Hive-RSI-Lab/ece298a-pll/blocks/pll/tb/README.md

# PLL loop verification (top level, `blocks/pll/tb`)

The proposal's verification plan (section 5) and GOALS.md test the whole loop
in three layers. All three run from one command:

    . $HIVE_BOX/cf.env            # or set CHIP_FLOW_HOME
    $CHIP_FLOW_HOME/bin/eda python blocks/pll/tb/run_layers.py   # ~2.5 min

| Layer | What runs | Script | Output |
|---|---|---|---|
| 1 linear model | open-loop H(s) from the calibrated Icp, Kvco, R1/C1/C2 | `pll_loop_model.py` | `reports/loop_model.json` |
| 2 RTL + calibrated model | released RTL in cocotb/Icarus, pump/filter/VCO as a behavioural ngspice model calibrated from the real netlist | `test_pll_cosim.py` with `PLL_COSIM_KIND=ideal` | `reports/cosim_measures_ideal.json` |
| 3 RTL + transistor cell (the msde `cosim` gate) | released RTL + `analog/netlist/pll_analog.cir` (GF180 models, `sizing.yaml`) in ngspice through cocotbext-ams | `check_cosim.py` on `cosim_bench.json` | `reports/cosim_measures.json` |

Calibration (run it again whenever the analog netlist or sizing changes):

    $CHIP_FLOW_HOME/bin/eda python blocks/pll/tb/calibrate_analog.py

This script measures the real cell at tt_27c in batch ngspice. It writes `pll_analog_cal.json` and regenerates
`pll_analog_ideal.sp` from it.

## Operating point and bounds

Nominal point from the brief: f_ref = 6.25 MHz, n_sel = 2 (P*N = 16), so
f_vco = 100 MHz. Also cp_trim = 00, obs_sel = 0, tt_27c, 3.3 V. rst_n and pll_en_in
are released at 320 ns. The run lasts 30 us. Bounds (`pll_cosim.bounds.json`)
come from the specs, never from results:

| Measure | Bound | Source |
|---|---|---|
| `lock_time_us` (pll_en rise to first lock rise) | <= 50 | digital REQ-LOOP-LOCK; analog spec "Out of scope here"; brief |
| `lock_drops_after_lock` | 0 | lock must hold once asserted (REQ-LOCK-*) |
| `fb_period_rel_err` (mean clk_fb period vs T_ref, last 10 us) | <= 1e-3 | REQ-LOOP-FREQ: divided frequency equals the reference |
| `vco_period_rel_err` (mean vco_out period vs T_ref/16) | <= 1e-3 | REQ-LOOP-FREQ |
| `vctrl_pp_last_10us_mv` (every 5 ns sample of the filter node) | <= 20 | REQ-LOOP-VCTRL |

## Results (2026-10-28)

Calibration of the real cell at tt_27c: Icp up/down = 19.01 / 18.66 uA (the same values as the analog
gate). The fitted filter is R1 = 27.0 kOhm (the brief's 22 k is an estimate; ppolyf_u
150 um x 2 um gives about 26 k), C1 = 20.0 pF and C2 = 2.14 pF (V2I gate included). The VCO reaches
100 MHz at vctrl = 1.634 V, with a local Kvco of 116 MHz/V there.

| | Layer 1 | Layer 2 (ideal) | Layer 3 (transistor) |
|---|---|---|---|
| lock time | settle 4/(zeta wn) = 2.2 us | 4.80 us | **4.48 us** |
| f_fb / f_vco | - | 6.2499 / 99.999 MHz | **6.250000 / 100.000 MHz** |
| vctrl at lock | - | 1.634 V, 18.3 mV p-p | 1.6341 V, 0.003 mV p-p |
| PM / fc (P*N=16, no pad) | 52.4 deg / 585 kHz (f_ref/10.7), zeta 0.71 | - | - |
| wall time | <1 s | ~10 s | ~95 s |

Layer 1 sweep: the phase margin is 55 / 52 / 47 / 43 / 40 deg at P*N = 8 / 16 / 24 / 32 / 40, and
35 deg at P*N = 16 with 5 pF on vctrl. These line up with the analog gate's .ac
numbers (49.5 / 55.3 / 35.9 deg; that gate uses the mean Kvco over the range rather than the
local slope).

## Bench notes

- The digital side is the released RTL. `tb/*.v` symlinks point into `../digital/rtl`,
  and Icarus compiles the SIM path, which has a zero-delay PFD reset. `pll_cosim_top.v` carries the
  crossing nets under their `interface.yaml` names, so the bridge binds them by
  name.
- `pll_analog_tr.sp` reorders the cell's pins into the bridge's order. It loads
  the cell, the PDK models and `sizing.yaml` (paths are resolved at run time). It leaves vctrl
  without a pad, which is the analog spec's nominal loop condition. It puts the **ua[1] pad
  capacitance (5 pF) on bias_ref**. Without any capacitance on bias_ref,
  the bias reference relaxes after pll_en rises (see OPEN in the integrator report).
  The decks that show this are in `log/scratch/bias/`.
- Two bench-side fixes to cocotbext-ams, both in `test_pll_cosim.py`. Neither changes what the bridge
  measures:
  1. *Sync rounding.* The stock sync callback clamps ngspice's step to
     `next_sync - t`. When `t` lands one float rounding short (about 1e-25 s), the clamp
     produces "Timestep too small" and the transient aborts. This is the open quirk in
     `docs/spikes/dcosim.md`. A remainder under 1 fs now counts as reached.
  2. *Write on change.* The stock bridge re-forces vco_out at every sync. Doing that
     at 1 ns syncs crashed vvp (SIGSEGV) after a few hundred forces. vco_out is now
     a reg that is written only when its digitized value changes.
  There is also one timing refinement: a sync is placed 2 ps after every clk rising edge, so
  a PFD edge launched by the reference reaches the pump at once rather than up
  to one sync interval (1 ns) late.
- Resolution: digital edge times sit on the bridge's sync grid (at most 1 ns). Over
  the 10 us window that limits the period measures to about 1e-4, which is ten times finer than
  their 1e-3 bound.
- With the zero-delay RTL PFD there is a dead zone. Once locked, the pump gets
  almost no charge, so vctrl sits flat. The reset-pulse width only exists in the
  gate-level netlist, which this bench does not simulate.
- Not covered yet: other (f_ref, N) points, relock after a change of N, and
  the vctrl pad cap. The bench takes them as parameters (`pll_tb_common.py`,
  `calibrate_analog.py --corner`), but only the nominal point is gated.
  The corners are run on the extracted netlist by `cosim_corners.py` (below).
- Debug knobs, which are not used by the gate: `PLL_COSIM_DURATION_NS`,
  `PLL_COSIM_ANALOG_VCD=<file>` with `PLL_COSIM_DEBUG_NODES=x1.xpll.xcell.vref,...`.

## The loop on the extracted netlist at the corners that bound its range (2026-10-30)

`cosim_corners.py` runs layer 3's bench (`test_pll_cosim.py`, same 100 MHz
point, same bounds and evidence checks as the cosim gate) with the cell
swapped for the layout's parasitic extraction
(`analog/log/pex_pvt/pll_analog.pex.ordered.spice`, extracted when missing)
and the PDK corner, temperature and supply moved to each corner. The bench
reads the move from `PLL_COSIM_SETUP` and the gate never sets it. The
corners are the ones that bound the post-layout sweep
(`analog/reports/recorded/pex_pvt.json`; `bounding_corners()`):

    $CHIP_FLOW_HOME/bin/eda python blocks/pll/tb/cosim_corners.py   # ~25-70 min, 6 corners side by side

A corner takes 25-30 minutes of wall time on a loaded machine (about 50 s
per simulated us, against 3 s for the schematic cell). The result is
recorded in `../reports/recorded/cosim_corners.json` with a hash of every
input. `tests/score.py` counts it only while those hashes hold, as it does
bench_strength's. `--from-logs` rewrites that report from the last run's
`log/cosim_corners/<corner>/result.json` without running anything.

| Corner | Why it bounds the range | Lock | Relock to 150 MHz (N 2->3) | f_vco (MHz) | vctrl mean (V) | vctrl p-p, last 10 us (mV) |
|---|---|---|---|---|---|---|
| ff_pss | lowest Icp 13.6 uA, ceiling 168.2 MHz | 7.20 us, held | 3.44 us | 100.0004 | 2.395 | **23.1** |
| ff_m40c_vm10 | highest ceiling 298.4 MHz | 4.00 us, held | 3.12 us | 100.0004 | 1.546 | 16.7 |
| ff_125c_vp10 | lowest phase margin 40.5 deg | 4.48 us, held | 3.60 us | 100.0000 | 1.864 | 18.0 |
| ss_m40c_vm10 | highest phase margin 51.5 deg | 5.12 us, held | 3.60 us | 99.9999 | 1.940 | 12.3 |
| tt_27c | nominal | 5.12 us, held | 3.60 us | 99.9999 | 1.945 | 12.2 |
| ss_125c_vm10 | lowest ceiling 183.1 MHz | 5.76 us, held | 3.76 us | 100.0000 | 1.953 | 9.7 |
| ss_125c_vp10 | lowest Kvco 53.8 MHz/V | 6.40 us, held | 4.08 us | 100.0030 | 2.412 | 16.1 |

Re-run 2026-11-04 on the V2I/clamp resize (rv2i_l 43 um, clamp 50/1 um),
which lifts the ff_pss ceiling from 125.6 to 168.2 MHz so it relocks to
150 MHz. The loop locks and holds at all seven corners (the six bounding
corners and tt_27c), relocks after the N 2->3 step within 4.1 us, and f_vco is within 1e-5 of its target (bound
1e-3). ff_pss is the one corner over REQ-LOOP-VCTRL's 20 mV p-p, which this
bench keeps as it is. That is not drift: it is isolated pump correction
kicks seen through R1. They come from the bench's zero-delay PFD (its dead
zone, see the bench notes) and from edges quantised to the sync grid. The
gate-level PFD's reset pulse removes them: the same corner reads 2.6 mV
with the gate-level digital (next section).

## With the hardened gate-level digital in the loop (issue #47, 2026-10-31)

`cosim_gl.py` is `cosim_corners.py` with one change: in place of the RTL, the
digital half is the vde harden's gate-level netlist with the PDK's cell
models and an SDF of the corner's process at the nearest characterised
temperature (`sdf_corner_for`). Same bench, operating point, bounds, extracted
analog cell, PDK corner and 0.25 ns sync. The netlist, SDC, SPEF and SDFs it
reads are committed in `gl/`; `--snapshot` refreshes them from a new harden.
`*.gen.sdf` are written by `gl/gen_sdf.tcl`, which LibreLane does not cover.

    $CHIP_FLOW_HOME/bin/eda python blocks/pll/tb/cosim_gl.py   # ~40-50 min, 6 corners side by side

Re-run 2026-11-04 on the V2I/clamp resize, SDF by process and nearest
temperature (`../reports/recorded/cosim_corners_gl.json`, 6/6 pass, all six
bounding corners):

| Corner | Lock | Relock to 150 MHz | f_vco, GL (MHz) | vctrl p-p, RTL / GL (mV) | static phase offset, GL (ns) |
|---|---|---|---|---|---|
| ff_pss | 7.20 us | 4.88 us | 99.9999 | **23.1** / 2.6 | 0.60 |
| ff_m40c_vm10 | 4.00 us | 3.12 us | 100.0021 | 16.7 / 7.2 | 0.90 |
| ff_125c_vp10 | 4.80 us | 3.60 us | 100.0006 | 18.0 / 13.4 | 1.06 |
| ss_m40c_vm10 | 5.12 us | 3.61 us | 100.0004 | 12.3 / 4.6 | 2.37 |
| ss_125c_vm10 | 5.76 us | 3.93 us | 100.0005 | 9.7 / 13.9 | 3.17 |
| ss_125c_vp10 | 6.56 us | 4.09 us | 100.0000 | 16.1 / 15.0 | 3.29 |

The earlier runs, before the resize:

Both runs below are on the TSPC /2 macro (#48) and its extraction, at 0.25 ns
sync. In each pair the RTL comes first and the gate-level run second. The
gate-level column is the first run, SDF by process only
(`../reports/recorded/cosim_corners_gl_sdf_by_process.json`); the matched-temperature
results are under "Outside review follow-ups" below:

| Corner | Lock | f_vco, GL (MHz) | vctrl p-p, RTL (5 ns / ref edges, mV) | vctrl p-p, GL (5 ns / ref edges, mV) | static phase offset (ns) |
|---|---|---|---|---|---|
| ff_pss | 6.72 / 6.72 us | 99.9998 | **27.0** / 1.88 | 2.4 / 0.35 | 0.15 / 0.87 |
| ff_m40c_vm10 | 4.00 / 4.00 us | 100.0009 | **20.3** / 8.37 | 7.2 / 0.91 | 0.10 / 0.89 |
| ff_125c_vp10 | 4.48 / 4.48 us | 100.0005 | 16.9 / 0.03 | 3.5 / 0.38 | 0.15 / 0.85 |
| ss_m40c_vm10 | 4.96 / 5.12 us | 100.0006 | 14.9 / 7.45 | 15.9 / 13.69 | 0.06 / 2.99 |

With the gate-level digital, every corner locks, holds and settles within
REQ-LOOP-VCTRL's 20 mV (`../reports/recorded/cosim_corners_gl.json`, 4/4).
The RTL run on the same cell and the same 0.25 ns grid still misses at
ff_pss and ff_m40c_vm10. So the finer grid H1 found was not enough on its own
after #48. What removes the kicks is the gate-level PFD: its reset path
has a real delay, so both pumps are on together for a short pulse every
cycle (the ~0.9 ns static phase offset is that pulse and the pump mismatch).
With the RTL's zero-delay reset there is no overlap and no reset pulse. One
pump fires alone for whatever phase error is left, rounded to the sync grid,
and that lone current through R1 is the 20-27 mV spike. Sampled at the
reference edges, the RTL's vctrl moves only 0.03-8 mV. The gate-level run is
the one that matches the chip. `tests/score.py` reads it for the "vctrl
settles" line and the RTL run for the lock line. Its freshness check covers
the same tracked inputs plus `cosim_gl.py`, and the netlist and SDF hashes
where `runs/` is present.

At ss_m40c_vm10 the gate-level run has 15.9 mV p-p, with 13.7 mV of it at
the reference edges. That is not a spike through R1. Its trace steps about
7 mV down near 21 us and back up near 24.5 us, and is flat in between: two
corrections that each move the filter capacitor. It passes the bound with
4 mV to spare. It is the corner to watch if the pump or the filter changes.

## Outside review follow-ups (2026-11-01)

From an outside review of the paper (`docs/paper/`). All on the extracted cell
with the gate-level digital. Numbers are recorded in `../reports/recorded/`.

**SDF matched on temperature** (`cosim_corners_gl.json`, 4/4 pass). ff_pss and
ff_m40c_vm10 read the same SDF as before and reproduce exactly. ff_125c_vp10
goes from 3.5 to 13.5 mV p-p and ss_m40c_vm10 from 15.9 to 9.1 mV, so the ripple
depends on the digital delays. ff_pss (27 C) still uses -40 C delays, the
nearest, and the libraries tie voltage to process.

**5 pF on vctrl** (`cosim_gl.py --vctrl-pad-pf 5`,
`cosim_corners_gl_pad5pf.json`, 5/5 pass): lock 4.16-7.52 us, ripple 0.8-4.5 mV.
Small-signal, `layout/pex_pvt.py --extracted <the pad netlist>`
(`pex_pvt_pad5pf.json`; its "fails" are that bench's no-pad 30 deg floor, which
it was not written for): minimum 23.9 deg at ff_125c_vp10, 9 of 31 under 30.

**Divider steps, before the V2I/clamp resize** (`cosim_cov.py`, bench
`cov/test_pll_cov.py`; this run's `cosim_cov.json` has since been replaced by
the final-cell run below, see git history): f_ref 5 MHz, N 1->3->2, 20 us each.
4/5 corners pass. ff_pss misses at 120 MHz,
near its 125.6 MHz ceiling: vctrl winds up to 3.5 V and LOCK pulses before it
settles. `cosim_cov_cases.py` (`cosim_cov_cases.json`) gives it longer: within
20 mV about 25 us after the step, with or without the pad, and when
acquiring 120 MHz directly. No 20 mV bound is applied to these segments, and
some would miss it (24.8 mV at tt_27c).

**Relock to 150 MHz after the V2I/clamp resize** (2026-11-04,
`cosim_cov.py --plan '{"f_ref_hz": 6.25e6, "segments": [[0, 2], [20000, 3], [40000, 2]], "duration_ns": 60000}'`,
`cosim_cov_150.json`, gate-level, 5/5 pass). The resize lifts the ff_pss
post-layout ceiling from 125.6 to 168.2 MHz, and ff_pss now acquires
100 MHz in 7.20 us, relocks to 150 MHz in 4.88 us and back to 100 MHz in
4.72 us. The other corners relock in 3.1-3.8 us. The frequency error is
under 7.4e-5 at every step. The 120 MHz miss above is from before the resize.
N=4 (160 MHz) with the pad at ff_125c_vp10 misses in 30 us and settles with time
(`cosim_cov_pn32_pad5p_long.json`, 80 us: within 20 mV by 27 us).

**Final cell at f_ref 5 MHz** (2026-11-05, analog e687a1c, gate level + SDF,
no pad, 7 corners: the six bounding ones plus tt_27c):

- N 1->3->2 (`cosim_cov.json`): 7/7 pass. Relock at 120 MHz in 4.5-6.7 us
  (ff_pss slowest), at 80 MHz within 5.1 us; ripple at 120 MHz 8.0-23.5 mV
  (not bounded by this bench).
- N=4, 160 MHz from reset (`cosim_cov_n4.json`, logs in `log/cosim_cov_n4/`):
  7/7 lock in 5.2-10.2 us (ff_pss slowest, vctrl 3.22 V), no lock falls,
  ripple 7.2-22.5 mV.
- N=5, 200 MHz from reset (`cosim_cov_n5.json`, logs in `log/cosim_cov_n5/`):
  3/7. ff_m40c_vm10 5.6 us, ff_125c_vp10 5.8 us, tt_27c 7.2 us. At
  ss_125c_vm10, ss_125c_vp10 and ff_pss vctrl ends within 25 mV of VDD and the
  VCO stops at 182.1, 183.8 and 188.9 MHz; ss_m40c_vm10 reaches 198.7 MHz,
  raises LOCK at 18.8 us and drops it. The 200 MHz lock-table points are at or above
  the VCO's range at these corners.

`cosim_cov.py` writes its per-corner logs to `log/cosim_cov/` whatever `--out`
says, so each run overwrites the last; the N=4 and N=5 logs were moved by hand.
The JSON records keep every run's full measures.

### Closed loop with a mismatched pump (`cosim_pump.py`)

The Monte Carlo (`../analog/mc/README.md`) puts UP/DN mismatch over its 10 % bound at
ff_pss and ff_m40c_vp10. Here one pump source is widened by about 3 sigma in a copy of the
extracted netlist, and the gate-level closed loop runs at 100 MHz. `dc` is the cp bench's
sweep on that copy (Monte Carlo worst: 14.55, 12.38).

| Case | dc mismatch (%) | Lock (us) | vctrl p-p, last 10 us (mV) | Static phase offset (ns) |
|---|---|---|---|---|
| ff_pss, unskewed (`cosim_corners_gl.json`) | 8.69 (schematic) | 6.72 | 2.43 | 0.87 |
| ff_pss, UP +6 % | 14.21 | 6.56 | 0.98 | 0.44 |
| ff_pss, DN +6 % | 5.59 | 6.72 | 2.54 | 0.65 |
| ff_m40c_vp10, unskewed | 7.30 | 4.16 | 5.41 | 0.85 |
| ff_m40c_vp10, UP +5 % | 12.08 | 4.00 | 3.29 | 0.60 |
| ff_m40c_vp10, DN +5 % | 5.68 | 4.16 | 6.26 | 0.98 |

All lock and hold, inside the 20 mV bound. UP-heavy skew lowers the ripple: the natural direction
at these corners reads worst on the DC sweep and does the loop no harm at this operating point. Ruling: the 10 % bound
stays as written and the pump is not resized. Not covered: a drawn sample (this is one widened device
pair), other divider settings, N steps, and the pad with skew.

The same cells through an N-step schedule: `--plan` takes a cosim_cov.py plan and runs
its bench per case, into `log/cosim_pump_plan/`:

    $CHIP_FLOW_HOME/bin/eda python blocks/pll/tb/cosim_pump.py \
        --plan '{"f_ref_hz": 6.25e6, "segments": [[0, 2], [20000, 3], [40000, 2]], "duration_ns": 60000}' \
        --out blocks/pll/reports/recorded/cosim_pump_step.json

## Prescaler margin at ss_pff (digital issue 8, 2026-10-29)

`prescaler_margin.py` is not a layer and not a gate. It asks how fast the
first /2 prescaler stage has to be at the corner where the VCO is fastest
against slow digital: ss_pff (ss transistors, fast passives, 125 C, 2.97 V).
It steps a behavioural loop built from `pll_analog_cal_ss_pff.json`, which
`calibrate_analog.py --corner ss_pff` measured on the real netlist. The
model's first stage drops a VCO edge whenever its toggle loop (t_lim) has
not finished since the last toggle. Output: `../reports/prescaler_margin.json`.

    $CHIP_FLOW_HOME/bin/eda python blocks/pll/tb/prescaler_margin.py [--t-lim-ns 3.5]   # ~40 s

Results:
- **Acquisition overshoots.** From vctrl = 0 the VCO peaks at 254 / 280 /
  243 MHz on the way to the 200 MHz points (6.25 MHz x 4, 5 MHz x 5,
  12.5 MHz x 2). The ideal model overshoots more than the transistor cell
  does at tt (145 vs 129 MHz peak for 100 MHz), so these peaks err high.
- **The old prescaler locked up.** The hardened dffrnq_4 loop handled about
  238 MHz at ss (t_lim 4.2 ns). At that speed all three 200 MHz points
  overshoot, the first stage drops edges, clk_fb looks slow, and vctrl runs
  to the rail (310 MHz) and stays there. A loop of 3.65 ns or faster locks at
  every point; at 3.68 ns the 5 MHz x 5 point (peak about 283 MHz) no
  longer does. The new hand-placed dffrnq_2 + inv_1 stage is 3.65 ns at ss
  after routing (STA, without the 0.25 ns uncertainty), so that point has no
  margin before layout. REQ-TIM-VCO holds stage 0 to 3.65 ns at ss.
- **A start at the rail never recovers by itself.** Only a stage that keeps
  up with 310 MHz (t_lim under 3.2 ns, which no library flop reaches at ss)
  would get out. Otherwise the 200 MHz points sit at 310 MHz for good, and
  nothing in the analog cell discharges vctrl when pll_en goes low. With the
  digital's recovery (REQ-RECOVER: 1024 unlocked reference cycles, then 128
  cycles of DN), 6.25 MHz x 4 and 12.5 MHz x 2 lock after one recovery (189
  and 95 us) with a 3.65 ns stage. 5 MHz x 5 overshoots past the stage again
  after the recovery and keeps cycling: it is the point with no margin.
- **False lock from the rail.** 6.25 MHz x 3 started at the rail locks at
  300 MHz, not 150. A stage that drops every other edge divides by 4, and
  that fits the loop exactly, so lock rises and recovery never fires. The
  model's stage drops edges cleanly; a real overclocked flop is messier.
  Either way the cure is a VCO that cannot outrun the stage.
- **Post-layout.** These numbers are the pre-layout netlist's. The
  post-layout corner sweep (task 261029-062920, not merged at the time of
  writing) puts the extracted VCO at ss_pff at 240 MHz with vctrl at the
  rail, and 266 MHz at its fastest corner. Both are below the stage's
  274 MHz, and if they hold, none of the cases above can happen on silicon.
  Rerun this script with a post-layout calibration once that lands.
