Hive-RSI-Lab/ece298a-pll/GOALS.md

# ece298a-pll goals

This repository is the term project of ECE 298A (Integrated Circuit Design and Tapeout) at the University of Waterloo: a charge-pump PLL for one Tiny Tapeout tile on GF180, with a divide-by-8 prescaler and a programmable feedback divider. Its analog half (the bias, the charge pump, the loop filter and the ring VCO) lives in `blocks/pll/analog`, its digital half (the phase-frequency detector, the dividers, the lock detector and the control registers) in `blocks/pll/digital`, and the two meet in `blocks/pll/interface.yaml`. `bash tests/check.sh` is the fast check every pull request has to pass. This is coursework, so runs never submit anything to a course system.

## Proposed goals

Filed by runs. Each says what done looks like as something a run can check, and keeps its status (open, done, failed, dropped) with the pull requests that moved it. At most three are open at once.

### Sign off the PLL's analog half and close what it carries into layout

- **Status:** done 2026-10-29. The owner approved H1-ada9eb, recorded in `blocks/pll/analog/log/H1-signoff.md` (4c90ceb). On 2026-10-28 every analog item closed (#6): the spec sweeps `ss_pff` and `ff_pss` (31 corners), scores `vco_fmax_ff_mhz` at every corner against 150..370 MHz, carries a written jitter estimate in place of the measure that never printed, and corrects the mislabelled 331.75 MHz. spec_lint, sim_pvt and bench_strength pass on it. The digital timing at about 2.7 ns, which this goal's done-line also asked for, is its own goal now (digital issue 8, below, since timed at the post-layout ceiling), so this one closes on its analog work.
- **What:** The analog half has passed every pre-layout check over 29 simulation corners (spec lint, netlist lint, the typical and PVT simulations, and the bench-strength check), and the owner signed it off: `approve H1-ada9eb`, recorded in `blocks/pll/analog/log/H1-signoff.md`. That froze the analog netlist, the spec it is checked against and those results as the reference layout has to match. It also accepted two changes made since the proposal: wider charge-pump current windows, and a phase-margin floor of 30 degrees scored at every corner. The [review](https://github.com/ihsan-sa/ece298a/blob/main/docs/pll-h1-review.md) sets out the results, the thin margins and the open items. A run never approves a sign-off itself. With the approval recorded, the run closed the open items: it put the two resistor-skew corners (`ss_pff`, `ff_pss`) back into the spec, scored the VCO's 333 MHz ceiling at every corner (the VCO reaches about 363 MHz at fast, cold, low supply with its control voltage at the rail), corrected the frequency that the spec's sign-off note mislabels, and reran the analog checks.
- **Done when:** the owner's answer is recorded as the analog sign-off in this repository. If they approved, the analog spec also scores both skew corners and the VCO ceiling at every corner, and the analog spec lint, PVT simulation and bench-strength checks pass on that spec.

### Close digital issue 8: the digital half meets timing with the VCO clock at the post-layout VCO ceiling plus margin

- **Status:** done 2026-10-31 (issue #48, PRs #50 and the integration PR): option (a) below. A TSPC /2 inside the analog macro (netlist block 8, layout in the ring block, DRC and LVS clean, pex_pvt 31/31) gives the digital half vco_div2 = vco/2, and the prescaler is /4 in plain RTL. vco_div2 is timed at twice each process's post-layout ceiling period (ss 7.5, tt and ff 5.4 ns) with 0.20 ns of jitter-derived setup uncertainty, and every STA corner meets setup and hold with no waiver: ss +2.34..+2.39 ns, tt +2.74..+2.77, ff +3.79..+3.80, hold >= +0.51. Earlier: ss tried by design on 2026-10-30 (task 261030-162622, #41), closed to within 0.03 ns but without margin. vco_out is timed per process at the extracted VCO's ceiling plus margin (`harden/constraints.sdc`; `analog/reports/recorded/pex_pvt.json` vco_f_vdd_mhz, vctrl at the rail): ss 3.75 ns (267 MHz) against 263.3 MHz (ss_pff, which is ss, 125 C, -10% supply, the STA corner's own), tt and ff 2.7 ns against 290.7 and 299.5 MHz. At ss the first /2 stage missed by 0.11-0.15 ns, all of it the flow's generic 0.25 ns clock uncertainty. What was tried, with numbers: (c) every library flop and inverter pair at ss in Liberty: only the reset-less dffnq_2 + inv_1 beats dffrnq_2 + inv_1, by 0.095 ns, and without a reset the gate-level sim holds the stage at X; a clock buffer before the flop gains nothing (Liberty barely moves with clock slew); the routed loop loses about 0.12 ns to wire, mostly the 16 um D-to-Q span inside the 20 um flop, and placing the three cells by hand (two layouts, each hardened) read -0.03 ns at ss max against the placer's own +0.004, so placement stays the placer's. (b) vco_out's only vco_out-to-vco_out path is that toggle loop: one clock pin, so no skew, and the ceiling already includes vctrl at the rail and the low supply, so its uncertainty is period jitter alone. The SDC sets it to 0.10 ns (setup, vco_out to vco_out only), derived next to it from the analog spec's jitter estimate (2.5 ps rms at ss, scaled x2.8 for the noise it leaves out, 7 sigma = 83 ps). Over three routed runs ss setup then reads -0.03..+0.004 ns at max_ss, -0.005..+0.022 at nom, +0.015..+0.038 at min (it was -0.11..-0.15), tt +0.79..+0.81, ff +1.57..+1.58, hold unchanged: which ss corners pass depends on how the run routes the D net. That is closure at best, not margin: the stage toggles at about 274 MHz routed, 4% above the ss ceiling, and the jitter allowance takes most of it. Real margin at ss needs (a), a TSPC /2 in the analog macro so the digital half clocks at vco/2 (analog layout, DRC, LVS and pex_pvt 31/31 re-run); no library cell gets there. A recovery forces DN after 1024 unlocked reference cycles, the backstop for a VCO above the stage.
- **What:** The first prescaler stage has to toggle at whatever the VCO reaches, or the feedback divider miscounts and the loop runs away to the rail. Time vco_out at what the extracted VCO can reach on each process, with margin, and meet it at every STA corner. This changes nothing under `blocks/pll/analog`.
- **Done when:** the digital timing gate passes with vco_out at each process's post-layout VCO ceiling plus margin (`tests/score.py` checks the SDC's periods cover the ceilings pex_pvt measures), setup and hold met at every STA corner.

### Test the whole PLL loop in co-simulation

- **Status:** done 2026-10-28. `python blocks/pll/tb/run_layers.py` runs the linear model, the RTL with a calibrated behavioural cell, and the RTL with the transistor-level analog netlist through cocotbext-ams. The last of these is the `cosim` gate, which passes: lock in 4.48 us at 6.25 MHz x 16, VCO at 100.000 MHz, with the lock detector held. `blocks/pll/tb/README.md` writes it up. Only the nominal point is gated.
- **What:** The course grades a system verification of the term project. The proposal (`blocks/pll/brief/proposal-classic-pll.md`) tests the loop as a whole in three layers: a linear model of the loop, the real digital RTL in cocotb with Python models of the pump, filter and VCO calibrated from the analog benches, and a mixed-signal co-simulation of the digital RTL with the analog netlist. Build those benches under `blocks/pll` and run them. This reads the analog half but does not change it, so it can go ahead while the sign-off above is pending.
- **Done when:** the three layers run from one command in this repository, the co-simulation shows the loop locking at the 100 MHz nominal point with the lock detector asserting, and the result is written up next to the benches.

### System verification: the loop locks on the extracted analog netlist at the corners that bound its range

- **Status:** done 2026-10-31 (issue #47). On the TSPC /2 macro's extraction (#48), with the hardened gate-level digital and its SDF in the loop (`blocks/pll/tb/cosim_gl.py`, 0.25 ns sync), the loop locks, holds and settles at all four bounding corners. Lock times are 6.72 / 4.00 / 4.48 / 5.12 us at ff_pss / ff_m40c_vm10 / ff_125c_vp10 / ss_m40c_vm10, with f_vco within 1e-5. vctrl p-p over the last 10 us is 2.4 / 7.2 / 3.5 / 15.9 mV (`blocks/pll/reports/recorded/cosim_corners_gl.json`). The RTL run on the same cell and grid also locks at all four, but has 27.0 and 20.3 mV at ff_pss and ff_m40c_vm10. Those are lone pump kicks through R1 from the RTL's zero-delay PFD reset, which has no reset pulse; the gate-level PFD removes them (`blocks/pll/tb/README.md`). `tests/score.py` reads lock from the RTL record and vctrl from the gate-level one.
- **What:** The course grades a system verification on Nov 26. The cosim gate locks the released RTL with the schematic netlist at tt_27c only. `blocks/pll/tb/cosim_corners.py` runs the same bench, at the same 100 MHz point and bounds, with the cell swapped for the layout's parasitic extraction and the PDK corner, temperature and supply moved to each corner that bounds the post-layout range. It picks those corners from the recorded post-layout sweep (`analog/reports/recorded/pex_pvt.json`): the lowest and highest VCO ceiling (ff_pss 126.4, ff_m40c_vm10 299.5 MHz), the lowest and highest phase margin (ff_125c_vp10 34.5, ss_m40c_vm10 52.9 degrees), and the lowest Kvco and pump current (ff_pss again). A corner takes about 25 minutes of wall time, more than the score's budget, so its result is recorded in `blocks/pll/reports/recorded/cosim_corners.json` with a hash of every input, and counts only while those hashes hold, as bench_strength's does.
- **Done when:** the recorded `cosim_corners.json` shows lock (lock time <= 50 us, no drop, f_fb and f_vco within 0.1 %) and the recorded `cosim_corners_gl.json` (the same bench with the gate-level digital) shows vctrl within 20 mV p-p over the last 10 us, at every corner `bounding_corners()` picks from the recorded pex_pvt, with its inputs unchanged (`tests/score.py`'s two "co-sim locks at 100 MHz on the extracted netlist" lines at 1).

### Lay out the analog half and match it after extraction

- **Status:** done 2026-10-30 (task 261030-095422, #32). DRC (0) and LVS (unique match) pass on `blocks/pll/analog/layout/gen_pll_analog.py` (with the MOS-cap loop filter, #37), and `layout/pex_pvt.py` passes all 31 corners the spec scores on the extracted netlist. The last miss, Kvco 36.1 MHz/V at `ff_pss` against 40, was decided (`analog/spec/spec.md`, revision 2026-10-30). A shorter R_V2I can't move it: at `ff_pss` the VCO's current ceiling sets the top of the range. Most of it was the bench's: it read that top 10..45 ns into its tran, with the bias still settling, 4-8% low. Read over 100..250 ns, `ff_pss` read 40.7 on the MIM-cap layout and 39.9 on the MOS-cap one. The loop's own floor, phase margin >= 30 degrees at P*N = 16 (from the extracted Icp, Kvco and filter impedance), is now a post-layout bound at every corner: 34.5 (ff_125c_vp10) to 52.9 degrees, `ff_pss` 40.3. With that bounded, the post-layout Kvco floor is 30 MHz/V (was 40), where `ff_pss` still keeps about 36 degrees. `tt_pss` converges the same way at every element order: chip-flow 08842a6 reads a recovered gmin step as converged, and 14 shuffles of the extracted netlist's element order (tt_pss, ff_pss) give identical measures. The MOS caps' charge model no longer overflows cosh in the op search (an ngspice error at ff_27c_vm10). The settled ceilings (f at vctrl = vdd) are 126.4 (ff_pss) to 299.5 MHz (ff_m40c_vm10): post-layout, ff_pss keeps lock points up to about 120 MHz, not 150. Earlier on this goal: the ring block was redrawn for less C on r1..r5 (c0301c6), MN_ST was lengthened to 4 um so the bias start-up releases at ss_m40c_vm10 (fc2b47d), and every routed internal net is labelled so magic's extraction keeps its coupling C. Started from pll_en rising with no kick (`layout_ref/pll_analog_pex_start_tb.cir`), the extracted ring runs at all 31 corners with vctrl at vdd-0.3 V, but not with vctrl at 0.3 V at ff_125c or tt_125c (all three supplies each), on the pre-MOS-cap layout. H2 is presented as challenge H2-a9fad5 and waits for the owner.
- **What:** Once the analog sign-off is recorded with the owner's approval, draw the layout of the analog half, pass DRC and LVS against the signed-off netlist, extract its parasitics, and rerun the analog benches on the extracted netlist against the spec's post-layout bounds. Matching, the charge pump's mirrors and the VCO ring's symmetry are the places where layout can eat the thin margins the review lists.
- **Done when:** DRC and LVS pass on the analog layout, and every analog bench passes its post-layout bounds on the extracted netlist at every corner the spec scores.

### Harden the tile and pass the Tiny Tapeout precheck

- **Status:** open, the last step left is on main. 2026-10-31 (H2, issue #46): re-hardened on the current SDC (91ec795 had changed `digital/harden/constraints.sdc` after the last harden, so the recorded passes were stale and gds/ was the old SDC's tile); top_harden (setup WS 2.18 ns, hold WS 0.51 ns, no violations), top_drc, top_lvs and precheck pass again and gds/ is the new GDS. `tests/check.sh` now runs `tests/check_tile.py`, which fails when anything top_harden reads has changed since its recorded pass, or when gds/ is not the GDS top_drc, top_lvs and precheck checked. Earlier (2026-10-30, task 261030-011402): The tile hardens: top_harden, top_drc (magic 0, klayout 0) and top_lvs (unique match) pass, and so does Tiny Tapeout's precheck. The precheck also passes run on the committed `gds/`, `lef/`, `src/project.v` and `info.yaml` themselves. The repository is in the analog template's shape (`blocks/pll/tt/assemble.py`: the real top and RTL in `src/`, an RTL test in `test/`, a 1x2 analog `info.yaml`, the `custom_gds` gds workflow). Getting there took an analog change and three chip-flow fixes. Precheck forbids Metal5 ("KLayout Checks: Forbidden layer Metal5 found"), and a MIM-B cap's top plate is Metal5, so C1/C2 are now MOS caps (cap_nmos_03v3_b), pending the owner's review (`docs/review/README.md`). The chip-flow fixes run from a local copy of the module and are filed as hive-chip-flow work: PR #28, brief 261030-033156 and brief 261030-043908. What's left is the gds, docs and test workflows passing on main.
- **What:** With the analog layout done, harden the digital half around the analog macro into one tile, run full-tile DRC and LVS, and pass the Tiny Tapeout precheck. Replace the template placeholder in `src/` and the template README with the real design, so the Tiny Tapeout gds, docs and test workflows build and test this design rather than the template.
- **Done when:** the tile hardens with no DRC or LVS errors, the Tiny Tapeout precheck passes, and the gds, docs and test workflows pass on main with the real design in `src/`.

### Make every stage reviewable for the Nov 5 evaluation

- **Status:** done 2026-10-30 (task 261030-095433, issue #33). `docs/review/stages.md` lists the 29 gates of the flow in order (spec and split, analog schematic, digital RTL, digital standalone hardening, the whole loop, analog layout, the full tile). Each row says what the gate shows, its last recorded result and what it found, the day it ran, and how to see it work: the file to open, the viewer command (`klayout`, `gtkwave`) and the command that re-runs the gate. It ends with the sign-offs: H1-ada9eb approved, H2-a9fad5 presented and pending. `python3 docs/review/stages.py` writes it from each workspace's `state.json` and `reports/recorded/`, with no EDA tool needed. The decisions taken without the owner, and the pictures, are on the review page task 261030-011402 is writing in `docs/review/`.
- **What:** The owner, 2026-10-29 (chat 261030-010852-f80e292aba): "make sure to make it possible for me to review to work/see it". The course's evaluation is on Nov 5. Put every stage of the flow on one page with its result and a way to see it work, written from the recorded gate reports so it can't drift from them.
- **Done when:** `docs/review/stages.md` lists every gate the flow runs with its recorded result and how to see it, and `python3 docs/review/stages.py --check` passes (the page matches the recorded reports).

## Later

Goals waiting for an open slot. When a proposed goal closes, the run that closed it moves the top one here up into Proposed goals as open.

- Nothing is waiting.

## Closed

What has landed, from the git history (a line per PR).

- #3 Set up the Hive files for pll: goals, test command, lessons; the gds viewer deploys to Pages only from main (2c1fa17).
- #6 Close the analog H1 open items: skew corners, the VCO ceiling at every corner, the jitter estimate; gates pass on 31 corners (ed2dbc0).
- #8 pll gets a score: `tests/score.sh`, the share of the goals' checkable done-lines that pass, re-run from scratch (c5c9acd).
- #14 The analog layout's post-layout benches run on the extracted netlist at all 31 corners the spec scores, with every routed internal net labelled so extraction keeps its coupling C; 29 of 31 pass (e4771cf).
- #15 Digital issue 8: a faster /2 prescaler stage, runaway recovery, the ss 2.7 ns corner waived with its numbers (f1aa1a9).
- Before this repository's pull requests, the work was committed to the `track/pll` branch. Four commits from that history carry pull-request numbers from the repository they were merged in, which are not this repository's: the check workflow (b1bf703, "#1"), the owner's analog sign-off H1-ada9eb (4c90ceb, "#6"), the Tiny Tapeout datasheet and pinout (665547c, "#10"), and iverilog through chip-flow's eda in `check.sh` (7f314a1, "#9").
