Hive-RSI-Lab/ece298a-pll/docs/paper/figs/tspc_wave.pdf

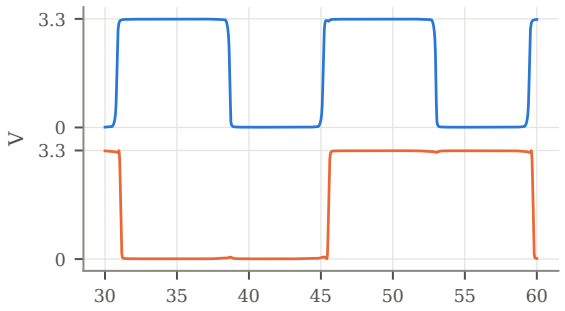
[picture p12: figure]

### time (ns)

vco_out (internal) | vco_div2 (pin), offset -4 V
