Hive-RSI-Lab/ece298a-pll/.hive/lessons.md

# Lessons

What was reverted here and why, so the next run doesn't repeat it.

- Nothing reverted yet.
