Hive-RSI-Lab/ece298a-pll/docs/paper/figs/chargepump.pdf

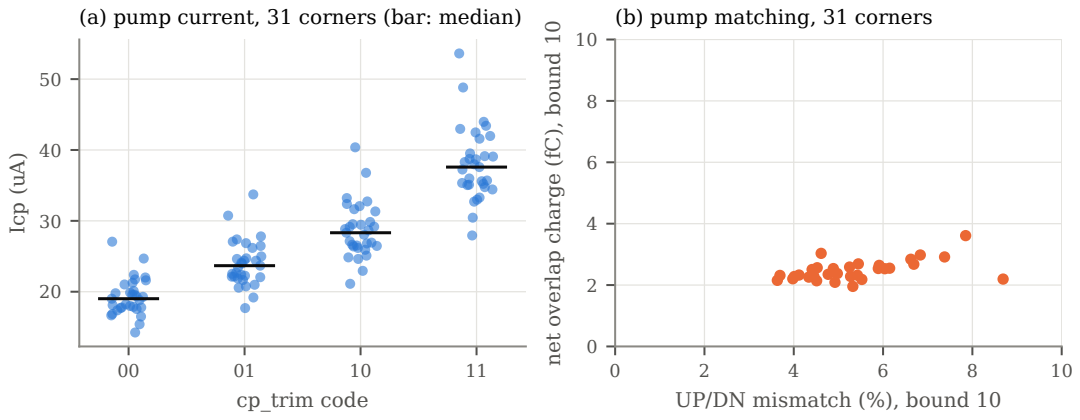
[picture p13: page 1]
cp_trim code; Icp (uA)

(a) pump current, 31 corners (bar: median)

net overlap charge (fC), bound 10

(b) pump matching, 31 corners

UP/DN mismatch (%), bound 10
