Hive-RSI-Lab/ece298a-pll/docs/paper/figs/lock.pdf

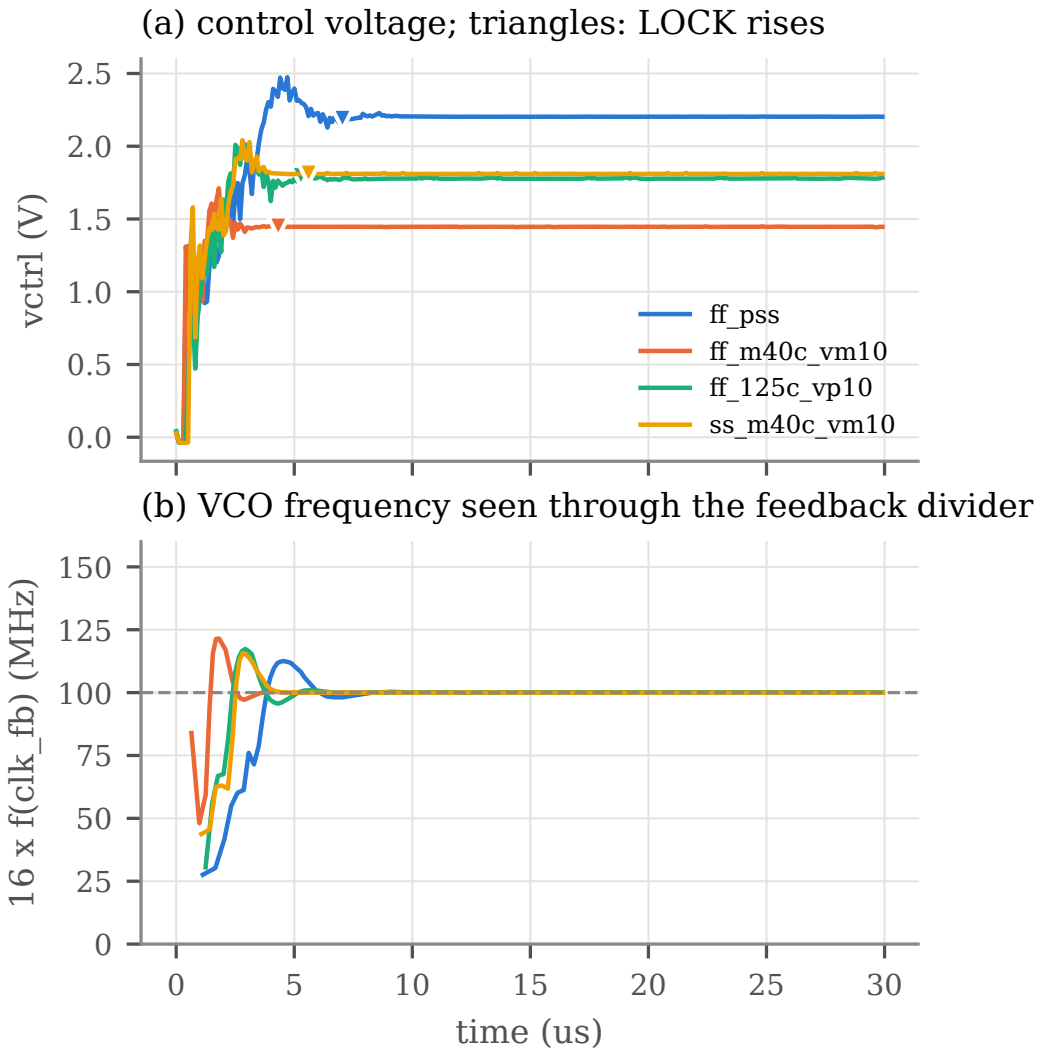
[picture p14: page 1]
vctrl (V); ff_pss ff_m40c_vm10 ff_125c_vp10 ss_m40c_vm10; time (us); 16 x f(clk_fb) (MHz)

(a) control voltage; triangles: LOCK rises

(b) VCO frequency seen through the feedback divider
