Hive-RSI-Lab/ece298a-pll/docs/paper/figs/bode.pdf

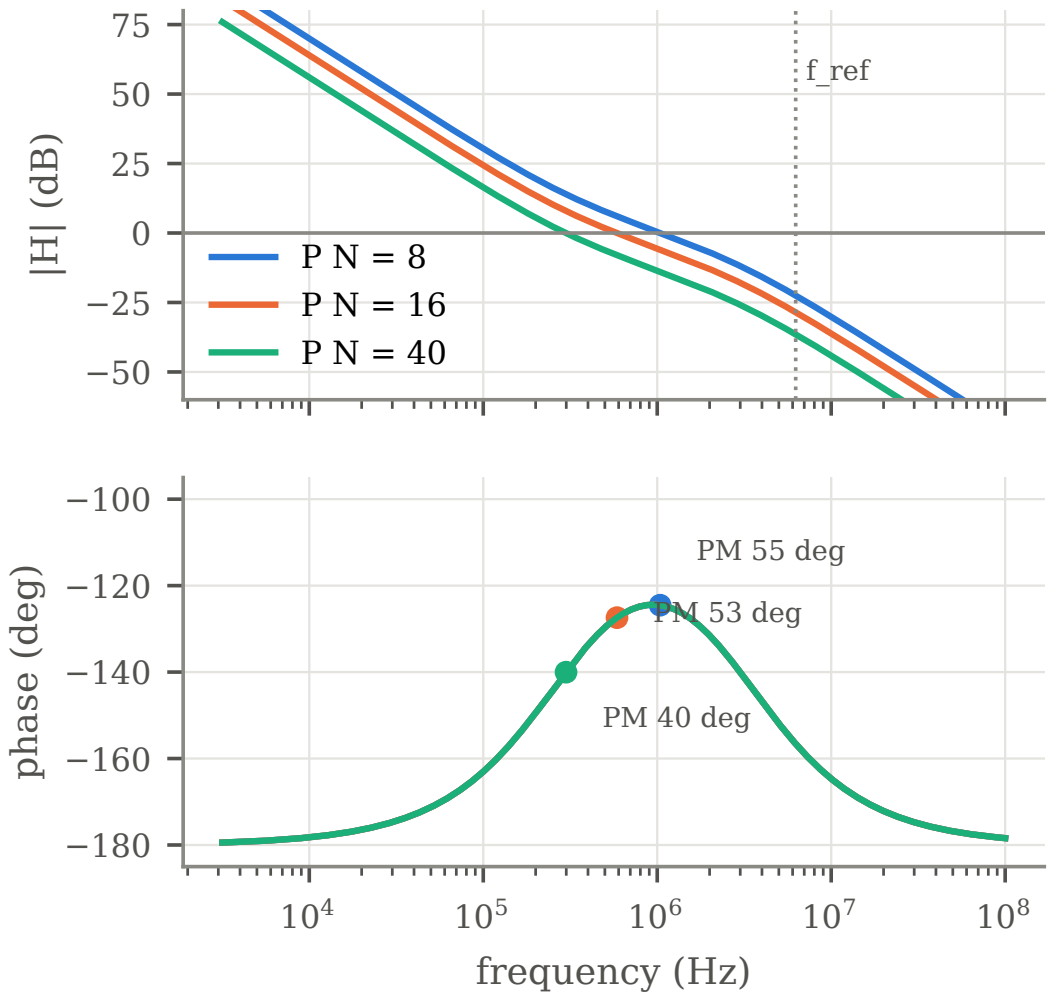
[picture p15: page 1]
f_ref; frequency (Hz); phase (deg); PM 55 deg; PM 53 deg; PM 40 deg
