Hive-RSI-Lab/ece298a-pll/docs/paper/figs/cov.pdf

3.0

3.5

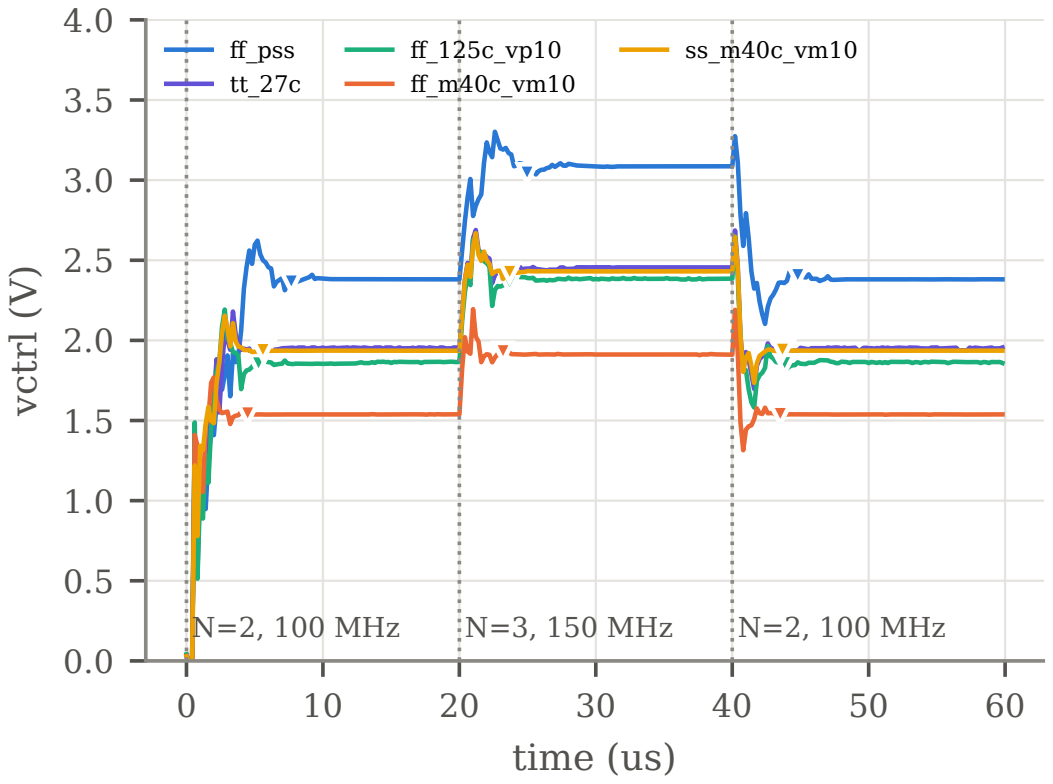
[picture p16: page 1]
time (us); vctrl (V); N=2, 100 MHz; N=3, 150 MHz; ff_pss tt_27c
