Hive-RSI-Lab/ece298a-pll/docs/paper/figs/vco_tuning.pdf

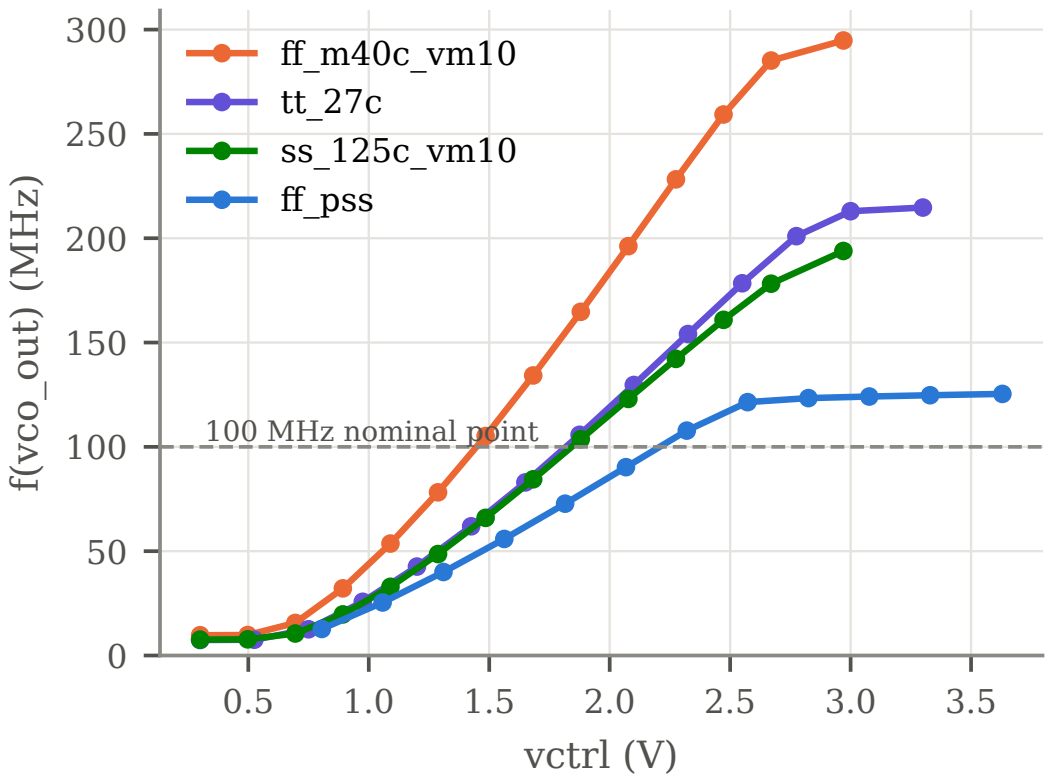
[picture p17: page 1]
vctrl (V); f(vco_out) (MHz); 100 MHz nominal point ff_m40c_vm10 tt_27c ss_125c_vm10 ff_pss
