Hive-RSI-Lab/ece298a-pll/blocks/pll/analog/log/pex_sim/pll_analog.pex.ordered.spice

* NGSPICE file created from pll_analog.ext - technology: gf180mcuD

.subckt pll_analog vco_out pfd_up pfd_dn pll_en cp_trim0 cp_trim1 vctrl bias_ref vdd vss
X0 nb.t2 r5.t9 vdd.t72 vdd.t71 pfet_03v3 ad=0.52p pd=2.52u as=1.3p ps=5.3u w=2u l=0.28u
X1 a_17258_0.t1 r3.t4 r4.t2 vss.t38 nfet_03v3 ad=0.915p pd=4.22u as=0.39p ps=2.02u w=1.5u l=0.28u
X2 a_14400_19930# a_13800_12478# vss.t41 ppolyf_u r_width=1u r_length=36.6u
X3 vdump.t7 vdump.t6 vbt.t3 vdd.t26 pfet_03v3 ad=3.25p pd=11.3u as=3.25p ps=11.3u w=5u l=1u
X4 t1a.t0 vbp.t12 vdd.t28 vdd.t27 pfet_03v3 ad=2.6p pd=9.3u as=2.6p ps=9.3u w=4u l=2u
X5 vss.t119 vbn_vco.t13 a_15650_0.t2 vss.t118 nfet_03v3 ad=1.22p pd=5.22u as=0.52p ps=2.52u w=2u l=0.5u
X6 vcp_n.t4 cp_trim1.t1 t2.t1 vss.t78 nfet_03v3 ad=1.22p pd=5.22u as=1.22p ps=5.22u w=2u l=0.28u
X7 vfilt vss.t29 cap_mim_2f0_m4m5_noshield c_width=100u c_length=100u
X8 a_18062_0.t2 vbn_vco.t8 vss.t86 vss.t85 nfet_03v3 ad=0.52p pd=2.52u as=1.22p ps=5.22u w=2u l=0.5u
X9 a_18058_1524.t3 vbp_vco.t10 vdd.t98 vdd.t97 pfet_03v3 ad=1.3p pd=5.52u as=3.25p ps=11.3u w=5u l=0.5u
X10 up_b.t0 pfd_up.t2 vss.t83 vss.t82 nfet_03v3 ad=0.61p pd=3.22u as=0.61p ps=3.22u w=1u l=0.28u
X11 a_17258_0.t0 vbn_vco.t10 vss.t25 vss.t24 nfet_03v3 ad=0.52p pd=2.52u as=1.22p ps=5.22u w=2u l=0.5u
X12 vdd.t84 pll_en.t2 nb.t4 vdd.t83 pfet_03v3 ad=1.3p pd=5.3u as=0.52p ps=2.52u w=2u l=0.28u
X13 vnt.t5 vref.t5 vss.t134 vss.t133 nfet_03v3 ad=1.22p pd=5.22u as=1.22p ps=5.22u w=2u l=2u
X14 vdump.t17 pfd_up.t0 up_s.t3 vdd.t63 pfet_03v3 ad=2.6p pd=9.3u as=2.6p ps=9.3u w=4u l=0.5u
X15 a_10800_19930# a_11400_12478# vss.t105 ppolyf_u r_width=1u r_length=36.6u
X16 vdump.t13 vbh.t6 vdd.t90 vdd.t89 pfet_03v3 ad=2.6p pd=9.3u as=2.6p ps=9.3u w=4u l=2u
X17 vnt.t4 vref.t9 vss.t121 vss.t120 nfet_03v3 ad=1.22p pd=5.22u as=1.22p ps=5.22u w=2u l=2u
X18 vcp_n.t7 en_b.t7 vss.t5 vss.t4 nfet_03v3 ad=0.61p pd=3.22u as=0.61p ps=3.22u w=1u l=0.28u
X19 a_18866_0.t3 vbn_vco.t6 vss.t142 vss.t141 nfet_03v3 ad=0.52p pd=2.52u as=1.22p ps=5.22u w=2u l=0.5u
X20 vi.t2 vref.t10 vss.t125 vss.t124 nfet_03v3 ad=1.22p pd=5.22u as=1.22p ps=5.22u w=2u l=2u
X21 vbh.t1 vbh.t0 vdd.t10 vdd.t9 pfet_03v3 ad=2.6p pd=9.3u as=2.6p ps=9.3u w=4u l=2u
X22 vi.t3 vctrl.t5 vs.t1 vss.t137 nfet_03v3 ad=3.05p pd=11.22u as=3.05p ps=11.22u w=5u l=1u
X23 up_s.t1 vcp_p.t8 vdd.t23 vdd.t22 pfet_03v3 ad=16.25p pd=51.3u as=16.25p ps=51.3u w=25u l=2u
X24 r3.t1 r2.t5 a_15650_0.t1 vss.t37 nfet_03v3 ad=0.39p pd=2.02u as=0.915p ps=4.22u w=1.5u l=0.28u
X25 vcp_p.t2 vcp_p.t1 vdd.t88 vdd.t87 pfet_03v3 ad=16.25p pd=51.3u as=16.25p ps=51.3u w=25u l=2u
X26 vbt.t7 vbp.t15 vdd.t59 vdd.t58 pfet_03v3 ad=2.6p pd=9.3u as=2.6p ps=9.3u w=4u l=2u
X27 a_6600_18610# a_7200_12478# vss.t9 ppolyf_u r_width=1u r_length=30u
X28 a_18062_0.t0 r5.t6 r1.t1 vss.t63 nfet_03v3 ad=0.915p pd=4.22u as=0.39p ps=2.02u w=1.5u l=0.28u
X29 vdd.t14 vbp_vco.t11 a_17254_1524.t0 vdd.t13 pfet_03v3 ad=3.25p pd=11.3u as=1.3p ps=5.52u w=5u l=0.5u
X30 vdd.t119 vbp_vco.t7 a_18862_1524.t2 vdd.t118 pfet_03v3 ad=3.25p pd=11.3u as=1.3p ps=5.52u w=5u l=0.5u
X31 vbt.t4 vbp.t7 vdd.t12 vdd.t11 pfet_03v3 ad=2.6p pd=9.3u as=2.6p ps=9.3u w=4u l=2u
X32 r2.t0 r1.t7 a_16450_1524.t0 vdd.t42 pfet_03v3 ad=0.78p pd=3.52u as=1.95p ps=7.3u w=3u l=0.28u
X33 vst.t2 vref.t4 vss.t81 vss.t80 nfet_03v3 ad=3.05p pd=11.22u as=3.05p ps=11.22u w=5u l=1u
X34 va.t0 vref.t7 vss.t52 vss.t51 nfet_03v3 ad=1.22p pd=5.22u as=1.22p ps=5.22u w=2u l=2u
X35 up_s.t0 vcp_p.t7 vdd.t19 vdd.t18 pfet_03v3 ad=16.25p pd=51.3u as=16.25p ps=51.3u w=25u l=2u
X36 vctrl.t2 a_400_12478# vss.t126 ppolyf_u r_width=2u r_length=37.5u
X37 a_13200_19930# a_12600_12478# vss.t54 ppolyf_u r_width=1u r_length=36.6u
X38 vbh.t3 vbh.t2 vdd.t65 vdd.t64 pfet_03v3 ad=2.6p pd=9.3u as=2.6p ps=9.3u w=4u l=2u
X39 vcp_n.t2 vbp.t14 vdd.t49 vdd.t48 pfet_03v3 ad=2.6p pd=9.3u as=2.6p ps=9.3u w=4u l=2u
X40 vs.t0 a_4200_12478# vss.t84 ppolyf_u r_width=1u r_length=17.5u
X41 r5.t1 r4.t7 a_18862_1524.t0 vdd.t110 pfet_03v3 ad=0.78p pd=3.52u as=1.95p ps=7.3u w=3u l=0.28u
X42 vcp_n.t1 vbp.t6 vdd.t36 vdd.t35 pfet_03v3 ad=2.6p pd=9.3u as=2.6p ps=9.3u w=4u l=2u
X43 a_17254_1524.t3 r3.t6 r4.t0 vdd.t0 pfet_03v3 ad=1.95p pd=7.3u as=0.78p ps=3.52u w=3u l=0.28u
X44 a_15646_1524.t1 r2.t6 r3.t2 vdd.t68 pfet_03v3 ad=1.95p pd=7.3u as=0.78p ps=3.52u w=3u l=0.28u
X45 a_18862_1524.t1 r4.t6 r5.t0 vdd.t101 pfet_03v3 ad=1.95p pd=7.3u as=0.78p ps=3.52u w=3u l=0.28u
X46 vcp_p.t4 vcp_p.t3 vdd.t34 vdd.t33 pfet_03v3 ad=16.25p pd=51.3u as=16.25p ps=51.3u w=25u l=2u
X47 vbp.t3 vbp.t2 vdd.t112 vdd.t111 pfet_03v3 ad=2.6p pd=9.3u as=2.6p ps=9.3u w=4u l=2u
X48 bias_ref.t1 a_10200_12478# vss.t43 ppolyf_u r_width=1u r_length=36.6u
X49 vdd.t53 nb.t10 vco_out.t4 vdd.t52 pfet_03v3 ad=1.95p pd=7.3u as=0.78p ps=3.52u w=3u l=0.28u
X50 vbn_vco.t1 vbn_vco.t0 vss.t7 vss.t6 nfet_03v3 ad=2.44p pd=9.22u as=2.44p ps=9.22u w=4u l=0.5u
X51 t2.t2 vbp.t13 vdd.t94 vdd.t93 pfet_03v3 ad=2.6p pd=9.3u as=2.6p ps=9.3u w=4u l=2u
X52 a_1200_20110# a_400_12478# vss.t73 ppolyf_u r_width=2u r_length=37.5u
X53 bias_ref.t0 a_8400_12478# vss.t42 ppolyf_u r_width=1u r_length=30u
X54 r2.t2 r1.t5 a_16454_0.t2 vss.t68 nfet_03v3 ad=0.39p pd=2.02u as=0.915p ps=4.22u w=1.5u l=0.28u
X55 vbl.t6 vctrl.t11 vbt.t8 vdd.t113 pfet_03v3 ad=3.25p pd=11.3u as=3.25p ps=11.3u w=5u l=1u
X56 vbl.t5 vctrl.t8 vbt.t11 vdd.t116 pfet_03v3 ad=3.25p pd=11.3u as=3.25p ps=11.3u w=5u l=1u
X57 a_18866_0.t1 r4.t4 r5.t3 vss.t103 nfet_03v3 ad=0.915p pd=4.22u as=0.39p ps=2.02u w=1.5u l=0.28u
X58 a_16450_1524.t3 vbp_vco.t14 vdd.t109 vdd.t108 pfet_03v3 ad=1.3p pd=5.52u as=3.25p ps=11.3u w=5u l=0.5u
X59 t1b.t0 vbp.t10 vdd.t55 vdd.t54 pfet_03v3 ad=2.6p pd=9.3u as=2.6p ps=9.3u w=4u l=2u
X60 vcp_p.t6 vcp_n.t12 vss.t77 vss.t76 nfet_03v3 ad=6.1p pd=21.22u as=6.1p ps=21.22u w=10u l=2u
X61 vbt.t5 vbp.t5 vdd.t47 vdd.t46 pfet_03v3 ad=2.6p pd=9.3u as=2.6p ps=9.3u w=4u l=2u
X62 vbn_vco.t4 en_b.t2 vss.t113 vss.t112 nfet_03v3 ad=0.61p pd=3.22u as=0.61p ps=3.22u w=1u l=0.28u
X63 vbt.t6 vbp.t17 vdd.t57 vdd.t56 pfet_03v3 ad=2.6p pd=9.3u as=2.6p ps=9.3u w=4u l=2u
X64 a_18862_1524.t3 vbp_vco.t8 vdd.t121 vdd.t120 pfet_03v3 ad=1.3p pd=5.52u as=3.25p ps=11.3u w=5u l=0.5u
X65 va.t1 vbp.t11 vdd.t92 vdd.t91 pfet_03v3 ad=2.6p pd=9.3u as=2.6p ps=9.3u w=4u l=2u
X66 a_14400_19930# a_15000_12478# vss.t23 ppolyf_u r_width=1u r_length=36.6u
X67 a_16454_0.t3 vbn_vco.t12 vss.t117 vss.t116 nfet_03v3 ad=0.52p pd=2.52u as=1.22p ps=5.22u w=2u l=0.5u
X68 vss.t62 nb.t6 vco_out.t1 vss.t61 nfet_03v3 ad=1.83p pd=7.22u as=0.78p ps=3.52u w=3u l=0.28u
X69 vref.t0 a_6000_12478# vss.t28 ppolyf_u r_width=1u r_length=30u
X70 vss.t102 vbn_vco.t5 a_18866_0.t0 vss.t101 nfet_03v3 ad=1.22p pd=5.22u as=0.52p ps=2.52u w=2u l=0.5u
X71 vdump.t1 vdump.t0 vbt.t2 vdd.t17 pfet_03v3 ad=3.25p pd=11.3u as=3.25p ps=11.3u w=5u l=1u
X72 up_b.t1 pfd_up.t1 vdd.t62 vdd.t61 pfet_03v3 ad=1.3p pd=5.3u as=1.3p ps=5.3u w=2u l=0.28u
X73 t2.t0 vbp.t9 vdd.t38 vdd.t37 pfet_03v3 ad=2.6p pd=9.3u as=2.6p ps=9.3u w=4u l=2u
X74 nb.t1 r5.t5 a_19968_0.t1 vss.t11 nfet_03v3 ad=0.52p pd=2.52u as=1.22p ps=5.22u w=2u l=0.28u
X75 vbn_vco.t2 vbp_vco.t17 vdd.t30 vdd.t29 pfet_03v3 ad=3.25p pd=11.3u as=3.25p ps=11.3u w=5u l=0.5u
X76 vbl.t3 vbl.t2 vss.t49 vss.t48 nfet_03v3 ad=1.22p pd=5.22u as=1.22p ps=5.22u w=2u l=2u
X77 a_15650_0.t3 vbn_vco.t14 vss.t144 vss.t143 nfet_03v3 ad=0.52p pd=2.52u as=1.22p ps=5.22u w=2u l=0.5u
X78 vcp_n.t3 cp_trim1.t0 t1c.t0 vss.t79 nfet_03v3 ad=1.22p pd=5.22u as=1.22p ps=5.22u w=2u l=0.28u
X79 vst.t3 vref.t3 vss.t108 vss.t107 nfet_03v3 ad=3.05p pd=11.22u as=3.05p ps=11.22u w=5u l=1u
X80 vbp_vco.t6 pll_en.t4 vi.t1 vss.t94 nfet_03v3 ad=3.05p pd=11.22u as=3.05p ps=11.22u w=5u l=0.28u
X81 vcp_n.t0 vbp.t16 vdd.t25 vdd.t24 pfet_03v3 ad=2.6p pd=9.3u as=2.6p ps=9.3u w=4u l=2u
X82 vcp_n.t11 vcp_n.t10 vss.t90 vss.t89 nfet_03v3 ad=6.1p pd=21.22u as=6.1p ps=21.22u w=10u l=2u
X83 a_12000_19930# a_11400_12478# vss.t104 ppolyf_u r_width=1u r_length=36.6u
X84 vdd.t103 vbp_vco.t15 a_15646_1524.t2 vdd.t102 pfet_03v3 ad=3.25p pd=11.3u as=1.3p ps=5.52u w=5u l=0.5u
X85 vst.t0 en_b.t5 vss.t19 vss.t18 nfet_03v3 ad=0.61p pd=3.22u as=0.61p ps=3.22u w=1u l=0.28u
X86 vnt.t3 vref.t6 vss.t115 vss.t114 nfet_03v3 ad=1.22p pd=5.22u as=1.22p ps=5.22u w=2u l=2u
X87 a_1200_20110# a_2000_12478# vss.t99 ppolyf_u r_width=2u r_length=37.5u
X88 vcl.t4 vref.t14 vss.t123 vss.t122 nfet_03v3 ad=6.1p pd=21.22u as=6.1p ps=21.22u w=10u l=2u
X89 vdump.t9 vdump.t8 vnt.t2 vss.t106 nfet_03v3 ad=3.05p pd=11.22u as=3.05p ps=11.22u w=5u l=1u
X90 vbp_vco.t5 pll_en.t5 vi.t0 vss.t93 nfet_03v3 ad=3.05p pd=11.22u as=3.05p ps=11.22u w=5u l=0.28u
X91 vcl.t2 vref.t13 vss.t60 vss.t59 nfet_03v3 ad=6.1p pd=21.22u as=6.1p ps=21.22u w=10u l=2u
X92 r4.t3 r3.t5 a_17258_0.t2 vss.t39 nfet_03v3 ad=0.39p pd=2.02u as=0.915p ps=4.22u w=1.5u l=0.28u
X93 vdd.t40 nb.t8 vco_out.t2 vdd.t39 pfet_03v3 ad=1.95p pd=7.3u as=0.78p ps=3.52u w=3u l=0.28u
X94 dn_b.t0 pfd_dn.t1 vss.t33 vss.t32 nfet_03v3 ad=0.61p pd=3.22u as=0.61p ps=3.22u w=1u l=0.28u
X95 vbl.t7 vctrl.t10 vbt.t9 vdd.t114 pfet_03v3 ad=3.25p pd=11.3u as=3.25p ps=11.3u w=5u l=1u
X96 vctrl.t1 up_b.t2 up_s.t2 vdd.t60 pfet_03v3 ad=2.6p pd=9.3u as=2.6p ps=9.3u w=4u l=0.5u
X97 vco_out.t0 nb.t9 vdd.t8 vdd.t7 pfet_03v3 ad=0.78p pd=3.52u as=1.95p ps=7.3u w=3u l=0.28u
X98 vcp_n.t9 vcp_n.t8 vss.t13 vss.t12 nfet_03v3 ad=6.1p pd=21.22u as=6.1p ps=21.22u w=10u l=2u
X99 r4.t1 r3.t7 a_17254_1524.t2 vdd.t1 pfet_03v3 ad=0.78p pd=3.52u as=1.95p ps=7.3u w=3u l=0.28u
X100 r3.t3 r2.t7 a_15646_1524.t0 vdd.t69 pfet_03v3 ad=0.78p pd=3.52u as=1.95p ps=7.3u w=3u l=0.28u
X101 vcp_n.t5 vbp.t8 vdd.t67 vdd.t66 pfet_03v3 ad=2.6p pd=9.3u as=2.6p ps=9.3u w=4u l=2u
X102 vcp_n.t6 cp_trim0.t1 t1a.t1 vss.t109 nfet_03v3 ad=1.22p pd=5.22u as=1.22p ps=5.22u w=2u l=0.28u
X103 vdump.t16 vbl.t8 vss.t35 vss.t34 nfet_03v3 ad=1.22p pd=5.22u as=1.22p ps=5.22u w=2u l=2u
X104 vco_out.t3 nb.t11 vdd.t45 vdd.t44 pfet_03v3 ad=0.78p pd=3.52u as=1.95p ps=7.3u w=3u l=0.28u
X105 vdump.t5 vdump.t4 vbt.t0 vdd.t117 pfet_03v3 ad=3.25p pd=11.3u as=3.25p ps=11.3u w=5u l=1u
X106 vcl.t1 vref.t12 vss.t58 vss.t57 nfet_03v3 ad=6.1p pd=21.22u as=6.1p ps=21.22u w=10u l=2u
X107 vdump.t11 vdump.t10 vnt.t1 vss.t100 nfet_03v3 ad=3.05p pd=11.22u as=3.05p ps=11.22u w=5u l=1u
X108 t1c.t1 cp_trim0.t0 t1b.t1 vss.t110 nfet_03v3 ad=1.22p pd=5.22u as=1.22p ps=5.22u w=2u l=0.28u
X109 vi.t4 vctrl.t4 vs.t2 vss.t138 nfet_03v3 ad=3.05p pd=11.22u as=3.05p ps=11.22u w=5u l=1u
X110 a_7800_18610# a_7200_12478# vss.t145 ppolyf_u r_width=1u r_length=30u
X111 vbh.t4 vctrl.t7 vnt.t6 vss.t135 nfet_03v3 ad=3.05p pd=11.22u as=3.05p ps=11.22u w=5u l=1u
X112 a_15650_0.t0 r2.t4 r3.t0 vss.t36 nfet_03v3 ad=0.915p pd=4.22u as=0.39p ps=2.02u w=1.5u l=0.28u
X113 a_18058_1524.t1 r5.t10 r1.t2 vdd.t70 pfet_03v3 ad=1.95p pd=7.3u as=0.78p ps=3.52u w=3u l=0.28u
X114 vss.t128 vbn_vco.t7 a_18062_0.t3 vss.t127 nfet_03v3 ad=1.22p pd=5.22u as=0.52p ps=2.52u w=2u l=0.5u
X115 r1.t0 r5.t7 a_18062_0.t1 vss.t64 nfet_03v3 ad=0.39p pd=2.02u as=0.915p ps=4.22u w=1.5u l=0.28u
X116 vnt.t0 vref.t8 vss.t1 vss.t0 nfet_03v3 ad=1.22p pd=5.22u as=1.22p ps=5.22u w=2u l=2u
X117 en_b.t1 pll_en.t7 vdd.t78 vdd.t77 pfet_03v3 ad=1.3p pd=5.3u as=1.3p ps=5.3u w=2u l=0.28u
X118 a_13200_19930# a_13800_12478# vss.t45 ppolyf_u r_width=1u r_length=36.6u
X119 vcl.t0 a_4200_12478# vss.t40 ppolyf_u r_width=1u r_length=17.5u
X120 a_15646_1524.t3 vbp_vco.t16 vdd.t105 vdd.t104 pfet_03v3 ad=1.3p pd=5.52u as=3.25p ps=11.3u w=5u l=0.5u
X121 a_17254_1524.t1 vbp_vco.t12 vdd.t16 vdd.t15 pfet_03v3 ad=1.3p pd=5.52u as=3.25p ps=11.3u w=5u l=0.5u
X122 vctrl.t3 vss.t139 cap_mim_2f0_m4m5_noshield c_width=32u c_length=32u
X123 vss.t88 vbn_vco.t9 a_17258_0.t3 vss.t87 nfet_03v3 ad=1.22p pd=5.22u as=0.52p ps=2.52u w=2u l=0.5u
X124 a_19968_0.t2 pll_en.t1 vss.t98 vss.t97 nfet_03v3 ad=0.52p pd=2.52u as=1.22p ps=5.22u w=2u l=0.28u
X125 vref.t1 en_b.t3 vss.t3 vss.t2 nfet_03v3 ad=0.61p pd=3.22u as=0.61p ps=3.22u w=1u l=0.28u
X126 vdd.t86 r5.t8 nb.t5 vdd.t85 pfet_03v3 ad=1.3p pd=5.3u as=0.52p ps=2.52u w=2u l=0.28u
X127 vbp.t0 vst.t4 vss.t75 vss.t74 nfet_03v3 ad=0.305p pd=2.22u as=0.305p ps=2.22u w=0.5u l=2u
X128 vbp.t4 va.t3 vref.t2 vss.t130 nfet_03v3 ad=2.44p pd=9.22u as=2.44p ps=9.22u w=4u l=1u
X129 vfilt a_2000_12478# vss.t22 ppolyf_u r_width=2u r_length=37.5u
X130 vss.t27 vbn_vco.t11 a_16454_0.t0 vss.t26 nfet_03v3 ad=1.22p pd=5.22u as=0.52p ps=2.52u w=2u l=0.5u
X131 vbp.t1 pll_en.t8 vdd.t76 vdd.t75 pfet_03v3 ad=0.65p pd=3.3u as=0.65p ps=3.3u w=1u l=0.28u
X132 a_10800_19930# a_10200_12478# vss.t44 ppolyf_u r_width=1u r_length=36.6u
X133 vbl.t4 vctrl.t9 vbt.t10 vdd.t115 pfet_03v3 ad=3.25p pd=11.3u as=3.25p ps=11.3u w=5u l=1u
X134 vst.t1 en_b.t6 vdd.t51 vdd.t50 pfet_03v3 ad=0.325p pd=2.3u as=0.325p ps=2.3u w=0.5u l=10u
X135 va.t2 en_b.t4 vss.t47 vss.t46 nfet_03v3 ad=0.61p pd=3.22u as=0.61p ps=3.22u w=1u l=0.28u
X136 vctrl.t0 pfd_dn.t2 dn_s.t1 vss.t31 nfet_03v3 ad=1.22p pd=5.22u as=1.22p ps=5.22u w=2u l=0.5u
X137 a_16454_0.t1 r1.t4 r2.t3 vss.t67 nfet_03v3 ad=0.915p pd=4.22u as=0.39p ps=2.02u w=1.5u l=0.28u
X138 vdd.t96 vbp_vco.t9 a_18058_1524.t2 vdd.t95 pfet_03v3 ad=3.25p pd=11.3u as=1.3p ps=5.52u w=5u l=0.5u
X139 vdd.t107 vbp_vco.t13 a_16450_1524.t2 vdd.t106 pfet_03v3 ad=3.25p pd=11.3u as=1.3p ps=5.52u w=5u l=0.5u
X140 vss.t21 a_15000_12478# vss.t20 ppolyf_u r_width=1u r_length=36.6u
X141 vbh.t5 vctrl.t6 vnt.t7 vss.t136 nfet_03v3 ad=3.05p pd=11.22u as=3.05p ps=11.22u w=5u l=1u
X142 a_6600_18610# a_6000_12478# vss.t53 ppolyf_u r_width=1u r_length=30u
X143 vdump.t14 dn_b.t2 dn_s.t3 vss.t50 nfet_03v3 ad=1.22p pd=5.22u as=1.22p ps=5.22u w=2u l=0.5u
X144 vcp_p.t5 vcp_n.t15 vss.t72 vss.t71 nfet_03v3 ad=6.1p pd=21.22u as=6.1p ps=21.22u w=10u l=2u
X145 vdump.t15 vbl.t9 vss.t66 vss.t65 nfet_03v3 ad=1.22p pd=5.22u as=1.22p ps=5.22u w=2u l=2u
X146 vbn_vco.t3 vbp_vco.t18 vdd.t32 vdd.t31 pfet_03v3 ad=3.25p pd=11.3u as=3.25p ps=11.3u w=5u l=0.5u
X147 r5.t2 r4.t5 a_18866_0.t2 vss.t111 nfet_03v3 ad=0.39p pd=2.02u as=0.915p ps=4.22u w=1.5u l=0.28u
X148 vbl.t1 vbl.t0 vss.t17 vss.t16 nfet_03v3 ad=1.22p pd=5.22u as=1.22p ps=5.22u w=2u l=2u
X149 vco_out.t5 nb.t7 vss.t132 vss.t131 nfet_03v3 ad=0.78p pd=3.52u as=1.83p ps=7.22u w=3u l=0.28u
X150 vbp_vco.t4 pll_en.t6 vdd.t82 vdd.t81 pfet_03v3 ad=0.65p pd=3.3u as=0.65p ps=3.3u w=1u l=0.28u
X151 dn_b.t1 pfd_dn.t0 vdd.t21 vdd.t20 pfet_03v3 ad=1.3p pd=5.3u as=1.3p ps=5.3u w=2u l=0.28u
X152 a_12000_19930# a_12600_12478# vss.t8 ppolyf_u r_width=1u r_length=36.6u
X153 vdump.t3 vdump.t2 vbt.t1 vdd.t2 pfet_03v3 ad=3.25p pd=11.3u as=3.25p ps=11.3u w=5u l=1u
X154 a_19968_0.t0 r5.t4 nb.t0 vss.t10 nfet_03v3 ad=1.22p pd=5.22u as=0.52p ps=2.52u w=2u l=0.28u
X155 vss.t96 pll_en.t0 a_19968_0.t3 vss.t95 nfet_03v3 ad=1.22p pd=5.22u as=0.52p ps=2.52u w=2u l=0.28u
X156 nb.t3 pll_en.t3 vdd.t80 vdd.t79 pfet_03v3 ad=0.52p pd=2.52u as=1.3p ps=5.3u w=2u l=0.28u
X157 en_b.t0 pll_en.t10 vss.t92 vss.t91 nfet_03v3 ad=0.61p pd=3.22u as=0.61p ps=3.22u w=1u l=0.28u
X158 a_16450_1524.t1 r1.t6 r2.t1 vdd.t41 pfet_03v3 ad=1.95p pd=7.3u as=0.78p ps=3.52u w=3u l=0.28u
X159 dn_s.t2 vcp_n.t14 vss.t56 vss.t55 nfet_03v3 ad=6.1p pd=21.22u as=6.1p ps=21.22u w=10u l=2u
X160 vdump.t12 vbh.t7 vdd.t6 vdd.t5 pfet_03v3 ad=2.6p pd=9.3u as=2.6p ps=9.3u w=4u l=2u
X161 r1.t3 r5.t11 a_18058_1524.t0 vdd.t43 pfet_03v3 ad=0.78p pd=3.52u as=1.95p ps=7.3u w=3u l=0.28u
X162 vcl.t3 vref.t11 vss.t70 vss.t69 nfet_03v3 ad=6.1p pd=21.22u as=6.1p ps=21.22u w=10u l=2u
X163 a_7800_18610# a_8400_12478# vss.t129 ppolyf_u r_width=1u r_length=30u
X164 dn_s.t0 vcp_n.t13 vss.t15 vss.t14 nfet_03v3 ad=6.1p pd=21.22u as=6.1p ps=21.22u w=10u l=2u
X165 vbp_vco.t1 vbp_vco.t0 vdd.t4 vdd.t3 pfet_03v3 ad=3.25p pd=11.3u as=3.25p ps=11.3u w=5u l=0.5u
X166 vcp_p.t0 pll_en.t9 vdd.t74 vdd.t73 pfet_03v3 ad=0.65p pd=3.3u as=0.65p ps=3.3u w=1u l=0.28u
X167 vbp_vco.t3 vbp_vco.t2 vdd.t100 vdd.t99 pfet_03v3 ad=3.25p pd=11.3u as=3.25p ps=11.3u w=5u l=0.5u
R0 vco_out vco_out.n1 8.6225
R1 vco_out.n1 vco_out.n4 5.7305
R2 vco_out.n4 vco_out.n3 6.77734
R3 vco_out.n3 vco_out.t5 0.5465
R4 vco_out.n3 vco_out.t1 0.5465
R5 vco_out.n4 vco_out.n2 6.61734
R6 vco_out.n2 vco_out.t3 0.607167
R7 vco_out.n2 vco_out.t4 0.607167
R8 vco_out.n1 vco_out.n0 11.1173
R9 vco_out.n0 vco_out.t0 0.607167
R10 vco_out.n0 vco_out.t2 0.607167
R11 bias_ref bias_ref.n0 56.2752
R12 bias_ref.n0 bias_ref.t1 21.0588
R13 bias_ref.n0 bias_ref.t0 23.8937
R14 pll_en pll_en.n0 10.1405
R15 pll_en.n0 pll_en.n9 6.1085
R16 pll_en.n9 pll_en.n8 5.37555
R17 pll_en.n8 pll_en.t0 45.5434
R18 pll_en.n8 pll_en.t1 45.7328
R19 pll_en.n9 pll_en.n7 6.03729
R20 pll_en.n7 pll_en.t2 45.5434
R21 pll_en.n7 pll_en.t3 45.7328
R22 pll_en.n4 pll_en.n3 4.5005
R23 pll_en.n0 pll_en.n6 11.8085
R24 pll_en.n6 pll_en.n4 4.1675
R25 pll_en.n6 pll_en.n5 5.1665
R26 pll_en.n5 pll_en.t4 96.3364
R27 pll_en.n5 pll_en.t5 95.7289
R28 pll_en.n2 pll_en.n1 1.121
R29 pll_en.n3 pll_en.n2 8.411
R30 pll_en.n3 pll_en.t6 44.7698
R31 pll_en.n2 pll_en.t7 57.513
R32 pll_en.n1 pll_en.t8 44.7023
R33 pll_en.n1 pll_en.t9 45.3278
R34 pll_en.n4 pll_en.t10 79.1968
R35 pfd_up.n1 pfd_up.n0 5.5535
R36 pfd_up pfd_up.n1 6.953
R37 pfd_up.n1 pfd_up.t2 87.3193
R38 pfd_up.n0 pfd_up.t0 55.1802
R39 pfd_up.n0 pfd_up.t1 64.4475
R40 vctrl vctrl.n10 18.4033
R41 vctrl.n10 vctrl.n6 3.9875
R42 vctrl.n6 vctrl.n0 11.903
R43 vctrl.n8 vctrl.n7 20.075
R44 vctrl.n9 vctrl.n8 0.77
R45 vctrl.n10 vctrl.n9 4.622
R46 vctrl.n9 vctrl.t4 40.0182
R47 vctrl.n8 vctrl.t5 40.0182
R48 vctrl.n7 vctrl.t6 40.0182
R49 vctrl.n7 vctrl.t7 42.3267
R50 vctrl.n2 vctrl.n1 1.283
R51 vctrl.n3 vctrl.n2 2.363
R52 vctrl.n5 vctrl.n3 1.4135
R53 vctrl.n4 vctrl.n5 11.0637
R54 vctrl.n6 vctrl.n4 9.27725
R55 vctrl.n5 vctrl.t3 9.23931
R56 vctrl.n4 vctrl.t1 12.186
R57 vctrl.n3 vctrl.t8 40.1274
R58 vctrl.n2 vctrl.t9 40.1274
R59 vctrl.n1 vctrl.t10 40.1274
R60 vctrl.n1 vctrl.t11 42.4899
R61 vctrl.n0 vctrl.t2 41.6334
R62 vctrl.n0 vctrl.t0 41.9313
R63 cp_trim1 cp_trim1.n0 21.9155
R64 cp_trim1.n0 cp_trim1.t0 58.7818
R65 cp_trim1.n0 cp_trim1.t1 59.9968
R66 cp_trim0 cp_trim0.n0 22.523
R67 cp_trim0.n0 cp_trim0.t0 58.4218
R68 cp_trim0.n0 cp_trim0.t1 59.6368
R69 pfd_dn pfd_dn.n0 7.133
R70 pfd_dn.n0 pfd_dn.n1 38.2212
R71 pfd_dn.n1 pfd_dn.t1 45.071
R72 pfd_dn.n1 pfd_dn.t2 47.265
R73 pfd_dn.n0 pfd_dn.t0 69.555
R74 vdd vdd.n83 21.8503
R75 vdd.n30 vdd.n29 3.6455
R76 vdd.n31 vdd.n30 0.43475
R77 vdd.n32 vdd.n31 1.013
R78 vdd.n33 vdd.n32 1.013
R79 vdd.n34 vdd.n33 1.07375
R80 vdd.n35 vdd.n34 0.43475
R81 vdd.n36 vdd.n35 1.013
R82 vdd.n37 vdd.n36 0.626
R83 vdd.n38 vdd.n37 0.626
R84 vdd.n39 vdd.n38 0.626
R85 vdd.n40 vdd.n39 0.68675
R86 vdd.n41 vdd.n40 0.43475
R87 vdd.n42 vdd.n41 0.626
R88 vdd.n57 vdd.n42 1.18625
R89 vdd.n43 vdd.n57 1.688
R90 vdd.n44 vdd.n43 1.78475
R91 vdd.n45 vdd.n44 0.6755
R92 vdd.n46 vdd.n45 0.6755
R93 vdd.n47 vdd.n46 0.73625
R94 vdd.n48 vdd.n47 0.43475
R95 vdd.n49 vdd.n48 0.6755
R96 vdd.n56 vdd.n49 0.68675
R97 vdd.n83 vdd.n56 7.7675
R98 vdd.n57 vdd.n82 24.2533
R99 vdd.n82 vdd.n65 0.3095
R100 vdd.n65 vdd.n66 0.3545
R101 vdd.n66 vdd.n67 0.2495
R102 vdd.n67 vdd.n58 0.254
R103 vdd.n58 vdd.n68 0.101
R104 vdd.n68 vdd.n69 0.2495
R105 vdd.n69 vdd.n70 0.3545
R106 vdd.n70 vdd.n71 0.2495
R107 vdd.n71 vdd.n60 0.248
R108 vdd.n60 vdd.n72 0.107
R109 vdd.n72 vdd.n73 0.2495
R110 vdd.n73 vdd.n74 0.3545
R111 vdd.n74 vdd.n75 0.3395
R112 vdd.n75 vdd.n62 0.152
R113 vdd.n62 vdd.n76 0.137
R114 vdd.n76 vdd.n77 0.3395
R115 vdd.n77 vdd.n78 0.2885
R116 vdd.n78 vdd.n79 0.3395
R117 vdd.n79 vdd.n64 0.098
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
R471 vss.t91 vss.t8 97.3883
R472 vss.t8 vss.t122 31.4977
R473 vss.t122 vss.t54 77.1142
R474 vss.t54 vss.n45 42.7208
R475 vss.n45 vss.t45 65.8911
R476 vss.t45 vss.t59 53.9439
R477 vss.t59 vss.t41 54.668
R478 vss.t41 vss.t57 105.353
R479 vss.t23 vss.t57 3.25883
R480 vss.n87 vss.t20 9.27483
R481 vss.t20 vss.t69 48.1513
R482 vss.t69 vss.n46 119.835
R483 vss.n46 vss.n89 2677.22
R484 vss.n67 vss.n68 0.947868
R485 vss.n68 vss.n69 0.947868
R486 vss.n69 vss.n70 0.947868
R487 vss.n70 vss.n71 1.53997
R488 vss.n71 vss.n72 0.711026
R489 vss.n72 vss.n73 1.42155
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
