Hive-RSI-Lab/ece298a-pll/blocks/pll/analog/layout_ref/pll_analog_pex_tb.cir

* pll_analog_pex_tb.cir - the post-layout bench for pll_analog, at the corner
* pex_sim gives it through {{corner}}, {{res_corner}}, {{mim_corner}}, {{temp_c}}
* and {{vdd}}; whatever follows the supply follows {{vdd}}. It runs on the
* magic-extracted, parasitic-annotated netlist of this run's own GDS;
* check_pex_sim.py fills in the tokens through str.format(), so any other
* curly brace in this file is doubled.
* Written from spec/ only (post_layout_bounds), before any layout exists.
*
* Measures (spec.yaml post_layout_bounds, same bounds as pre-layout):
*  - icp_up_code00_ua, icp_dn_code00_ua: the pump's UP source / DN sink
*    current, code 00, vctrl forced at vdd/2 (spec.md's definition, the
*    same operating point as tb/pll_analog_cp_tb.cir). The layout moves
*    these through wire resistance in the mirror sources, the steering
*    switches and the vdd/vss rails (degeneration, IR drop on the Vgs/R
*    bias). i(vvc) is the current the pump pushes INTO vctrl: UP = +i,
*    DN = -i.
*  - vco_kvco_mhz_per_v: the mean df/dv over the tuning range,
*    (f(vdd-0.3) - f(0.3)) / (vdd-0.6), spec.md's definition. This is the
*    measure parasitics move most: every fF of wire on the ring nodes
*    r1..r5, the NAND input and the starve rails slows the ring, mostly at
*    the fast end, so the extracted Kvco falls below the schematic's.
*
* Conditions: pll_en = 1, cp_trim = 00, bias_ref floating (internal
* default), vco_out into 15 fF, pump inputs low for the VCO runs.
*
* START-UP KICK, through a pin only: the pre-layout benches kick ring node
* r1 directly, but that is a net internal to the cell, and the extracted
* netlist keeps it only if the layout labels it - a kick into an unlabelled
* node would silently hit a dangling node and the ring could sit on its DC
* balance point. Here ikick, 200 uA for 1 ns on r1 at t = 1 ns (zero at the
* operating point, so the op and the pump currents are untouched), is a
* large-signal start. Until 2026-11-01 this was a 0.3 V pulse on vctrl, which
* left the ring on that point at ff_pss. A ring whose DC point is stable
* still decays and stalls.
*
* Both frequency runs start from the operating point at vctrl = 3.0 V,
* where the ring's small-signal gain is high and the kick grows to full
* swing within ~10 ns. At vctrl = 0.3 V it would take ~300 ns (pre-layout),
* and a large fast vctrl step instead couples through the V2I node into the
* bias (vref), which then takes ~1 us to recover and moves the period by
* up to 15 %. So the slow-end run ramps vctrl from 3.0 V to 0.3 V slowly
* (vramp, in series, 100 ns ramp from 20 ns; it is zero at the op and in
* the fast run) with the ring already running at full swing.
*
* Frequency: f = (n-1) / (t(rise n) - t(rise 1)) over the rising vdd/2
* crossings of vco_out after the settle time, n capped. Fewer than 2 rises:
* f = 0, a stalled ring, printed as a real value so Kvco fails its bound,
* never skipped.
*   fast end (vctrl = vdd-0.3 V): 20 ps max step, 250 ns, rises after 100 ns,
*     up to 30 periods, once the bias has settled (pex_pvt_tb's reasoning).
*   slow end (vctrl = 0.3 V): 250 ps max step, 1 us, rises after 200 ns,
*     up to 4 periods.
* vco_fmax_tt_mhz is f at vctrl = vdd - 0.3 V (= vco_f_hi_mhz), the
* pre-layout measure of the same name, bounded post-layout too: wire
* capacitance on the ring slows the top of the range, and the 200 MHz lock
* point lives there. vco_f_lo_mhz is printed for the layout-fixer, unbounded.
.include '{pdk}/libs.tech/ngspice/design.spice'
.lib '{pdk}/libs.tech/ngspice/sm141064.spice' {corner}
.lib '{pdk}/libs.tech/ngspice/sm141064.spice' {res_corner}
.lib '{pdk}/libs.tech/ngspice/sm141064.spice' {mim_corner}
* the loop filter's MOS caps: the PDK's cap_nmos_03v3_b (sm141064.spice, .lib
* moscap), written in charge form. The PDK's C(v) = A*(cvar1 + cvar2*tanh(cvar3*v
* + cvar4)) as a voltage-dependent C makes the transient step collapse ("timestep
* too small" on its current probe) at most corners on the extracted netlist;
* Q(v), its integral, is the same device and holds (pex tt_27c: Icp 18.52 vs
* 18.52 uA, Kvco 72.67 vs 72.66 MHz/V, fmax 203.31 vs 203.29 MHz against the
* PDK form under Gear). Its corner factor follows the MIM corner's
* (mim_corner_2p0ff: 1 / 1.1 ss / 0.9 ff, as moscap_<corner> sets it).
.param cap_nmos_03v3_b_corner=mim_corner_2p0ff
.subckt cap_nmos_03v3_b 1 2 c_length=1e-6 c_width=1e-6 dtemp=0
.param cvar1=0.002458 cvar2=0.001533 cvar3=1.515152 cvar4=0.560606
* ln(cosh(x)) written |x| + ln(1+exp(-2|x|)) - ln 2, the same function: cosh
* overflowed on a wild Newton iterate in the op search ('Error: -10030.2 out
* of range for cosh', which the engine reads as an ngspice error; ff_27c_vm10).
C1 1 2 q='cap_nmos_03v3_b_corner*c_length*c_width*(cvar1*v(1,2)+cvar2/cvar3*(abs(cvar3*v(1,2)+cvar4)+ln(1+exp(-2*abs(cvar3*v(1,2)+cvar4)))-ln(2)))'
.ends cap_nmos_03v3_b
.include '{extracted}'

.temp {temp_c}
.param vddp={vdd}
.csparam vddp={{vddp}}
.csparam vmid={{vddp/2}}
.csparam vhi={{vddp-0.3}}
.csparam vrng={{vddp-0.6}}
.csparam vdrop={{0.6-vddp}}
vdd_src  vdd      0 dc {{vddp}}
vss_src  vss      0 dc 0
ven      pll_en   0 dc {{vddp}}
vup      pfd_up   0 dc 0
vdn      pfd_dn   0 dc 0
vt0      cp_trim0 0 dc 0
vt1      cp_trim1 0 dc 0
vvc      vctrl    vk dc {{vddp/2}}
vkick    vk       vr dc 0
vramp    vr       0 dc 0 pulse(0 0 20n 100n 100n 1 1)
cload2   vco_div2 0 30f
xdut vco_div2 pfd_up pfd_dn pll_en cp_trim0 cp_trim1 vctrl bias_ref vdd vss pll_analog
* 2026-11-01: as pex_pvt_tb, the 200 uA, 1 ns kick on r1 and its settle times; at
* ff_pss the 0.3 V pin kick left the ring on its DC balance point (f = 0)
ikick    0        xdut.r1 pulse(0 200u 1n 50p 50p 1n 1)

.control
set noaskquit
* --- pump currents, code 00, vctrl = vdd/2
alter vup dc = $&vddp
op
let x = i(vvc)*1e6
set iup = "$&x"
alter vup dc = 0
alter vdn dc = $&vddp
op
let x = -i(vvc)*1e6
set idn = "$&x"
alter vdn dc = 0
* --- VCO frequency at the two ends of the tuning range
setplot new
set rp = $curplot
let fhi = 0
let flo = 0
alter vvc dc = $&vhi
foreach pt 0 1
  if $pt eq 0
    set tsx = "20p"
    set tex = "250n"
    set tdx = "100n"
    set nmx = "31"
  else
    alter @vramp[pulse] = [ 0 $&vdrop 20n 100n 100n 1 1 ]
    set tsx = "250p"
    set tex = "1000n"
    set tdx = "200n"
    set nmx = "5"
  end
  tran $tsx $tex 0 $tsx
  set tp = $curplot
  let nx = length(time)
  let nx1 = nx - 1
  let nx2 = nx - 2
  let hv = (v(xdut.vco_out) gt $&vmid)
  let late = time[0,$&nx2] gt $tdx
  let nrise = mean(((hv[1,$&nx1] - hv[0,$&nx2]) gt 0.5) and late)*length(late)
  let fk = 0
  let nmax = $nmx
  if nrise ge 2
    let nr = nrise
    if nr gt nmax
      let nr = nmax
    end
    meas tran tra when v(xdut.vco_out)=$&vmid rise=1 td=$tdx
    meas tran trb when v(xdut.vco_out)=$&vmid rise=$&nr td=$tdx
    let fk = (nr - 1)/(trb - tra)
  end
  set fks = "$&fk"
  setplot $rp
  if $pt eq 0
    let fhi = $fks
  else
    let flo = $fks
  end
  destroy $tp
end
let kv = (fhi - flo)/$&vrng/1e6
* a stalled end is not a Kvco: print 0, which fails the bound
if (fhi eq 0) or (flo eq 0)
  let kv = 0
end
let fhm = fhi/1e6
let flm = flo/1e6
set kvs = "$&kv"
set fhs = "$&fhm"
set fls = "$&flm"
echo
echo "  Measurements (pll_analog_pex_tb, computed in .control)"
echo "icp_up_code00_ua = $iup"
echo "icp_dn_code00_ua = $idn"
echo "vco_kvco_mhz_per_v = $kvs"
echo "vco_f_hi_mhz = $fhs"
echo "vco_fmax_tt_mhz = $fhs"
echo "vco_f_lo_mhz = $fls"
echo
.endc
.end
