Hive-RSI-Lab/ece298a-pll/blocks/pll/log/top_lvs/tt_um_ihsan_sa_pll.extracted.spice

* NGSPICE file created from tt_um_ihsan_sa_pll.ext - technology: gf180mcuD

.subckt gf180mcu_fd_sc_mcu7t5v0__fillcap_32 VDD VNW VPW VSS
X0 VDD a_572_375# a_484_472# VNW pfet_05v0 ad=0.5368p pd=3.32u as=0.5368p ps=3.32u w=1.22u l=1u
X1 VDD a_2364_375# a_2276_472# VNW pfet_05v0 ad=0.5368p pd=3.32u as=0.5368p ps=3.32u w=1.22u l=1u
X2 a_572_375# a_484_472# VSS VPW nfet_05v0 ad=0.3608p pd=2.52u as=0.3608p ps=2.52u w=0.82u l=1u
X3 VDD a_1916_375# a_1828_472# VNW pfet_05v0 ad=0.5368p pd=3.32u as=0.5368p ps=3.32u w=1.22u l=1u
X4 a_124_375# a_36_472# VSS VPW nfet_05v0 ad=0.3608p pd=2.52u as=0.3608p ps=2.52u w=0.82u l=1u
X5 a_1916_375# a_1828_472# VSS VPW nfet_05v0 ad=0.3608p pd=2.52u as=0.3608p ps=2.52u w=0.82u l=1u
X6 a_1468_375# a_1380_472# VSS VPW nfet_05v0 ad=0.3608p pd=2.52u as=0.3608p ps=2.52u w=0.82u l=1u
X7 a_2812_375# a_2724_472# VSS VPW nfet_05v0 ad=0.3608p pd=2.52u as=0.3608p ps=2.52u w=0.82u l=1u
X8 VDD a_3260_375# a_3172_472# VNW pfet_05v0 ad=0.5368p pd=3.32u as=0.5368p ps=3.32u w=1.22u l=1u
X9 a_2364_375# a_2276_472# VSS VPW nfet_05v0 ad=0.3608p pd=2.52u as=0.3608p ps=2.52u w=0.82u l=1u
X10 VDD a_2812_375# a_2724_472# VNW pfet_05v0 ad=0.5368p pd=3.32u as=0.5368p ps=3.32u w=1.22u l=1u
X11 a_3260_375# a_3172_472# VSS VPW nfet_05v0 ad=0.3608p pd=2.52u as=0.3608p ps=2.52u w=0.82u l=1u
X12 VDD a_1020_375# a_932_472# VNW pfet_05v0 ad=0.5368p pd=3.32u as=0.5368p ps=3.32u w=1.22u l=1u
X13 VDD a_1468_375# a_1380_472# VNW pfet_05v0 ad=0.5368p pd=3.32u as=0.5368p ps=3.32u w=1.22u l=1u
X14 VDD a_124_375# a_36_472# VNW pfet_05v0 ad=0.5368p pd=3.32u as=0.5368p ps=3.32u w=1.22u l=1u
X15 a_1020_375# a_932_472# VSS VPW nfet_05v0 ad=0.3608p pd=2.52u as=0.3608p ps=2.52u w=0.82u l=1u
.ends

.subckt gf180mcu_fd_sc_mcu7t5v0__fillcap_64 VDD VNW VPW VSS
X0 a_4604_375# a_4516_472# VSS VPW nfet_05v0 ad=0.3608p pd=2.52u as=0.3608p ps=2.52u w=0.82u l=1u
X1 VDD a_572_375# a_484_472# VNW pfet_05v0 ad=0.5368p pd=3.32u as=0.5368p ps=3.32u w=1.22u l=1u
X2 VDD a_2364_375# a_2276_472# VNW pfet_05v0 ad=0.5368p pd=3.32u as=0.5368p ps=3.32u w=1.22u l=1u
X3 a_4156_375# a_4068_472# VSS VPW nfet_05v0 ad=0.3608p pd=2.52u as=0.3608p ps=2.52u w=0.82u l=1u
X4 a_5500_375# a_5412_472# VSS VPW nfet_05v0 ad=0.3608p pd=2.52u as=0.3608p ps=2.52u w=0.82u l=1u
X5 a_572_375# a_484_472# VSS VPW nfet_05v0 ad=0.3608p pd=2.52u as=0.3608p ps=2.52u w=0.82u l=1u
X6 VDD a_5052_375# a_4964_472# VNW pfet_05v0 ad=0.5368p pd=3.32u as=0.5368p ps=3.32u w=1.22u l=1u
X7 VDD a_6844_375# a_6756_472# VNW pfet_05v0 ad=0.5368p pd=3.32u as=0.5368p ps=3.32u w=1.22u l=1u
X8 VDD a_1916_375# a_1828_472# VNW pfet_05v0 ad=0.5368p pd=3.32u as=0.5368p ps=3.32u w=1.22u l=1u
X9 a_124_375# a_36_472# VSS VPW nfet_05v0 ad=0.3608p pd=2.52u as=0.3608p ps=2.52u w=0.82u l=1u
X10 a_5052_375# a_4964_472# VSS VPW nfet_05v0 ad=0.3608p pd=2.52u as=0.3608p ps=2.52u w=0.82u l=1u
X11 a_1916_375# a_1828_472# VSS VPW nfet_05v0 ad=0.3608p pd=2.52u as=0.3608p ps=2.52u w=0.82u l=1u
X12 VDD a_4604_375# a_4516_472# VNW pfet_05v0 ad=0.5368p pd=3.32u as=0.5368p ps=3.32u w=1.22u l=1u
X13 a_1468_375# a_1380_472# VSS VPW nfet_05v0 ad=0.3608p pd=2.52u as=0.3608p ps=2.52u w=0.82u l=1u
X14 a_2812_375# a_2724_472# VSS VPW nfet_05v0 ad=0.3608p pd=2.52u as=0.3608p ps=2.52u w=0.82u l=1u
X15 VDD a_3260_375# a_3172_472# VNW pfet_05v0 ad=0.5368p pd=3.32u as=0.5368p ps=3.32u w=1.22u l=1u
X16 a_2364_375# a_2276_472# VSS VPW nfet_05v0 ad=0.3608p pd=2.52u as=0.3608p ps=2.52u w=0.82u l=1u
X17 a_5948_375# a_5860_472# VSS VPW nfet_05v0 ad=0.3608p pd=2.52u as=0.3608p ps=2.52u w=0.82u l=1u
X18 VDD a_2812_375# a_2724_472# VNW pfet_05v0 ad=0.5368p pd=3.32u as=0.5368p ps=3.32u w=1.22u l=1u
X19 a_3260_375# a_3172_472# VSS VPW nfet_05v0 ad=0.3608p pd=2.52u as=0.3608p ps=2.52u w=0.82u l=1u
X20 VDD a_1020_375# a_932_472# VNW pfet_05v0 ad=0.5368p pd=3.32u as=0.5368p ps=3.32u w=1.22u l=1u
X21 VDD a_5500_375# a_5412_472# VNW pfet_05v0 ad=0.5368p pd=3.32u as=0.5368p ps=3.32u w=1.22u l=1u
X22 a_6844_375# a_6756_472# VSS VPW nfet_05v0 ad=0.3608p pd=2.52u as=0.3608p ps=2.52u w=0.82u l=1u
X23 a_6396_375# a_6308_472# VSS VPW nfet_05v0 ad=0.3608p pd=2.52u as=0.3608p ps=2.52u w=0.82u l=1u
X24 VDD a_6396_375# a_6308_472# VNW pfet_05v0 ad=0.5368p pd=3.32u as=0.5368p ps=3.32u w=1.22u l=1u
X25 VDD a_1468_375# a_1380_472# VNW pfet_05v0 ad=0.5368p pd=3.32u as=0.5368p ps=3.32u w=1.22u l=1u
X26 VDD a_4156_375# a_4068_472# VNW pfet_05v0 ad=0.5368p pd=3.32u as=0.5368p ps=3.32u w=1.22u l=1u
X27 VDD a_5948_375# a_5860_472# VNW pfet_05v0 ad=0.5368p pd=3.32u as=0.5368p ps=3.32u w=1.22u l=1u
X28 VDD a_124_375# a_36_472# VNW pfet_05v0 ad=0.5368p pd=3.32u as=0.5368p ps=3.32u w=1.22u l=1u
X29 a_3708_375# a_3620_472# VSS VPW nfet_05v0 ad=0.3608p pd=2.52u as=0.3608p ps=2.52u w=0.82u l=1u
X30 VDD a_3708_375# a_3620_472# VNW pfet_05v0 ad=0.5368p pd=3.32u as=0.5368p ps=3.32u w=1.22u l=1u
X31 a_1020_375# a_932_472# VSS VPW nfet_05v0 ad=0.3608p pd=2.52u as=0.3608p ps=2.52u w=0.82u l=1u
.ends

.subckt gf180mcu_fd_sc_mcu7t5v0__fillcap_4 VDD VNW VPW VSS
X0 a_124_375# a_36_472# VSS VPW nfet_05v0 ad=0.3608p pd=2.52u as=0.3608p ps=2.52u w=0.82u l=1u
X1 VDD a_124_375# a_36_472# VNW pfet_05v0 ad=0.5368p pd=3.32u as=0.5368p ps=3.32u w=1.22u l=1u
.ends

.subckt gf180mcu_fd_sc_mcu7t5v0__fillcap_8 VDD VNW VPW VSS
X0 VDD a_572_375# a_484_472# VNW pfet_05v0 ad=0.5368p pd=3.32u as=0.5368p ps=3.32u w=1.22u l=1u
X1 a_572_375# a_484_472# VSS VPW nfet_05v0 ad=0.3608p pd=2.52u as=0.3608p ps=2.52u w=0.82u l=1u
X2 a_124_375# a_36_472# VSS VPW nfet_05v0 ad=0.3608p pd=2.52u as=0.3608p ps=2.52u w=0.82u l=1u
X3 VDD a_124_375# a_36_472# VNW pfet_05v0 ad=0.5368p pd=3.32u as=0.5368p ps=3.32u w=1.22u l=1u
.ends

.subckt gf180mcu_fd_sc_mcu7t5v0__clkbuf_8 I Z VDD VNW VPW VSS
X0 Z a_224_552# VSS VPW nfet_05v0 ad=0.1118p pd=0.95u as=0.1892p ps=1.74u w=0.43u l=0.6u
X1 VSS a_224_552# Z VPW nfet_05v0 ad=0.1118p pd=0.95u as=0.1118p ps=0.95u w=0.43u l=0.6u
X2 VDD a_224_552# Z VNW pfet_05v0 ad=0.3172p pd=1.74u as=0.4392p ps=1.94u w=1.22u l=0.5u
X3 a_224_552# I VDD VNW pfet_05v0 ad=0.2952p pd=1.54u as=0.3608p ps=2.52u w=0.82u l=0.5u
X4 VDD I a_224_552# VNW pfet_05v0 ad=0.2132p pd=1.34u as=0.2952p ps=1.54u w=0.82u l=0.5u
X5 Z a_224_552# VDD VNW pfet_05v0 ad=0.4392p pd=1.94u as=0.3172p ps=1.74u w=1.22u l=0.5u
X6 VDD a_224_552# Z VNW pfet_05v0 ad=0.3172p pd=1.74u as=0.4392p ps=1.94u w=1.22u l=0.5u
X7 VSS I a_224_552# VPW nfet_05v0 ad=0.1053p pd=0.925u as=0.1053p ps=0.925u w=0.405u l=0.6u
X8 a_224_552# I VDD VNW pfet_05v0 ad=0.2952p pd=1.54u as=0.2132p ps=1.34u w=0.82u l=0.5u
X9 VDD a_224_552# Z VNW pfet_05v0 ad=0.3172p pd=1.74u as=0.4392p ps=1.94u w=1.22u l=0.5u
X10 VSS a_224_552# Z VPW nfet_05v0 ad=0.1892p pd=1.74u as=0.1118p ps=0.95u w=0.43u l=0.6u
X11 Z a_224_552# VDD VNW pfet_05v0 ad=0.4392p pd=1.94u as=0.3172p ps=1.74u w=1.22u l=0.5u
X12 Z a_224_552# VSS VPW nfet_05v0 ad=0.1118p pd=0.95u as=0.1118p ps=0.95u w=0.43u l=0.6u
X13 VSS a_224_552# Z VPW nfet_05v0 ad=0.1118p pd=0.95u as=0.1118p ps=0.95u w=0.43u l=0.6u
X14 Z a_224_552# VSS VPW nfet_05v0 ad=0.1118p pd=0.95u as=0.1118p ps=0.95u w=0.43u l=0.6u
X15 Z a_224_552# VDD VNW pfet_05v0 ad=0.4392p pd=1.94u as=0.3172p ps=1.74u w=1.22u l=0.5u
X16 VDD I a_224_552# VNW pfet_05v0 ad=0.367p pd=1.92u as=0.2952p ps=1.54u w=0.82u l=0.5u
X17 VDD a_224_552# Z VNW pfet_05v0 ad=0.5368p pd=3.32u as=0.4392p ps=1.94u w=1.22u l=0.5u
X18 a_224_552# I VSS VPW nfet_05v0 ad=0.1053p pd=0.925u as=0.1782p ps=1.69u w=0.405u l=0.6u
X19 Z a_224_552# VSS VPW nfet_05v0 ad=0.1118p pd=0.95u as=0.1118p ps=0.95u w=0.43u l=0.6u
X20 Z a_224_552# VDD VNW pfet_05v0 ad=0.4392p pd=1.94u as=0.367p ps=1.92u w=1.22u l=0.5u
X21 a_224_552# I VSS VPW nfet_05v0 ad=0.1782p pd=1.69u as=0.1053p ps=0.925u w=0.405u l=0.6u
X22 VSS a_224_552# Z VPW nfet_05v0 ad=0.1118p pd=0.95u as=0.1118p ps=0.95u w=0.43u l=0.6u
.ends

.subckt gf180mcu_fd_sc_mcu7t5v0__and2_1 A1 A2 Z VDD VNW VPW VSS
X0 VDD A2 a_36_159# VNW pfet_05v0 ad=0.40575p pd=2.055u as=0.156p ps=1.12u w=0.6u l=0.5u
X1 Z a_36_159# VDD VNW pfet_05v0 ad=0.5346p pd=3.31u as=0.40575p ps=2.055u w=1.215u l=0.5u
X2 Z a_36_159# VSS VPW nfet_05v0 ad=0.3586p pd=2.51u as=0.23405p ps=1.555u w=0.815u l=0.6u
X3 VSS A2 a_244_159# VPW nfet_05v0 ad=0.23405p pd=1.555u as=58.39999f ps=0.685u w=0.365u l=0.6u
X4 a_244_159# A1 a_36_159# VPW nfet_05v0 ad=58.39999f pd=0.685u as=0.1606p ps=1.61u w=0.365u l=0.6u
X5 a_36_159# A1 VDD VNW pfet_05v0 ad=0.156p pd=1.12u as=0.264p ps=2.08u w=0.6u l=0.5u
.ends

.subckt gf180mcu_fd_sc_mcu7t5v0__fillcap_16 VDD VNW VPW VSS
X0 VDD a_572_375# a_484_472# VNW pfet_05v0 ad=0.5368p pd=3.32u as=0.5368p ps=3.32u w=1.22u l=1u
X1 a_572_375# a_484_472# VSS VPW nfet_05v0 ad=0.3608p pd=2.52u as=0.3608p ps=2.52u w=0.82u l=1u
X2 a_124_375# a_36_472# VSS VPW nfet_05v0 ad=0.3608p pd=2.52u as=0.3608p ps=2.52u w=0.82u l=1u
X3 a_1468_375# a_1380_472# VSS VPW nfet_05v0 ad=0.3608p pd=2.52u as=0.3608p ps=2.52u w=0.82u l=1u
X4 VDD a_1020_375# a_932_472# VNW pfet_05v0 ad=0.5368p pd=3.32u as=0.5368p ps=3.32u w=1.22u l=1u
X5 VDD a_1468_375# a_1380_472# VNW pfet_05v0 ad=0.5368p pd=3.32u as=0.5368p ps=3.32u w=1.22u l=1u
X6 VDD a_124_375# a_36_472# VNW pfet_05v0 ad=0.5368p pd=3.32u as=0.5368p ps=3.32u w=1.22u l=1u
X7 a_1020_375# a_932_472# VSS VPW nfet_05v0 ad=0.3608p pd=2.52u as=0.3608p ps=2.52u w=0.82u l=1u
.ends

.subckt gf180mcu_fd_sc_mcu7t5v0__tiel ZN VDD VNW VPW VSS
X0 ZN a_124_24# VSS VPW nfet_05v0 ad=0.3608p pd=2.52u as=0.3608p ps=2.52u w=0.82u l=0.6u
X1 a_124_24# a_124_24# VDD VNW pfet_05v0 ad=0.5368p pd=3.32u as=0.5368p ps=3.32u w=1.22u l=0.5u
.ends

.subckt gf180mcu_fd_sc_mcu7t5v0__or2_1 A1 A2 Z VDD VNW VPW VSS
X0 a_255_603# A1 a_67_603# VNW pfet_05v0 ad=0.1469p pd=1.085u as=0.2486p ps=2.01u w=0.565u l=0.5u
X1 Z a_67_603# VSS VPW nfet_05v0 ad=0.3608p pd=2.52u as=0.2288p ps=1.58u w=0.82u l=0.6u
X2 VDD A2 a_255_603# VNW pfet_05v0 ad=0.38705p pd=2.08u as=0.1469p ps=1.085u w=0.565u l=0.5u
X3 VSS A2 a_67_603# VPW nfet_05v0 ad=0.2288p pd=1.58u as=93.59999f ps=0.88u w=0.36u l=0.6u
X4 Z a_67_603# VDD VNW pfet_05v0 ad=0.5368p pd=3.32u as=0.38705p ps=2.08u w=1.22u l=0.5u
X5 a_67_603# A1 VSS VPW nfet_05v0 ad=93.59999f pd=0.88u as=0.1584p ps=1.6u w=0.36u l=0.6u
.ends

.subckt gf180mcu_fd_sc_mcu7t5v0__clkinv_1 I ZN VDD VNW VPW VSS
X0 ZN I VSS VPW nfet_05v0 ad=0.2112p pd=1.84u as=0.2112p ps=1.84u w=0.48u l=0.6u
X1 ZN I VDD VNW pfet_05v0 ad=0.5368p pd=3.32u as=0.5368p ps=3.32u w=1.22u l=0.5u
.ends

.subckt gf180mcu_fd_sc_mcu7t5v0__nor2_1 A1 A2 ZN VDD VNW VPW VSS
X0 ZN A1 a_224_472# VNW pfet_05v0 ad=0.5368p pd=3.32u as=0.4087p ps=1.89u w=1.22u l=0.5u
X1 VSS A1 ZN VPW nfet_05v0 ad=0.2486p pd=2.01u as=0.1469p ps=1.085u w=0.565u l=0.6u
X2 a_224_472# A2 VDD VNW pfet_05v0 ad=0.4087p pd=1.89u as=0.5368p ps=3.32u w=1.22u l=0.5u
X3 ZN A2 VSS VPW nfet_05v0 ad=0.1469p pd=1.085u as=0.2486p ps=2.01u w=0.565u l=0.6u
.ends

.subckt gf180mcu_fd_sc_mcu7t5v0__and4_1 A1 A2 A3 A4 Z VDD VNW VPW VSS
X0 a_48_148# A1 VDD VNW pfet_05v0 ad=0.156p pd=1.12u as=0.264p ps=2.08u w=0.6u l=0.5u
X1 a_440_148# A2 a_256_148# VPW nfet_05v0 ad=88.2f pd=0.84u as=67.2f ps=0.74u w=0.42u l=0.6u
X2 Z a_48_148# VSS VPW nfet_05v0 ad=0.3586p pd=2.51u as=0.226p ps=1.515u w=0.815u l=0.6u
X3 VDD A2 a_48_148# VNW pfet_05v0 ad=0.156p pd=1.12u as=0.156p ps=1.12u w=0.6u l=0.5u
X4 Z a_48_148# VDD VNW pfet_05v0 ad=0.5368p pd=3.32u as=0.395p ps=2.02u w=1.22u l=0.5u
X5 a_644_148# A3 a_440_148# VPW nfet_05v0 ad=88.2f pd=0.84u as=88.2f ps=0.84u w=0.42u l=0.6u
X6 a_48_148# A3 VDD VNW pfet_05v0 ad=0.156p pd=1.12u as=0.156p ps=1.12u w=0.6u l=0.5u
X7 VSS A4 a_644_148# VPW nfet_05v0 ad=0.226p pd=1.515u as=88.2f ps=0.84u w=0.42u l=0.6u
X8 VDD A4 a_48_148# VNW pfet_05v0 ad=0.395p pd=2.02u as=0.156p ps=1.12u w=0.6u l=0.5u
X9 a_256_148# A1 a_48_148# VPW nfet_05v0 ad=67.2f pd=0.74u as=0.1848p ps=1.72u w=0.42u l=0.6u
.ends

.subckt gf180mcu_fd_sc_mcu7t5v0__clkbuf_2 I Z VDD VNW VPW VSS
X0 VDD I a_36_160# VNW pfet_05v0 ad=0.458p pd=2.02u as=0.4488p ps=2.92u w=1.02u l=0.5u
X1 VSS I a_36_160# VPW nfet_05v0 ad=0.151p pd=1.185u as=0.1584p ps=1.6u w=0.36u l=0.6u
X2 VDD a_36_160# Z VNW pfet_05v0 ad=0.5368p pd=3.32u as=0.3782p ps=1.84u w=1.22u l=0.5u
X3 Z a_36_160# VDD VNW pfet_05v0 ad=0.3782p pd=1.84u as=0.458p ps=2.02u w=1.22u l=0.5u
X4 VSS a_36_160# Z VPW nfet_05v0 ad=0.2134p pd=1.85u as=0.1261p ps=1.005u w=0.485u l=0.6u
X5 Z a_36_160# VSS VPW nfet_05v0 ad=0.1261p pd=1.005u as=0.151p ps=1.185u w=0.485u l=0.6u
.ends

.subckt gf180mcu_fd_sc_mcu7t5v0__dffrnq_1 D RN CLK Q VDD VNW VPW VSS
X0 VSS CLK a_36_151# VPW nfet_05v0 ad=0.1053p pd=0.925u as=0.1782p ps=1.69u w=0.405u l=0.6u
X1 VSS RN a_1456_156# VPW nfet_05v0 ad=0.2016p pd=1.48u as=43.2f ps=0.6u w=0.36u l=0.6u
X2 Q a_2665_112# VDD VNW pfet_05v0 ad=0.5346p pd=3.31u as=0.5346p ps=3.31u w=1.215u l=0.5u
X3 a_796_472# D VSS VPW nfet_05v0 ad=93.59999f pd=0.88u as=0.1584p ps=1.6u w=0.36u l=0.6u
X4 VSS a_2665_112# a_2560_156# VPW nfet_05v0 ad=0.1224p pd=1.04u as=94.5f ps=0.885u w=0.36u l=0.6u
X5 a_2665_112# a_2248_156# a_3041_156# VPW nfet_05v0 ad=0.176p pd=1.68u as=0.134p ps=1.1u w=0.4u l=0.6u
X6 a_1000_472# a_448_472# a_796_472# VNW pfet_05v0 ad=0.2028p pd=1.3u as=0.2028p ps=1.3u w=0.78u l=0.5u
X7 a_2248_156# a_36_151# a_1308_423# VNW pfet_05v0 ad=0.25375p pd=1.51u as=0.2424p ps=1.465u w=0.505u l=0.5u
X8 a_2248_156# a_448_472# a_1308_423# VPW nfet_05v0 ad=0.2007p pd=1.475u as=0.2007p ps=1.475u w=0.36u l=0.6u
X9 VDD CLK a_36_151# VNW pfet_05v0 ad=0.2249p pd=1.385u as=0.3806p ps=2.61u w=0.865u l=0.5u
X10 a_1456_156# a_1308_423# a_1288_156# VPW nfet_05v0 ad=43.2f pd=0.6u as=43.2f ps=0.6u w=0.36u l=0.6u
X11 a_1308_423# a_1000_472# VSS VPW nfet_05v0 ad=0.2007p pd=1.475u as=0.2016p ps=1.48u w=0.36u l=0.6u
X12 Q a_2665_112# VSS VPW nfet_05v0 ad=0.3586p pd=2.51u as=0.3586p ps=2.51u w=0.815u l=0.6u
X13 a_448_472# a_36_151# VDD VNW pfet_05v0 ad=0.3806p pd=2.61u as=0.2249p ps=1.385u w=0.865u l=0.5u
X14 a_1204_472# a_36_151# a_1000_472# VNW pfet_05v0 ad=0.2028p pd=1.3u as=0.2028p ps=1.3u w=0.78u l=0.5u
X15 a_1204_472# RN VDD VNW pfet_05v0 ad=0.3432p pd=2.44u as=0.45p ps=2.02u w=0.78u l=0.5u
X16 a_2665_112# RN VDD VNW pfet_05v0 ad=0.26p pd=1.52u as=0.29465p ps=1.74u w=1u l=0.5u
X17 a_2560_156# a_36_151# a_2248_156# VPW nfet_05v0 ad=94.5f pd=0.885u as=0.2007p ps=1.475u w=0.36u l=0.6u
X18 VDD a_2248_156# a_2665_112# VNW pfet_05v0 ad=0.44p pd=2.88u as=0.26p ps=1.52u w=1u l=0.5u
X19 a_1288_156# a_448_472# a_1000_472# VPW nfet_05v0 ad=43.2f pd=0.6u as=93.59999f ps=0.88u w=0.36u l=0.6u
X20 VDD a_1308_423# a_1204_472# VNW pfet_05v0 ad=0.45p pd=2.02u as=0.2028p ps=1.3u w=0.78u l=0.5u
X21 a_2560_156# a_448_472# a_2248_156# VNW pfet_05v0 ad=0.1313p pd=1.025u as=0.25375p ps=1.51u w=0.505u l=0.5u
X22 a_448_472# a_36_151# VSS VPW nfet_05v0 ad=0.1782p pd=1.69u as=0.1053p ps=0.925u w=0.405u l=0.6u
X23 a_3041_156# RN VSS VPW nfet_05v0 ad=0.134p pd=1.1u as=0.1224p ps=1.04u w=0.36u l=0.6u
X24 VDD a_2665_112# a_2560_156# VNW pfet_05v0 ad=0.29465p pd=1.74u as=0.1313p ps=1.025u w=0.505u l=0.5u
X25 a_1308_423# a_1000_472# VDD VNW pfet_05v0 ad=0.2424p pd=1.465u as=0.2222p ps=1.89u w=0.505u l=0.5u
X26 a_1000_472# a_36_151# a_796_472# VPW nfet_05v0 ad=93.59999f pd=0.88u as=93.59999f ps=0.88u w=0.36u l=0.6u
X27 a_796_472# D VDD VNW pfet_05v0 ad=0.2028p pd=1.3u as=0.3432p ps=2.44u w=0.78u l=0.5u
.ends

.subckt gf180mcu_fd_sc_mcu7t5v0__nor3_1 A1 A2 A3 ZN VDD VNW VPW VSS
X0 ZN A1 a_448_472# VNW pfet_05v0 ad=0.5368p pd=3.32u as=0.3782p ps=1.84u w=1.22u l=0.5u
X1 ZN A1 VSS VPW nfet_05v0 ad=0.2046p pd=1.81u as=0.1209p ps=0.985u w=0.465u l=0.6u
X2 a_244_472# A3 VDD VNW pfet_05v0 ad=0.3172p pd=1.74u as=0.5368p ps=3.32u w=1.22u l=0.5u
X3 a_448_472# A2 a_244_472# VNW pfet_05v0 ad=0.3782p pd=1.84u as=0.3172p ps=1.74u w=1.22u l=0.5u
X4 VSS A2 ZN VPW nfet_05v0 ad=0.1209p pd=0.985u as=0.1209p ps=0.985u w=0.465u l=0.6u
X5 ZN A3 VSS VPW nfet_05v0 ad=0.1209p pd=0.985u as=0.2046p ps=1.81u w=0.465u l=0.6u
.ends

.subckt gf180mcu_fd_sc_mcu7t5v0__dlya_1 I Z VDD VNW VPW VSS
X0 VSS a_448_495# a_608_472# VPW nfet_05v0 ad=0.23275p pd=1.56u as=0.1584p ps=1.6u w=0.36u l=0.6u
X1 Z a_608_472# VSS VPW nfet_05v0 ad=0.3608p pd=2.52u as=0.23275p ps=1.56u w=0.82u l=0.6u
X2 a_448_495# a_36_126# VSS VPW nfet_05v0 ad=0.1584p pd=1.6u as=93.59999f ps=0.88u w=0.36u l=0.6u
X3 VDD I a_36_126# VNW pfet_05v0 ad=0.1116p pd=0.98u as=0.1584p ps=1.6u w=0.36u l=0.5u
X4 VSS I a_36_126# VPW nfet_05v0 ad=93.59999f pd=0.88u as=0.1584p ps=1.6u w=0.36u l=0.6u
X5 VDD a_448_495# a_608_472# VNW pfet_05v0 ad=0.3971p pd=2.16u as=0.1944p ps=1.8u w=0.36u l=0.5u
X6 Z a_608_472# VDD VNW pfet_05v0 ad=0.5368p pd=3.32u as=0.3971p ps=2.16u w=1.22u l=0.5u
X7 a_448_495# a_36_126# VDD VNW pfet_05v0 ad=0.1584p pd=1.6u as=0.1116p ps=0.98u w=0.36u l=0.5u
.ends

.subckt gf180mcu_fd_sc_mcu7t5v0__clkbuf_4 I Z VDD VNW VPW VSS
X0 Z a_224_552# VSS VPW nfet_05v0 ad=0.1183p pd=0.975u as=0.1183p ps=0.975u w=0.455u l=0.6u
X1 VDD a_224_552# Z VNW pfet_05v0 ad=0.3782p pd=1.84u as=0.3782p ps=1.84u w=1.22u l=0.5u
X2 a_224_552# I VDD VNW pfet_05v0 ad=0.2542p pd=1.44u as=0.3608p ps=2.52u w=0.82u l=0.5u
X3 a_224_552# I VSS VPW nfet_05v0 ad=0.2662p pd=2.09u as=0.2662p ps=2.09u w=0.605u l=0.6u
X4 VSS a_224_552# Z VPW nfet_05v0 ad=0.1183p pd=0.975u as=0.1183p ps=0.975u w=0.455u l=0.6u
X5 VDD a_224_552# Z VNW pfet_05v0 ad=0.5368p pd=3.32u as=0.3782p ps=1.84u w=1.22u l=0.5u
X6 VSS a_224_552# Z VPW nfet_05v0 ad=0.2002p pd=1.79u as=0.1183p ps=0.975u w=0.455u l=0.6u
X7 Z a_224_552# VDD VNW pfet_05v0 ad=0.3782p pd=1.84u as=0.428p ps=2.02u w=1.22u l=0.5u
X8 Z a_224_552# VSS VPW nfet_05v0 ad=0.1183p pd=0.975u as=0.2002p ps=1.79u w=0.455u l=0.6u
X9 VDD I a_224_552# VNW pfet_05v0 ad=0.428p pd=2.02u as=0.2542p ps=1.44u w=0.82u l=0.5u
X10 Z a_224_552# VDD VNW pfet_05v0 ad=0.3782p pd=1.84u as=0.3782p ps=1.84u w=1.22u l=0.5u
.ends

.subckt gf180mcu_fd_sc_mcu7t5v0__aoi21_1 A1 A2 B ZN VDD VNW VPW VSS
X0 a_244_68# A2 VSS VPW nfet_05v0 ad=0.1312p pd=1.14u as=0.3608p ps=2.52u w=0.82u l=0.6u
X1 ZN A1 a_244_68# VPW nfet_05v0 ad=0.2569p pd=1.56u as=0.1312p ps=1.14u w=0.82u l=0.6u
X2 VDD B a_36_472# VNW pfet_05v0 ad=0.5346p pd=3.31u as=0.44955p ps=1.955u w=1.215u l=0.5u
X3 ZN A2 a_36_472# VNW pfet_05v0 ad=0.3159p pd=1.735u as=0.5346p ps=3.31u w=1.215u l=0.5u
X4 a_36_472# A1 ZN VNW pfet_05v0 ad=0.44955p pd=1.955u as=0.3159p ps=1.735u w=1.215u l=0.5u
X5 VSS B ZN VPW nfet_05v0 ad=0.2244p pd=1.9u as=0.2569p ps=1.56u w=0.51u l=0.6u
.ends

.subckt gf180mcu_fd_sc_mcu7t5v0__dffnsnq_1 D SETN CLKN Q VDD VNW VPW VSS
X0 a_1308_156# a_36_124# a_1044_472# VPW nfet_05v0 ad=45.6f pd=0.62u as=98.8f ps=0.9u w=0.38u l=0.6u
X1 a_2384_156# a_36_124# a_2160_156# VNW pfet_05v0 ad=0.286p pd=2.18u as=0.21025p ps=1.35u w=0.65u l=0.5u
X2 a_2384_156# SETN VDD VNW pfet_05v0 ad=0.26825p pd=1.68u as=0.3102p ps=2.29u w=0.705u l=0.5u
X3 a_1248_472# a_448_472# a_1044_472# VNW pfet_05v0 ad=72.59999f pd=0.845u as=0.1573p ps=1.125u w=0.605u l=0.5u
X4 VDD a_3148_126# a_2384_156# VNW pfet_05v0 ad=0.2427p pd=1.435u as=0.26825p ps=1.68u w=0.58u l=0.5u
X5 VDD a_1296_336# a_1248_472# VNW pfet_05v0 ad=0.38775p pd=2.135u as=72.59999f ps=0.845u w=0.605u l=0.5u
X6 a_840_156# D VSS VPW nfet_05v0 ad=0.1178p pd=1u as=0.1672p ps=1.64u w=0.38u l=0.6u
X7 a_2384_156# a_448_472# a_2160_156# VPW nfet_05v0 ad=0.1672p pd=1.64u as=98.8f ps=0.9u w=0.38u l=0.6u
X8 a_1044_472# a_448_472# a_840_156# VPW nfet_05v0 ad=98.8f pd=0.9u as=0.1178p ps=1u w=0.38u l=0.6u
X9 VDD CLKN a_36_124# VNW pfet_05v0 ad=0.2444p pd=1.46u as=0.4136p ps=2.76u w=0.94u l=0.5u
X10 a_1296_336# SETN a_1708_156# VPW nfet_05v0 ad=98.8f pd=0.9u as=0.1026p ps=0.92u w=0.38u l=0.6u
X11 a_2160_156# a_448_472# a_1296_336# VNW pfet_05v0 ad=0.21025p pd=1.35u as=0.2354p ps=1.95u w=0.535u l=0.5u
X12 a_3148_126# a_2160_156# VSS VPW nfet_05v0 ad=0.165p pd=1.63u as=0.129p ps=1.115u w=0.375u l=0.6u
X13 a_448_472# a_36_124# VDD VNW pfet_05v0 ad=0.4136p pd=2.76u as=0.2444p ps=1.46u w=0.94u l=0.5u
X14 a_448_472# a_36_124# VSS VPW nfet_05v0 ad=0.2376p pd=1.96u as=0.1404p ps=1.06u w=0.54u l=0.6u
X15 a_3148_126# a_2160_156# VDD VNW pfet_05v0 ad=0.2882p pd=2.19u as=0.2427p ps=1.435u w=0.655u l=0.5u
X16 a_3008_145# SETN a_2384_156# VPW nfet_05v0 ad=0.1335p pd=1.135u as=0.1914p ps=1.75u w=0.435u l=0.6u
X17 a_2160_156# a_36_124# a_1296_336# VPW nfet_05v0 ad=98.8f pd=0.9u as=98.8f ps=0.9u w=0.38u l=0.6u
X18 VSS a_1296_336# a_1308_156# VPW nfet_05v0 ad=0.1064p pd=0.94u as=45.6f ps=0.62u w=0.38u l=0.6u
X19 a_1708_156# a_1044_472# VSS VPW nfet_05v0 ad=0.1026p pd=0.92u as=0.1064p ps=0.94u w=0.38u l=0.6u
X20 Q a_3148_126# VSS VPW nfet_05v0 ad=0.3586p pd=2.51u as=0.3586p ps=2.51u w=0.815u l=0.6u
X21 a_840_156# D VDD VNW pfet_05v0 ad=0.1573p pd=1.125u as=0.5199p ps=3.2u w=0.605u l=0.5u
X22 VDD SETN a_1296_336# VNW pfet_05v0 ad=0.2772p pd=2.14u as=0.23515p ps=1.615u w=0.63u l=0.5u
X23 Q a_3148_126# VDD VNW pfet_05v0 ad=0.5346p pd=3.31u as=0.5346p ps=3.31u w=1.215u l=0.5u
X24 VSS a_3148_126# a_3008_145# VPW nfet_05v0 ad=0.129p pd=1.115u as=0.1335p ps=1.135u w=0.31u l=0.6u
X25 a_1296_336# a_1044_472# VDD VNW pfet_05v0 ad=0.23515p pd=1.615u as=0.38775p ps=2.135u w=0.57u l=0.5u
X26 a_1044_472# a_36_124# a_840_156# VNW pfet_05v0 ad=0.1573p pd=1.125u as=0.1573p ps=1.125u w=0.605u l=0.5u
X27 VSS CLKN a_36_124# VPW nfet_05v0 ad=0.1404p pd=1.06u as=0.2376p ps=1.96u w=0.54u l=0.6u
.ends

.subckt gf180mcu_fd_sc_mcu7t5v0__aoi211_1 A1 A2 B C ZN VDD VNW VPW VSS
X0 ZN A2 a_37_472# VNW pfet_05v0 ad=0.3159p pd=1.735u as=0.5346p ps=3.31u w=1.215u l=0.5u
X1 VSS B ZN VPW nfet_05v0 ad=0.1209p pd=0.985u as=0.21175p ps=1.41u w=0.465u l=0.6u
X2 a_37_472# A1 ZN VNW pfet_05v0 ad=0.37665p pd=1.835u as=0.3159p ps=1.735u w=1.215u l=0.5u
X3 VDD C a_653_472# VNW pfet_05v0 ad=0.5346p pd=3.31u as=0.37665p ps=1.835u w=1.215u l=0.5u
X4 a_245_90# A2 VSS VPW nfet_05v0 ad=85.2f pd=0.95u as=0.3124p ps=2.3u w=0.71u l=0.6u
X5 ZN A1 a_245_90# VPW nfet_05v0 ad=0.21175p pd=1.41u as=85.2f ps=0.95u w=0.71u l=0.6u
X6 a_653_472# B a_37_472# VNW pfet_05v0 ad=0.37665p pd=1.835u as=0.37665p ps=1.835u w=1.215u l=0.5u
X7 ZN C VSS VPW nfet_05v0 ad=0.2046p pd=1.81u as=0.1209p ps=0.985u w=0.465u l=0.6u
.ends

.subckt gf180mcu_fd_sc_mcu7t5v0__dffrnq_2 D RN CLK Q VDD VNW VPW VSS
X0 VSS CLK a_36_151# VPW nfet_05v0 ad=0.1053p pd=0.925u as=0.1782p ps=1.69u w=0.405u l=0.6u
X1 Q a_2665_112# VDD VNW pfet_05v0 ad=0.3159p pd=1.735u as=0.5346p ps=3.31u w=1.215u l=0.5u
X2 VSS RN a_1456_156# VPW nfet_05v0 ad=0.2016p pd=1.48u as=43.2f ps=0.6u w=0.36u l=0.6u
X3 VDD a_2665_112# Q VNW pfet_05v0 ad=0.5346p pd=3.31u as=0.3159p ps=1.735u w=1.215u l=0.5u
X4 a_796_472# D VSS VPW nfet_05v0 ad=93.59999f pd=0.88u as=0.1584p ps=1.6u w=0.36u l=0.6u
X5 VSS a_2665_112# a_2560_156# VPW nfet_05v0 ad=0.1224p pd=1.04u as=94.5f ps=0.885u w=0.36u l=0.6u
X6 a_1000_472# a_448_472# a_796_472# VNW pfet_05v0 ad=0.2028p pd=1.3u as=0.2028p ps=1.3u w=0.78u l=0.5u
X7 a_2248_156# a_36_151# a_1308_423# VNW pfet_05v0 ad=0.25375p pd=1.51u as=0.2424p ps=1.465u w=0.505u l=0.5u
X8 a_2248_156# a_448_472# a_1308_423# VPW nfet_05v0 ad=0.2007p pd=1.475u as=0.2007p ps=1.475u w=0.36u l=0.6u
X9 VDD CLK a_36_151# VNW pfet_05v0 ad=0.2249p pd=1.385u as=0.3806p ps=2.61u w=0.865u l=0.5u
X10 a_1456_156# a_1308_423# a_1288_156# VPW nfet_05v0 ad=43.2f pd=0.6u as=43.2f ps=0.6u w=0.36u l=0.6u
X11 a_1308_423# a_1000_472# VSS VPW nfet_05v0 ad=0.2007p pd=1.475u as=0.2016p ps=1.48u w=0.36u l=0.6u
X12 Q a_2665_112# VSS VPW nfet_05v0 ad=0.2119p pd=1.335u as=0.3586p ps=2.51u w=0.815u l=0.6u
X13 a_2665_112# a_2248_156# a_3041_156# VPW nfet_05v0 ad=0.3586p pd=2.51u as=0.217p ps=1.515u w=0.815u l=0.6u
X14 a_448_472# a_36_151# VDD VNW pfet_05v0 ad=0.3806p pd=2.61u as=0.2249p ps=1.385u w=0.865u l=0.5u
X15 a_1204_472# a_36_151# a_1000_472# VNW pfet_05v0 ad=0.2028p pd=1.3u as=0.2028p ps=1.3u w=0.78u l=0.5u
X16 a_1204_472# RN VDD VNW pfet_05v0 ad=0.3432p pd=2.44u as=0.45p ps=2.02u w=0.78u l=0.5u
X17 a_2560_156# a_36_151# a_2248_156# VPW nfet_05v0 ad=94.5f pd=0.885u as=0.2007p ps=1.475u w=0.36u l=0.6u
X18 a_1288_156# a_448_472# a_1000_472# VPW nfet_05v0 ad=43.2f pd=0.6u as=93.59999f ps=0.88u w=0.36u l=0.6u
X19 a_2665_112# RN VDD VNW pfet_05v0 ad=0.3159p pd=1.735u as=0.33755p ps=1.955u w=1.215u l=0.5u
X20 VDD a_1308_423# a_1204_472# VNW pfet_05v0 ad=0.45p pd=2.02u as=0.2028p ps=1.3u w=0.78u l=0.5u
X21 a_2560_156# a_448_472# a_2248_156# VNW pfet_05v0 ad=0.1313p pd=1.025u as=0.25375p ps=1.51u w=0.505u l=0.5u
X22 a_448_472# a_36_151# VSS VPW nfet_05v0 ad=0.1782p pd=1.69u as=0.1053p ps=0.925u w=0.405u l=0.6u
X23 VDD a_2248_156# a_2665_112# VNW pfet_05v0 ad=0.5346p pd=3.31u as=0.3159p ps=1.735u w=1.215u l=0.5u
X24 a_3041_156# RN VSS VPW nfet_05v0 ad=0.217p pd=1.515u as=0.1224p ps=1.04u w=0.36u l=0.6u
X25 VSS a_2665_112# Q VPW nfet_05v0 ad=0.3586p pd=2.51u as=0.2119p ps=1.335u w=0.815u l=0.6u
X26 VDD a_2665_112# a_2560_156# VNW pfet_05v0 ad=0.33755p pd=1.955u as=0.1313p ps=1.025u w=0.505u l=0.5u
X27 a_1308_423# a_1000_472# VDD VNW pfet_05v0 ad=0.2424p pd=1.465u as=0.2222p ps=1.89u w=0.505u l=0.5u
X28 a_1000_472# a_36_151# a_796_472# VPW nfet_05v0 ad=93.59999f pd=0.88u as=93.59999f ps=0.88u w=0.36u l=0.6u
X29 a_796_472# D VDD VNW pfet_05v0 ad=0.2028p pd=1.3u as=0.3432p ps=2.44u w=0.78u l=0.5u
.ends

.subckt gf180mcu_fd_sc_mcu7t5v0__tieh Z VDD VNW VPW VSS
X0 Z a_125_24# VDD VNW pfet_05v0 ad=0.5368p pd=3.32u as=0.5368p ps=3.32u w=1.22u l=0.5u
X1 a_125_24# a_125_24# VSS VPW nfet_05v0 ad=0.3608p pd=2.52u as=0.3608p ps=2.52u w=0.82u l=0.6u
.ends

.subckt gf180mcu_fd_sc_mcu7t5v0__buf_8 I Z VDD VNW VPW VSS
X0 a_224_472# I VDD VNW pfet_05v0 ad=0.3782p pd=1.84u as=0.3782p ps=1.84u w=1.22u l=0.5u
X1 Z a_224_472# VDD VNW pfet_05v0 ad=0.3782p pd=1.84u as=0.3782p ps=1.84u w=1.22u l=0.5u
X2 a_224_472# I VSS VPW nfet_05v0 ad=0.2132p pd=1.34u as=0.2132p ps=1.34u w=0.82u l=0.6u
X3 VSS a_224_472# Z VPW nfet_05v0 ad=0.3608p pd=2.52u as=0.2132p ps=1.34u w=0.82u l=0.6u
X4 VDD a_224_472# Z VNW pfet_05v0 ad=0.3782p pd=1.84u as=0.3782p ps=1.84u w=1.22u l=0.5u
X5 Z a_224_472# VDD VNW pfet_05v0 ad=0.3782p pd=1.84u as=0.3782p ps=1.84u w=1.22u l=0.5u
X6 a_224_472# I VSS VPW nfet_05v0 ad=0.2132p pd=1.34u as=0.3608p ps=2.52u w=0.82u l=0.6u
X7 Z a_224_472# VSS VPW nfet_05v0 ad=0.2132p pd=1.34u as=0.2132p ps=1.34u w=0.82u l=0.6u
X8 VDD a_224_472# Z VNW pfet_05v0 ad=0.3782p pd=1.84u as=0.3782p ps=1.84u w=1.22u l=0.5u
X9 Z a_224_472# VSS VPW nfet_05v0 ad=0.2132p pd=1.34u as=0.2132p ps=1.34u w=0.82u l=0.6u
X10 Z a_224_472# VSS VPW nfet_05v0 ad=0.2132p pd=1.34u as=0.2132p ps=1.34u w=0.82u l=0.6u
X11 VDD I a_224_472# VNW pfet_05v0 ad=0.3782p pd=1.84u as=0.3782p ps=1.84u w=1.22u l=0.5u
X12 VDD a_224_472# Z VNW pfet_05v0 ad=0.3782p pd=1.84u as=0.3782p ps=1.84u w=1.22u l=0.5u
X13 Z a_224_472# VDD VNW pfet_05v0 ad=0.3782p pd=1.84u as=0.3782p ps=1.84u w=1.22u l=0.5u
X14 VSS a_224_472# Z VPW nfet_05v0 ad=0.2132p pd=1.34u as=0.2132p ps=1.34u w=0.82u l=0.6u
X15 VDD I a_224_472# VNW pfet_05v0 ad=0.3782p pd=1.84u as=0.3782p ps=1.84u w=1.22u l=0.5u
X16 VSS a_224_472# Z VPW nfet_05v0 ad=0.2132p pd=1.34u as=0.2132p ps=1.34u w=0.82u l=0.6u
X17 VDD a_224_472# Z VNW pfet_05v0 ad=0.5368p pd=3.32u as=0.3782p ps=1.84u w=1.22u l=0.5u
X18 VSS a_224_472# Z VPW nfet_05v0 ad=0.2132p pd=1.34u as=0.2132p ps=1.34u w=0.82u l=0.6u
X19 Z a_224_472# VDD VNW pfet_05v0 ad=0.3782p pd=1.84u as=0.3782p ps=1.84u w=1.22u l=0.5u
X20 VSS I a_224_472# VPW nfet_05v0 ad=0.2132p pd=1.34u as=0.2132p ps=1.34u w=0.82u l=0.6u
X21 a_224_472# I VDD VNW pfet_05v0 ad=0.3782p pd=1.84u as=0.5368p ps=3.32u w=1.22u l=0.5u
X22 VSS I a_224_472# VPW nfet_05v0 ad=0.2132p pd=1.34u as=0.2132p ps=1.34u w=0.82u l=0.6u
X23 Z a_224_472# VSS VPW nfet_05v0 ad=0.2132p pd=1.34u as=0.2132p ps=1.34u w=0.82u l=0.6u
.ends

.subckt gf180mcu_fd_sc_mcu7t5v0__oai21_1 A1 A2 B ZN VDD VNW VPW VSS
X0 VSS B a_36_68# VPW nfet_05v0 ad=0.3608p pd=2.52u as=0.2132p ps=1.34u w=0.82u l=0.6u
X1 ZN A2 a_36_68# VPW nfet_05v0 ad=0.2132p pd=1.34u as=0.3608p ps=2.52u w=0.82u l=0.6u
X2 VDD B ZN VNW pfet_05v0 ad=0.4972p pd=3.14u as=0.4248p ps=1.94u w=1.13u l=0.5u
X3 a_244_472# A2 VDD VNW pfet_05v0 ad=0.3172p pd=1.74u as=0.5978p ps=3.42u w=1.22u l=0.5u
X4 ZN A1 a_244_472# VNW pfet_05v0 ad=0.4248p pd=1.94u as=0.3172p ps=1.74u w=1.22u l=0.5u
X5 a_36_68# A1 ZN VPW nfet_05v0 ad=0.2132p pd=1.34u as=0.2132p ps=1.34u w=0.82u l=0.6u
.ends

.subckt gf180mcu_fd_sc_mcu7t5v0__and3_1 A1 A2 A3 Z VDD VNW VPW VSS
X0 Z a_36_148# VDD VNW pfet_05v0 ad=0.5346p pd=3.31u as=0.4268p ps=2.175u w=1.215u l=0.5u
X1 a_428_148# A2 a_244_148# VPW nfet_05v0 ad=79.8f pd=0.8u as=60.8f ps=0.7u w=0.38u l=0.6u
X2 Z a_36_148# VSS VPW nfet_05v0 ad=0.341p pd=2.43u as=0.2424p ps=1.635u w=0.775u l=0.6u
X3 VSS A3 a_428_148# VPW nfet_05v0 ad=0.2424p pd=1.635u as=79.8f ps=0.8u w=0.38u l=0.6u
X4 a_244_148# A1 a_36_148# VPW nfet_05v0 ad=60.8f pd=0.7u as=0.1672p ps=1.64u w=0.38u l=0.6u
X5 VDD A1 a_36_148# VNW pfet_05v0 ad=0.1391p pd=1.055u as=0.2354p ps=1.95u w=0.535u l=0.5u
X6 a_36_148# A2 VDD VNW pfet_05v0 ad=0.1391p pd=1.055u as=0.1391p ps=1.055u w=0.535u l=0.5u
X7 VDD A3 a_36_148# VNW pfet_05v0 ad=0.4268p pd=2.175u as=0.1391p ps=1.055u w=0.535u l=0.5u
.ends

.subckt gf180mcu_fd_sc_mcu7t5v0__or3_1 A1 A2 A3 Z VDD VNW VPW VSS
X0 a_224_604# A1 a_36_88# VNW pfet_05v0 ad=0.1736p pd=1.18u as=0.2464p ps=2u w=0.56u l=0.5u
X1 a_36_88# A2 VSS VPW nfet_05v0 ad=0.14p pd=1.1u as=0.104p ps=0.92u w=0.4u l=0.6u
X2 Z a_36_88# VDD VNW pfet_05v0 ad=0.5368p pd=3.32u as=0.389p ps=2.02u w=1.22u l=0.5u
X3 VSS A1 a_36_88# VPW nfet_05v0 ad=0.104p pd=0.92u as=0.176p ps=1.68u w=0.4u l=0.6u
X4 a_448_604# A2 a_224_604# VNW pfet_05v0 ad=0.224p pd=1.36u as=0.1736p ps=1.18u w=0.56u l=0.5u
X5 VSS A3 a_36_88# VPW nfet_05v0 ad=0.224p pd=1.52u as=0.14p ps=1.1u w=0.4u l=0.6u
X6 VDD A3 a_448_604# VNW pfet_05v0 ad=0.389p pd=2.02u as=0.224p ps=1.36u w=0.56u l=0.5u
X7 Z a_36_88# VSS VPW nfet_05v0 ad=0.3608p pd=2.52u as=0.224p ps=1.52u w=0.82u l=0.6u
.ends
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
