Hive-RSI-Lab/ece298a-pll/gl/tt_um_ihsan_sa_pll.v

module tt_um_ihsan_sa_pll (clk,
    ena,
    rst_n,
    VPWR,
    VGND,
    ua,
    ui_in,
    uio_in,
    uio_oe,
    uio_out,
    uo_out);
 input clk;
 input ena;
 input rst_n;
 inout VPWR;
 inout VGND;
 inout [7:0] ua;
 input [7:0] ui_in;
 input [7:0] uio_in;
 output [7:0] uio_oe;
 output [7:0] uio_out;
 output [7:0] uo_out;

 wire _000_;
 wire _001_;
 wire _002_;
 wire _003_;
 wire _004_;
 wire _005_;
 wire _006_;
 wire _007_;
 wire _008_;
 wire _009_;
 wire _010_;
 wire _011_;
 wire _012_;
 wire _013_;
 wire _014_;
 wire net39;
 wire \u_ihsan_sa_pll.clk_pre_regs ;
 wire _017_;
 wire _018_;
 wire _019_;
 wire _020_;
 wire _021_;
 wire _022_;
 wire _023_;
 wire _024_;
 wire _025_;
 wire _026_;
 wire _027_;
 wire _028_;
 wire _029_;
 wire _030_;
 wire _031_;
 wire _032_;
 wire _033_;
 wire _034_;
 wire _035_;
 wire _036_;
 wire _037_;
 wire _038_;
 wire _039_;
 wire _040_;
 wire _041_;
 wire _042_;
 wire _043_;
 wire _044_;
 wire _045_;
 wire _046_;
 wire _047_;
 wire _048_;
 wire _049_;
 wire _050_;
 wire _051_;
 wire _052_;
 wire _053_;
 wire _054_;
 wire _055_;
 wire _056_;
 wire _057_;
 wire _058_;
 wire _059_;
 wire _060_;
 wire _061_;
 wire _062_;
 wire _063_;
 wire _064_;
 wire net36;
 wire net37;
 wire net38;
 wire net1;
 wire rst_n_sync_q1;
 wire rst_n_sync_q2;
 wire \u_ihsan_sa_pll.clk_fb ;
 wire \u_ihsan_sa_pll.clk_fb_int ;
 wire \u_ihsan_sa_pll.clk_pre ;
 wire \u_ihsan_sa_pll.cp_trim0 ;
 wire \u_ihsan_sa_pll.cp_trim1 ;
 wire \u_ihsan_sa_pll.lock ;
 wire \u_ihsan_sa_pll.obs_int ;
 wire \u_ihsan_sa_pll.obs_out ;
 wire \u_ihsan_sa_pll.obs_q3 ;
 wire \u_ihsan_sa_pll.pfd_dn ;
 wire \u_ihsan_sa_pll.pfd_dn_int ;
 wire \u_ihsan_sa_pll.pfd_dn_q ;
 wire \u_ihsan_sa_pll.pfd_up ;
 wire \u_ihsan_sa_pll.pfd_up_int ;
 wire \u_ihsan_sa_pll.pfd_up_q ;
 wire \u_ihsan_sa_pll.pll_en ;
 wire \u_ihsan_sa_pll.recover ;
 wire \u_ihsan_sa_pll.u_div.div_cnt[0] ;
 wire \u_ihsan_sa_pll.u_div.div_cnt[1] ;
 wire \u_ihsan_sa_pll.u_div.div_cnt[2] ;
 wire \u_ihsan_sa_pll.u_div.fb_en ;
 wire \u_ihsan_sa_pll.u_div.last ;
 wire \u_ihsan_sa_pll.u_lock.cnt_nxt[0] ;
 wire \u_ihsan_sa_pll.u_lock.cnt_nxt[1] ;
 wire \u_ihsan_sa_pll.u_lock.cnt_nxt[2] ;
 wire \u_ihsan_sa_pll.u_lock.cnt_nxt[3] ;
 wire \u_ihsan_sa_pll.u_lock.cnt_nxt[4] ;
 wire \u_ihsan_sa_pll.u_lock.lock_cnt[0] ;
 wire \u_ihsan_sa_pll.u_lock.lock_cnt[1] ;
 wire \u_ihsan_sa_pll.u_lock.lock_cnt[2] ;
 wire \u_ihsan_sa_pll.u_lock.lock_cnt[3] ;
 wire \u_ihsan_sa_pll.u_lock.lock_cnt[4] ;
 wire \u_ihsan_sa_pll.u_lock.wd_cnt[0] ;
 wire \u_ihsan_sa_pll.u_lock.wd_cnt[1] ;
 wire \u_ihsan_sa_pll.u_lock.wd_cnt[2] ;
 wire \u_ihsan_sa_pll.u_lock.wd_cnt[3] ;
 wire \u_ihsan_sa_pll.u_lock.wd_cnt[4] ;
 wire \u_ihsan_sa_pll.u_lock.wd_cnt[5] ;
 wire \u_ihsan_sa_pll.u_lock.wd_cnt[6] ;
 wire \u_ihsan_sa_pll.u_lock.wd_cnt[7] ;
 wire \u_ihsan_sa_pll.u_lock.wd_cnt[8] ;
 wire \u_ihsan_sa_pll.u_lock.wd_cnt[9] ;
 wire \u_ihsan_sa_pll.u_lock.wide_q ;
 wire \u_ihsan_sa_pll.u_pfd.pfd_both ;
 wire \u_ihsan_sa_pll.u_pfd.pfd_dly_mid ;
 wire \u_ihsan_sa_pll.u_pfd.pfd_rst ;
 wire \u_ihsan_sa_pll.u_pre.pre_q0 ;
 wire \u_ihsan_sa_pll.u_pre.vco_div2 ;
 wire net2;
 wire net3;
 wire net4;
 wire net5;
 wire net6;
 wire net7;
 wire net8;
 wire net17;
 wire net18;
 wire net19;
 wire net20;
 wire net21;
 wire net22;
 wire net23;
 wire net24;
 wire net25;
 wire net26;
 wire net27;
 wire net28;
 wire net29;
 wire net30;
 wire net31;
 wire net32;
 wire net33;
 wire net34;
 wire net35;
 wire net9;
 wire net10;
 wire net11;
 wire net12;
 wire net13;
 wire net14;
 wire net15;
 wire net16;
 wire net;
 wire net40;
 wire \u_ihsan_sa_pll.clk_fb_int_regs ;
 wire clknet_0_clk;
 wire clknet_2_0__leaf_clk;
 wire clknet_2_1__leaf_clk;
 wire clknet_2_2__leaf_clk;
 wire clknet_2_3__leaf_clk;
 wire \clknet_0_u_ihsan_sa_pll.u_pre.pre_q0 ;
 wire \clknet_1_0__leaf_u_ihsan_sa_pll.u_pre.pre_q0 ;
 wire \clknet_1_1__leaf_u_ihsan_sa_pll.u_pre.pre_q0 ;
 wire \clknet_0_u_ihsan_sa_pll.clk_pre ;
 wire \clknet_1_0__leaf_u_ihsan_sa_pll.clk_pre ;
 wire \clknet_0_u_ihsan_sa_pll.clk_pre_regs ;
 wire \clknet_1_0__leaf_u_ihsan_sa_pll.clk_pre_regs ;
 wire \clknet_1_1__leaf_u_ihsan_sa_pll.clk_pre_regs ;
 wire \clknet_0_u_ihsan_sa_pll.clk_fb_int ;
 wire \clknet_1_0__leaf_u_ihsan_sa_pll.clk_fb_int ;
 wire \clknet_0_u_ihsan_sa_pll.clk_fb_int_regs ;
 wire \clknet_1_0__leaf_u_ihsan_sa_pll.clk_fb_int_regs ;
 wire delaynet_0_clk_pre;

 gf180mcu_fd_sc_mcu7t5v0__fillcap_32 FILLER_0_104 (.VDD(VPWR),
    .VNW(VPWR),
    .VPW(VGND),
    .VSS(VGND));
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
    .VNW(VPWR),
    .VPW(VGND),
    .VSS(VGND));
 gf180mcu_fd_sc_mcu7t5v0__fill_1 FILLER_66_527 (.VDD(VPWR),
    .VNW(VPWR),
    .VPW(VGND),
    .VSS(VGND));
 gf180mcu_fd_sc_mcu7t5v0__fillcap_8 FILLER_66_562 (.VDD(VPWR),
    .VNW(VPWR),
    .VPW(VGND),
    .VSS(VGND));
 gf180mcu_fd_sc_mcu7t5v0__fillcap_4 FILLER_66_570 (.VDD(VPWR),
    .VNW(VPWR),
    .VPW(VGND),
    .VSS(VGND));
 gf180mcu_fd_sc_mcu7t5v0__fill_1 FILLER_66_574 (.VDD(VPWR),
    .VNW(VPWR),
    .VPW(VGND),
    .VSS(VGND));
 gf180mcu_fd_sc_mcu7t5v0__fillcap_16 FILLER_66_577 (.VDD(VPWR),
    .VNW(VPWR),
    .VPW(VGND),
    .VSS(VGND));
 gf180mcu_fd_sc_mcu7t5v0__fillcap_8 FILLER_66_593 (.VDD(VPWR),
    .VNW(VPWR),
    .VPW(VGND),
    .VSS(VGND));
 gf180mcu_fd_sc_mcu7t5v0__fillcap_4 FILLER_66_601 (.VDD(VPWR),
    .VNW(VPWR),
    .VPW(VGND),
    .VSS(VGND));
 gf180mcu_fd_sc_mcu7t5v0__fillcap_4 FILLER_67_136 (.VDD(VPWR),
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
