Hive-RSI-Lab/ece298a-pll/blocks/pll/digital/log/precheck_run/design/tt_um_ihsan_sa_pll.v

module tt_um_ihsan_sa_pll (clk,
    ena,
    rst_n,
    VPWR,
    VGND,
    ui_in,
    uio_in,
    uio_oe,
    uio_out,
    uo_out);
 input clk;
 input ena;
 input rst_n;
 inout VPWR;
 inout VGND;
 input [7:0] ui_in;
 input [7:0] uio_in;
 output [7:0] uio_oe;
 output [7:0] uio_out;
 output [7:0] uo_out;

 wire _000_;
 wire _001_;
 wire _002_;
 wire _003_;
 wire _004_;
 wire net29;
 wire net30;
 wire \u_ihsan_sa_pll.clk_pre_regs ;
 wire _008_;
 wire _009_;
 wire _010_;
 wire _011_;
 wire _012_;
 wire _013_;
 wire _014_;
 wire _015_;
 wire _016_;
 wire _017_;
 wire _018_;
 wire _019_;
 wire _020_;
 wire _021_;
 wire _022_;
 wire _023_;
 wire _024_;
 wire _025_;
 wire _026_;
 wire _027_;
 wire _028_;
 wire _029_;
 wire _030_;
 wire net27;
 wire net28;
 wire net1;
 wire \u_ihsan_sa_pll.clk_fb ;
 wire \u_ihsan_sa_pll.clk_fb_int ;
 wire \u_ihsan_sa_pll.clk_pre ;
 wire \u_ihsan_sa_pll.cp_trim0 ;
 wire \u_ihsan_sa_pll.cp_trim1 ;
 wire \u_ihsan_sa_pll.lock ;
 wire \u_ihsan_sa_pll.obs_int ;
 wire \u_ihsan_sa_pll.obs_out ;
 wire \u_ihsan_sa_pll.obs_q3 ;
 wire \u_ihsan_sa_pll.pfd_dn ;
 wire \u_ihsan_sa_pll.pfd_up ;
 wire \u_ihsan_sa_pll.pll_en ;
 wire \u_ihsan_sa_pll.u_div.div_cnt[0] ;
 wire \u_ihsan_sa_pll.u_div.div_cnt[1] ;
 wire \u_ihsan_sa_pll.u_div.div_cnt[2] ;
 wire \u_ihsan_sa_pll.u_div.fb_en ;
 wire \u_ihsan_sa_pll.u_div.last ;
 wire \u_ihsan_sa_pll.u_lock.cnt_nxt[0] ;
 wire \u_ihsan_sa_pll.u_lock.cnt_nxt[1] ;
 wire \u_ihsan_sa_pll.u_lock.cnt_nxt[2] ;
 wire \u_ihsan_sa_pll.u_lock.cnt_nxt[3] ;
 wire \u_ihsan_sa_pll.u_lock.cnt_nxt[4] ;
 wire \u_ihsan_sa_pll.u_lock.lock_cnt[0] ;
 wire \u_ihsan_sa_pll.u_lock.lock_cnt[1] ;
 wire \u_ihsan_sa_pll.u_lock.lock_cnt[2] ;
 wire \u_ihsan_sa_pll.u_lock.lock_cnt[3] ;
 wire \u_ihsan_sa_pll.u_lock.lock_cnt[4] ;
 wire \u_ihsan_sa_pll.u_lock.wide_q ;
 wire \u_ihsan_sa_pll.u_pfd.pfd_both ;
 wire \u_ihsan_sa_pll.u_pfd.pfd_dly_mid ;
 wire \u_ihsan_sa_pll.u_pfd.pfd_rst ;
 wire \u_ihsan_sa_pll.u_pre.pre_q0 ;
 wire \u_ihsan_sa_pll.u_pre.pre_q1 ;
 wire net2;
 wire net3;
 wire net4;
 wire net5;
 wire net6;
 wire net7;
 wire net8;
 wire net11;
 wire net12;
 wire net13;
 wire net14;
 wire net15;
 wire net16;
 wire net17;
 wire net18;
 wire net19;
 wire net20;
 wire net21;
 wire net22;
 wire net23;
 wire net24;
 wire net25;
 wire net26;
 wire net9;
 wire net10;
 wire net;
 wire net31;
 wire \u_ihsan_sa_pll.clk_fb_int_regs ;
 wire clknet_0_clk;
 wire clknet_1_0__leaf_clk;
 wire clknet_1_1__leaf_clk;
 wire \clknet_1_0__leaf_u_ihsan_sa_pll.u_pre.pre_q0 ;
 wire net33;
 wire \clknet_1_0__leaf_u_ihsan_sa_pll.u_pre.pre_q1 ;
 wire net32;
 wire \clknet_0_u_ihsan_sa_pll.clk_pre ;
 wire \clknet_1_0__leaf_u_ihsan_sa_pll.clk_pre ;
 wire \clknet_0_u_ihsan_sa_pll.clk_pre_regs ;
 wire \clknet_1_0__leaf_u_ihsan_sa_pll.clk_pre_regs ;
 wire \clknet_1_1__leaf_u_ihsan_sa_pll.clk_pre_regs ;
 wire \clknet_0_u_ihsan_sa_pll.clk_fb_int ;
 wire \clknet_1_0__leaf_u_ihsan_sa_pll.clk_fb_int ;
 wire \clknet_0_u_ihsan_sa_pll.clk_fb_int_regs ;
 wire \clknet_1_0__leaf_u_ihsan_sa_pll.clk_fb_int_regs ;
 wire delaynet_0_clk_pre;

 gf180mcu_fd_sc_mcu7t5v0__fillcap_32 FILLER_0_104 (.VDD(VPWR),
    .VNW(VPWR),
    .VPW(VGND),
    .VSS(VGND));
 gf180mcu_fd_sc_mcu7t5v0__fillcap_32 FILLER_0_138 (.VDD(VPWR),
    .VNW(VPWR),
    .VPW(VGND),
    .VSS(VGND));
 gf180mcu_fd_sc_mcu7t5v0__fillcap_32 FILLER_0_172 (.VDD(VPWR),
    .VNW(VPWR),
    .VPW(VGND),
    .VSS(VGND));
 gf180mcu_fd_sc_mcu7t5v0__fillcap_32 FILLER_0_2 (.VDD(VPWR),
    .VNW(VPWR),
    .VPW(VGND),
    .VSS(VGND));
 gf180mcu_fd_sc_mcu7t5v0__fillcap_32 FILLER_0_206 (.VDD(VPWR),
    .VNW(VPWR),
    .VPW(VGND),
    .VSS(VGND));
 gf180mcu_fd_sc_mcu7t5v0__fillcap_32 FILLER_0_240 (.VDD(VPWR),
    .VNW(VPWR),
    .VPW(VGND),
    .VSS(VGND));
 gf180mcu_fd_sc_mcu7t5v0__fillcap_32 FILLER_0_274 (.VDD(VPWR),
    .VNW(VPWR),
    .VPW(VGND),
    .VSS(VGND));
 gf180mcu_fd_sc_mcu7t5v0__fillcap_32 FILLER_0_308 (.VDD(VPWR),
    .VNW(VPWR),
    .VPW(VGND),
    .VSS(VGND));
 gf180mcu_fd_sc_mcu7t5v0__fillcap_32 FILLER_0_342 (.VDD(VPWR),
    .VNW(VPWR),
    .VPW(VGND),
    .VSS(VGND));
 gf180mcu_fd_sc_mcu7t5v0__fillcap_32 FILLER_0_36 (.VDD(VPWR),
    .VNW(VPWR),
    .VPW(VGND),
    .VSS(VGND));
 gf180mcu_fd_sc_mcu7t5v0__fillcap_32 FILLER_0_376 (.VDD(VPWR),
    .VNW(VPWR),
    .VPW(VGND),
    .VSS(VGND));
 gf180mcu_fd_sc_mcu7t5v0__fillcap_32 FILLER_0_410 (.VDD(VPWR),
    .VNW(VPWR),
    .VPW(VGND),
    .VSS(VGND));
 gf180mcu_fd_sc_mcu7t5v0__fillcap_32 FILLER_0_444 (.VDD(VPWR),
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
    .VSS(VGND));
 gf180mcu_fd_sc_mcu7t5v0__filltie TAP_TAPCELL_ROW_29_335 (.VDD(VPWR),
    .VSS(VGND));
 gf180mcu_fd_sc_mcu7t5v0__filltie TAP_TAPCELL_ROW_29_336 (.VDD(VPWR),
    .VSS(VGND));
 gf180mcu_fd_sc_mcu7t5v0__filltie TAP_TAPCELL_ROW_29_337 (.VDD(VPWR),
    .VSS(VGND));
 gf180mcu_fd_sc_mcu7t5v0__filltie TAP_TAPCELL_ROW_29_338 (.VDD(VPWR),
    .VSS(VGND));
 gf180mcu_fd_sc_mcu7t5v0__filltie TAP_TAPCELL_ROW_29_339 (.VDD(VPWR),
    .VSS(VGND));
 gf180mcu_fd_sc_mcu7t5v0__filltie TAP_TAPCELL_ROW_29_340 (.VDD(VPWR),
    .VSS(VGND));
 gf180mcu_fd_sc_mcu7t5v0__filltie TAP_TAPCELL_ROW_2_103 (.VDD(VPWR),
    .VSS(VGND));
 gf180mcu_fd_sc_mcu7t5v0__filltie TAP_TAPCELL_ROW_2_104 (.VDD(VPWR),
    .VSS(VGND));
 gf180mcu_fd_sc_mcu7t5v0__filltie TAP_TAPCELL_ROW_2_105 (.VDD(VPWR),
    .VSS(VGND));
 gf180mcu_fd_sc_mcu7t5v0__filltie TAP_TAPCELL_ROW_2_106 (.VDD(VPWR),
    .VSS(VGND));
 gf180mcu_fd_sc_mcu7t5v0__filltie TAP_TAPCELL_ROW_2_107 (.VDD(VPWR),
    .VSS(VGND));
 gf180mcu_fd_sc_mcu7t5v0__filltie TAP_TAPCELL_ROW_2_108 (.VDD(VPWR),
    .VSS(VGND));
 gf180mcu_fd_sc_mcu7t5v0__filltie TAP_TAPCELL_ROW_2_109 (.VDD(VPWR),
    .VSS(VGND));
 gf180mcu_fd_sc_mcu7t5v0__filltie TAP_TAPCELL_ROW_2_110 (.VDD(VPWR),
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
