Hive-RSI-Lab/ece298a-pll/blocks/pll/digital/log/formal/cov/engine_0/trace7_tb.v

`ifndef VERILATOR
module testbench;
  reg [4095:0] vcdfile;
  reg clock;
`else
module testbench(input clock, output reg genclock);
  initial genclock = 1;
`endif
  reg genclock = 1;
  reg [31:0] cycle = 0;
  reg [0:0] PI_obs_sel;
  reg [0:0] PI_vco_div2;
  wire [0:0] PI_clk = clock;
  reg [2:0] PI_n_sel;
  reg [1:0] PI_cp_trim_in;
  reg [0:0] PI_rst_n;
  reg [0:0] PI_pll_en_in;
  ihsan_sa_pll_formal UUT (
    .obs_sel(PI_obs_sel),
    .vco_div2(PI_vco_div2),
    .clk(PI_clk),
    .n_sel(PI_n_sel),
    .cp_trim_in(PI_cp_trim_in),
    .rst_n(PI_rst_n),
    .pll_en_in(PI_pll_en_in)
  );
`ifndef VERILATOR
  initial begin
    if ($value$plusargs("vcd=%s", vcdfile)) begin
      $dumpfile(vcdfile);
      $dumpvars(0, testbench);
    end
    #5 clock = 0;
    while (genclock) begin
      #5 clock = 0;
      #5 clock = 1;
    end
  end
`endif
  initial begin
`ifndef VERILATOR
    #1;
`endif
    // UUT.$auto$clk2fflogic.\cc:101:sample_data$$flatten/dut .\/u_div .\$0/div_cnt[2:0]#sampled$526  = 3'b000;
    // UUT.$auto$clk2fflogic.\cc:101:sample_data$$flatten/dut .\/u_lock .\$0/lock[0:0]#sampled$580  = 1'b0;
    // UUT.$auto$clk2fflogic.\cc:101:sample_data$$flatten/dut .\/u_lock .\$0/recover[0:0]#sampled$544  = 1'b0;
    // UUT.$auto$clk2fflogic.\cc:101:sample_data$$flatten/dut .\/u_lock .\$0/wd_cnt[9:0]#sampled$562  = 10'b0000000000;
    // UUT.$auto$clk2fflogic.\cc:101:sample_data$$flatten/dut .\/u_pre .\$0/pre_q0[0:0]#sampled$702  = 1'b0;
    // UUT.$auto$clk2fflogic.\cc:101:sample_data$$flatten/dut .\/u_pre .\$0/pre_q1[0:0]#sampled$684  = 1'b0;
    // UUT.$auto$clk2fflogic.\cc:101:sample_data$$flatten/dut .\/u_pre .\$0/q3[0:0]#sampled$666  = 1'b0;
    // UUT.$auto$clk2fflogic.\cc:101:sample_data$/dut .u_ctrl.\cp_trim0#sampled$470  = 1'b0;
    // UUT.$auto$clk2fflogic.\cc:101:sample_data$/dut .u_ctrl.\cp_trim1#sampled$488  = 1'b0;
    // UUT.$auto$clk2fflogic.\cc:101:sample_data$/dut .u_ctrl.\cp_trim_in[0]#sampled$472  = 1'b0;
    // UUT.$auto$clk2fflogic.\cc:101:sample_data$/dut .u_ctrl.\cp_trim_in[1]#sampled$490  = 1'b0;
    // UUT.$auto$clk2fflogic.\cc:101:sample_data$/dut .u_ctrl.\pll_en#sampled$452  = 1'b0;
    // UUT.$auto$clk2fflogic.\cc:101:sample_data$/dut .u_ctrl.\pll_en_in#sampled$454  = 1'b0;
    // UUT.$auto$clk2fflogic.\cc:101:sample_data$/dut .u_div.\div_cnt#sampled$524  = 3'b000;
    // UUT.$auto$clk2fflogic.\cc:101:sample_data$/dut .u_div.\fb_en#sampled$506  = 1'b0;
    // UUT.$auto$clk2fflogic.\cc:101:sample_data$/dut .u_div.\last#sampled$508  = 1'b0;
    // UUT.$auto$clk2fflogic.\cc:101:sample_data$/dut .u_lock.\cnt_nxt#sampled$598  = 5'b00000;
    // UUT.$auto$clk2fflogic.\cc:101:sample_data$/dut .u_lock.\lock#sampled$578  = 1'b0;
    // UUT.$auto$clk2fflogic.\cc:101:sample_data$/dut .u_lock.\lock_cnt#sampled$596  = 5'b00000;
    // UUT.$auto$clk2fflogic.\cc:101:sample_data$/dut .u_lock.\recover#sampled$542  = 1'b0;
    // UUT.$auto$clk2fflogic.\cc:101:sample_data$/dut .u_lock.\wd_cnt#sampled$560  = 10'b0000000000;
    // UUT.$auto$clk2fflogic.\cc:101:sample_data$/dut .u_lock.\wide_q#sampled$614  = 1'b0;
    // UUT.$auto$clk2fflogic.\cc:101:sample_data$/dut .u_pfd.\pfd_fb_q#sampled$632  = 1'b0;
    // UUT.$auto$clk2fflogic.\cc:101:sample_data$/dut .u_pfd.\pfd_ref_q#sampled$648  = 1'b0;
    // UUT.$auto$clk2fflogic.\cc:101:sample_data$/dut .u_pre.\pre_q0#sampled$700  = 1'b0;
    // UUT.$auto$clk2fflogic.\cc:101:sample_data$/dut .u_pre.\pre_q1#sampled$682  = 1'b0;
    // UUT.$auto$clk2fflogic.\cc:101:sample_data$/dut .u_pre.\q3#sampled$664  = 1'b0;
    // UUT.$auto$clk2fflogic.\cc:75:sample_control$$auto$rtlil .\cc:3251:Not$625#sampled$626  = 1'b0;
    // UUT.$auto$clk2fflogic.\cc:75:sample_control$/dut .u_pfd.\pfd_clr$async_cut#sampled$658  = 1'b0;
    // UUT.$auto$clk2fflogic.\cc:87:sample_control_edge$/dut .u_div.\clk_pre#sampled$510  = 1'b0;
    // UUT.$auto$clk2fflogic.\cc:87:sample_control_edge$/dut .u_pfd.\clk#sampled$652  = 1'b1;
    // UUT.$auto$clk2fflogic.\cc:87:sample_control_edge$/dut .u_pfd.\clk_fb#sampled$636  = 1'b1;
    // UUT.$auto$clk2fflogic.\cc:87:sample_control_edge$/dut .u_pre.\pre_q0#sampled$686  = 1'b1;
    // UUT.$auto$clk2fflogic.\cc:87:sample_control_edge$/dut .u_pre.\pre_q1#sampled$668  = 1'b1;
    // UUT.$auto$clk2fflogic.\cc:87:sample_control_edge$/dut .u_pre.\vco_div2#sampled$704  = 1'b1;
    UUT._witness_.anyinit_procdff_418 = 1'b0;
    UUT._witness_.anyinit_procdff_419 = 1'b0;
    UUT._witness_.anyinit_procdff_420 = 1'b0;
    UUT._witness_.anyinit_procdff_421 = 1'b0;
    UUT._witness_.anyinit_procdff_422 = 1'b0;
    UUT._witness_.anyinit_procdff_423 = 1'b0;
    UUT._witness_.anyinit_procdff_424 = 1'b0;
    UUT._witness_.anyinit_procdff_425 = 1'b0;
    UUT._witness_.anyinit_procdff_426 = 1'b0;
    UUT.clk_q = 1'b0;
    UUT.dut.u_pfd.pfd_fb_q$async_arst_past = 1'b0;
    UUT.dut.u_pfd.pfd_fb_q$async_clk_past = 1'b0;
    UUT.dut.u_pfd.pfd_fb_q$async_d_past = 1'b0;
    UUT.dut.u_pfd.pfd_fb_q$async_q_past = 1'b0;
    UUT.dut.u_pfd.pfd_ref_q$async_arst_past = 1'b0;
    UUT.dut.u_pfd.pfd_ref_q$async_clk_past = 1'b0;
    UUT.dut.u_pfd.pfd_ref_q$async_d_past = 1'b0;
    UUT.dut.u_pfd.pfd_ref_q$async_q_past = 1'b0;
    UUT.fb_ok = 1'b0;
    UUT.fb_q = 1'b0;
    UUT.fb_seen = 1'b0;
    UUT.hist = 16'b1111111111111111;
    UUT.hist_q = 16'b1111111111111111;
    UUT.n_last = 3'b001;
    UUT.n_q = 3'b001;
    UUT.n_stab = 1'b1;
    UUT.obs_q = 1'b0;
    UUT.past_valid = 1'b0;
    UUT.pre_cnt = 4'b0000;
    UUT.pre_ok = 1'b0;
    UUT.pre_seen = 1'b0;
    UUT.prep_q = 1'b0;
    UUT.vco_cnt = 4'b0000;
    UUT.vco_q = 1'b0;
    UUT.wide_q = 1'b0;
    UUT.wide_s = 1'b1;

    // state 0
    PI_obs_sel = 1'b0;
    PI_vco_div2 = 1'b0;
    PI_n_sel = 3'b000;
    PI_cp_trim_in = 2'b00;
    PI_rst_n = 1'b0;
    PI_pll_en_in = 1'b0;
  end
  always @(posedge clock) begin
    // state 1
    if (cycle == 0) begin
      PI_obs_sel <= 1'b0;
      PI_vco_div2 <= 1'b0;
      PI_n_sel <= 3'b000;
      PI_cp_trim_in <= 2'b00;
      PI_rst_n <= 1'b1;
      PI_pll_en_in <= 1'b0;
    end

    // state 2
    if (cycle == 1) begin
      PI_obs_sel <= 1'b0;
      PI_vco_div2 <= 1'b1;
      PI_n_sel <= 3'b000;
      PI_cp_trim_in <= 2'b00;
      PI_rst_n <= 1'b1;
      PI_pll_en_in <= 1'b0;
    end

    // state 3
    if (cycle == 2) begin
      PI_obs_sel <= 1'b0;
      PI_vco_div2 <= 1'b0;
      PI_n_sel <= 3'b000;
      PI_cp_trim_in <= 2'b00;
      PI_rst_n <= 1'b1;
      PI_pll_en_in <= 1'b0;
    end

    // state 4
    if (cycle == 3) begin
      PI_obs_sel <= 1'b0;
      PI_vco_div2 <= 1'b1;
      PI_n_sel <= 3'b000;
      PI_cp_trim_in <= 2'b00;
      PI_rst_n <= 1'b1;
      PI_pll_en_in <= 1'b0;
    end

    // state 5
    if (cycle == 4) begin
      PI_obs_sel <= 1'b0;
      PI_vco_div2 <= 1'b0;
      PI_n_sel <= 3'b000;
      PI_cp_trim_in <= 2'b00;
      PI_rst_n <= 1'b1;
      PI_pll_en_in <= 1'b0;
    end

    // state 6
    if (cycle == 5) begin
      PI_obs_sel <= 1'b0;
      PI_vco_div2 <= 1'b1;
      PI_n_sel <= 3'b000;
      PI_cp_trim_in <= 2'b00;
      PI_rst_n <= 1'b1;
      PI_pll_en_in <= 1'b0;
    end

    // state 7
    if (cycle == 6) begin
      PI_obs_sel <= 1'b0;
      PI_vco_div2 <= 1'b0;
      PI_n_sel <= 3'b000;
      PI_cp_trim_in <= 2'b00;
      PI_rst_n <= 1'b1;
      PI_pll_en_in <= 1'b0;
    end

    // state 8
    if (cycle == 7) begin
      PI_obs_sel <= 1'b0;
      PI_vco_div2 <= 1'b1;
      PI_n_sel <= 3'b000;
      PI_cp_trim_in <= 2'b00;
      PI_rst_n <= 1'b1;
      PI_pll_en_in <= 1'b0;
    end

    // state 9
    if (cycle == 8) begin
      PI_obs_sel <= 1'b0;
      PI_vco_div2 <= 1'b0;
      PI_n_sel <= 3'b000;
      PI_cp_trim_in <= 2'b00;
      PI_rst_n <= 1'b1;
      PI_pll_en_in <= 1'b0;
    end

    // state 10
    if (cycle == 9) begin
      PI_obs_sel <= 1'b0;
      PI_vco_div2 <= 1'b1;
      PI_n_sel <= 3'b000;
      PI_cp_trim_in <= 2'b00;
      PI_rst_n <= 1'b1;
      PI_pll_en_in <= 1'b0;
    end

    // state 11
    if (cycle == 10) begin
      PI_obs_sel <= 1'b0;
      PI_vco_div2 <= 1'b1;
      PI_n_sel <= 3'b000;
      PI_cp_trim_in <= 2'b00;
      PI_rst_n <= 1'b1;
      PI_pll_en_in <= 1'b0;
    end

    genclock <= cycle < 11;
    cycle <= cycle + 1;
  end
endmodule
