Hive-RSI-Lab/ece298a-pll/(commit log)

2026-10-14 check.sh runs iverilog through chip-flow's eda when it isn't on PATH (#9)
    Claude-Session: https://claude.ai/code/session_012Te5n3RsLrG27y71cTY1uH
2026-10-29 Continue the PLL from where it stopped on 10-12, with the chip-flow module
    * Close the analog H1 open items: skew corners, VCO ceiling at every co…
    …rner, jitter estimate; gates pass on 31 corners
    The analog spec sweeps ss_pff and ff_pss (grid extra), scores vco_fmax_ff_mhz
    150..370 MHz at every corner (it peaks at 362.9 MHz at ff, -40 C, 2.97 V),
    replaces the never-printed jitter warning with a written estimate, and
    corrects the 331.75 MHz label. spec_lint, netlist_lint, sim_tt, sim_pvt (31
    corners) and bench_strength pass. interface.yaml's vco_out load reads 370 MHz;
    split re-passes. Adds the pex bench under analog/layout_ref.
    * Digital: time the VCO clock at 2.7 ns; every gate fres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
2026-10-29 pll gets a score: the share of its goals' checkable done-lines that pass on main
    …n from scratch (#5)
    tests/score.sh re-runs, from a scratch copy of blocks/pll, the gates behind
    each done-line in GOALS.md (analog spec_lint and the 31-corner PVT sweep,
    digital harden and STA with vco_out at 2.7 ns, the three loop layers and the
    100 MHz co-sim lock, analog DRC/LVS/pex_sim) and prints 100 x the share that
    pass, corners counted one by one. Set as the project's score.
2026-10-29 The PLL's /2 prescaler keeps up with the fastest VCO at every corner: decide and fix digital issue 8
    * pll issue 8: faster /2 prescaler stage, runaway recovery, ss 2.7 ns c…
    …orner waived with its numbers
    Stage 0 is a hand-placed dffrnq_2 + inv_1 (274 MHz at ss after routing, was
    238 MHz), stage 1 clocked through its own buffer so CTS stays off the toggle
    loop. The lock detector gains a recovery: 1024 unlocked reference cycles with
    pll_en force DN for 128. Loop model at ss_pff (tb/prescaler_margin.py) backs
    the ss bound; the corner waiver is in digital/state.json issue 8.
    * pll digital: formal pass recorded after issue 8 (pdr PASS, every cove…
    …r reached)
2026-10-29 The PLL's analog layout passes its post-layout benches on the extracted netlist at every scored corner
    …he extracted analog layout
    layout/pex_pvt.py runs layout_ref/pll_analog_pex_pvt_tb.cir (the pex bench
    with the corner left open, bounds = spec.yaml post_layout_bounds) through
    chip-flow's sim_run at all 31 corners of the spec's sweep on the extracted
    netlist; tests/score.py counts the corners it passes. gen_pll_analog.py
    labels every routed internal net (non-pin metal3), because magic's
    extresist dropped the coupling C of unlabelled nets: the typical VCO was
    226 MHz on that extraction and is 196 MHz with it complete. Misses:
    tt_27c fmax 196 < 200 MHz, ff_pss Kvco 35 < 40 MHz/V.
2026-10-29 The extracted analog layout passes its post-layout bounds at the last two corners: tt_27c fmax and ff_pss Kvco
    gen_pll_analog.py redraws the VCO ring block for less capacitance on
    r1..r5: each inverter-row device's gate via sits over its left pad (its
    outer pads leave away from the channel), so the gate jog spans only the
    gate pads and columns sit 0.6 um apart (were 1.2/1.8); the NAND and output
    inverter are top-aligned with the stage inverters, so no stub crosses
    their extra height (the N half's channel starts 1.5 um lower); the NAND's
    r5 input comes first; the ring channel pitch is the rows' 0.8 um. Implant
    gaps under the closer columns are filled (NP.2/PP.2).
    Extracted (pex_sim's flow) r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
2026-10-29 goals.md carries the person's 10-29 13:53-13:56 words: open-ended, always better
    …ways better
2026-10-30 Bring GOALS.md up to date: the analog sign-off is recorded and four PRs have landed
    * Bring GOALS.md up to date: the H1-ada9eb sign-off is recorded and fiv…
    …e PRs have landed (#4)
    * check.sh falls back to the toolchain's own iverilog under $EDA_TOOLCH…
    …AIN when there's no chip-flow eda wrapper
    * Merge main: keep main's goal statuses, with the sign-off as recorded …
    …(#6) and the merged PRs in Closed
    * Merge main: take main's GOALS.md, with goal 1's What telling the sign…
    …-off as given
2026-10-30 goals.md carries the person's 10-29 21:13 words: build through to ready for submission, review retroactively
    …dy for submission, review retroactively
2026-10-30 pll's tests run on its forge CI (GitHub Actions), not on this machine
    * pll's test runs on GitHub Actions in the IIC-OSIC-TOOLS 2026.09 image…
    …, named in forge_tests
    * Merge main: keep main's forge_tests (check); the image job runs along…
    …side it
2026-10-30 pll's score counts the Harden goal: top_harden, top DRC, top LVS and the Tiny Tapeout precheck each a line
    * pll's score counts the Harden goal: top_harden, top DRC, top LVS and …
    …the Tiny Tapeout precheck each a line
    * score: run top_drc, top_lvs and precheck on top_harden's output wheth…
    …er or not its own LVS passed
    * Harden lines score top_harden, top_drc, top_lvs and precheck's record…
    …ed results while they hold; record today's (failing) top gate runs
2026-10-30 The post-layout bias reference lands in one operating point at every corner: settle the 168 uA state at ss_m40c_vm10
    * The bias reference releases its start-up at every corner: MN_ST 4 um …
    …long, no 168 uA state at ss_m40c_vm10
    At ss_m40c_vm10 the start-up never released: with vst high MN_ST (0.5/2)
    sank ~38 uA from vbp, MN_B2 went triode so vref followed vbp to 0.76 V,
    below MN_STD's threshold, and Ib sat at ~42 uA (Icp 168 uA). Pre-layout
    the release margin was 84 nA; extracted it was stuck. MN_ST at l=4 um
    leaves >= 15.9 uA of release margin at every corner (extracted).
    Post-layout pex_pvt: 30/31 (ff_pss Kvco, the owner's). The generator
    fills an M3.2a notch between two via landing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
2026-10-30 pll digital issue 8: time vco_out at the post-layout VCO ceiling plus margin, not 2.7 ns
    …eiling plus margin (ss 4.0 ns, tt/ff 2.7 ns), not 2.7 ns everywhere
2026-10-30 pll review page for the Nov 5 evaluation: one place the person can see every stage work
    * Every stage of the PLL on one page: docs/review/stages.md, written fr…
    …om the recorded gate reports, with how to see each one work
    * Drop the review page's score line: the score measures the PLL, not do…
    …c freshness; check.sh's note stays
2026-10-30 Build it all the way through to ready for submission and make sure to make it possible for me to review to work/see it
    * A review page for the PLL: where it stands, pictures, and the decisio…
    …ns taken without the owner
    docs/review/README.md is the one page to review the PLL from: a table of
    every stage with its evidence, the analog macro's layout, the co-simulated
    lock and the post-layout results at all 31 corners (drawn by
    docs/review/make_figures.py from what the repository records, no EDA tools
    needed), why each failing corner fails, the six decisions taken without the
    owner (each pending their review), and what is left before the tile is
    ready for submission.
    blocks/pll/analog/lo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
2026-10-30 After the MOS-cap tile (261030-011402) and the MN_ST bias fix (261030-001020) both land: bench_strength re-recorded, la…
    blocks/pll/analo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
2026-10-30 pll analog layout: decide ff_pss Kvco and make tt_pss converge deterministically, then close the layout goal
    * The analog layout passes its post-layout bounds at all 31 corners: ff…
    …_pss Kvco read on the settled ring, the loop's phase margin gated post-layout
    ff_pss's Kvco miss (36.1 vs 40 MHz/V) was the post-layout bench reading the
    top of the VCO range 10..45 ns into a tran whose bias was still settling
    from the op: 4-8 % under the settled frequency. Read over 100..250 ns (up to
    30 periods), ff_pss reads f(vdd-0.3) 128.0 MHz and Kvco 40.7; R_V2I could
    not have moved it (the MN_CL ceiling sets the top of the range there).
    The bench also measures the loop's phase margin on the extrac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
2026-10-30 Look into the score dip after d04ad791: pll analog layout: decide ff_pss Kvco and make tt_pss converge deterministicall…
    … d04ad791's SDC (vco_out ss 3.75 ns), which left them stale
2026-10-30 pll digital issue 8 closes at ss by design: the first /2 stage meets the ss VCO ceiling with margin
    * pll digital issue 8 at ss: vco_out setup uncertainty derived from the…
    … jitter estimate (0.10 ns), first stage placed by hand
    * pll issue 8: hand placement of the /2 stage did no better than the pl…
    …acer; record the routed ss spread under the derived uncertainty
2026-10-30 pll system verification: the loop locks in co-sim with the extracted analog netlist at the corners that bound its range
    * pll: co-sim the loop on the extracted analog netlist at the corners t…
    …hat bound its range (tb/cosim_corners.py, score line; WIP, no recorded run yet)
    * pll system verification: the loop on the extracted analog netlist at …
    …the four corners that bound its post-layout range
    tb/cosim_corners.py runs the cosim bench (same 100 MHz point, bounds, evidence checks) on the layout's
    parasitic extraction at ff_pss, ff_m40c_vm10, ff_125c_vp10 and ss_m40c_vm10 (lowest/highest VCO ceiling
    and phase margin, lowest Kvco and Icp, from the recorded pex_pvt). It locks and hol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
2026-10-31 pll tile re-hardened on the current SDC, and check.sh fails when the tile's recorded harden goes stale
    91ec795 changed digital/harden/constraints.sdc after the tile was last
    hardened, so top_harden, top_drc, top_lvs and precheck were stale and
    gds/ held the old SDC's tile. Re-ran all four (pass; setup WS 2.18 ns,
    hold WS 0.51 ns) and copied the new GDS with blocks/pll/tt/assemble.py.
    tests/check_tile.py (step 4 of tests/check.sh) needs only python3 and
    PyYAML, so it runs in CI: it hashes top_harden's inputs the way chip-flow's
    statelib does (and cross-checks statelib when CHIP_FLOW_HOME is set),
    requires top_drc/top_lvs/precheck to postdate top_harden, and requires
    gds/ to be the GDS they c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
2026-10-31 pll digital #48: clock the digital half at vco_div2 (VCO/2 from the macro's TSPC stage)
    - ihsan_sa_pll's vco_out input becomes vco_div2 (ui_in[3] in the
    standalone tile); pll_prescaler is plain RTL /4 on vco_div2, so clk_pre
    stays VCO/8 and obs_q3 VCO/16. The hand-instantiated dffrnq_2 first
    stage, its clkbuf and their dont_touch/must_keep entries are gone.
    - constraints.sdc: vco_div2 at 2x the per-process post-layout ceiling
    period (ss 7.5, tt/ff 5.4 ns); the jitter-derived setup uncertainty is
    0.20 ns over a vco_div2 period (two VCO periods), set from vco_div2 and
    pre_q0 (STA's launch clock for the toggle loop).
    - tb/holdout/formal/spec/digital_spec.yaml follow the rename and r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
2026-10-31 pll issue 8 with real ss margin: a TSPC /2 in the analog macro, the digital half clocks at vco/2
    Analog (blocks/pll/analog): netlist block 8, a 9T TSPC flop with D = its own
    inverted output, MP_DR holding it static in standby, a 2-inverter buffer onto
    the new pin vco_div2. vco_out is internal now (the macro's pins are the
    interface's); benches read xdut.vco_out. The divider sits in the ring block
    (gen_pll_analog.py), NMOS/PMOS paired so the shared channel has no track cycle.
    drc 0, lvs match, sim_tt, sim_pvt 31 corners, pex_sim and pex_pvt 31/31 pass;
    post-layout ceilings move at most 0.9%. presc_tb now measures the macro's own
    divider, from 25 ns (a start-up runt on vco_out read the ratio 0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
2026-10-31 pll #47: vctrl settles at all four bounding corners with the gate-level digital in the loop
    tb/cosim_gl.py runs cosim_corners' bench with the hardened netlist + SDF in
    place of the RTL (0.25 ns sync, TSPC /2 extraction): 4/4 corners lock and
    settle, vctrl p-p 2.4 / 7.2 / 3.5 / 15.9 mV. The RTL run on the same cell
    and grid (re-recorded) still has 27.0 / 20.3 mV at ff_pss / ff_m40c_vm10:
    lone pump kicks from the zero-delay PFD reset, which the gate-level PFD's
    reset pulse removes. score.py reads the vctrl line from the gate-level
    record (fresh while its tracked inputs hold); stages.py shows both; GOALS
    and tb/README updated.
2026-11-01 pll: commit the GL netlist/SDF/SPEF the cosim ran; SDF by process+temperature; vctrl pad option; coverage bench (WIP, runs pending)
2026-11-01 pll: record the pad-loaded, temperature-matched and N-step closed-loop runs and the pad phase margin at 31 corners
2026-11-01 analog: Monte Carlo with the PDK's mismatch models, spec note corrected
    spec.md said GF180 models carry no per-instance mismatch. The MOS models do
    (.lib fets_mm, off by default through sw_stat_mismatch); only the poly
    resistors have none.
    mc/mc_mismatch.py runs the benches' stimulus with the statistics on, on the
    schematic, with m=N instances split into N devices because the wrapper ignores
    m. Recorded: mismatch at tt_27c (200), global + mismatch at tt_27c (100),
    cp at ff_pss, ss_pff and ff_m40c_vp10 (200 each), startup at ss_m40c_vm10 (100).
    cp_updn_mismatch_pct exceeds its 10 % bound under mismatch at ff_pss (52/200)
    and ff_m40c_vp10 (12/200). No bound, netlist or gate input changes her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
2026-11-01 paper + tb README: the outside review's follow-ups: pad load, matched SDFs, divider steps, jitter, mismatch
2026-11-01 paper: pad cost measured on the extracted cell; stages regenerated
2026-11-01 pll digital: every vde gate fresh on chip-flow 08fb994 (lec and release need chip-flow #182)
    #150: every check: measure bound names a recorded source. REQ-TIM-VCO's bounds
    are now the recorded slacks. REQ-MUT-KILL restated: mutate.kill_rate is
    gate-read, and tb/named_mutants.py kills the four named mutants (4/4, a record
    no gate reads, until chip-flow #155). REQ-LOOP-RELOCK keeps its text, sourced
    to the msde cosim and deferred at this release; the msde release reads it
    missing until cosim records it. The cosim_cov evidence, with the ff_pss miss at
    120 MHz, is in the bound's note.
    #158/#175: spec/cdc.yaml waives every CDC and RDC finding with its reason, and
    declares the raw pins async, whi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
2026-11-01 pll jitter: period jitter on the extracted cell at 100 MHz, closed-loop model
    Period jitter 9.7 ps tt_27c, 10.2 ps ss_125c_vm10, 13.5 ps ff_125c_vm10 (highest
    of 9 corners run). Locked output about 35-60 ps rms from a linear model that
    leaves out reference, PFD, charge-pump and supply noise. Replaces the scratch
    1.2 / 2.5 ps figures. See blocks/pll/analog/jitter/RESULT.md.
2026-11-01 paper: jitter paragraph with ff_125c_vm10 and the closed-loop model
    Period jitter 9.7 / 10.2 / 13.5 ps; locked output 44-61 ps rms from a linear
    model, labelled as such with what it leaves out. STA check redone at the worst
    2T figure, about 155 ps at 7 sigma. Numbers: h2/jitter, blocks/pll/analog/jitter/RESULT.md.
2026-11-01 PLL: closed loop with a mismatched pump; jitter paragraph final
    UP/DN skew of about 3 sigma, extracted + gate-level: all lock and hold within
    20 mV. The 10 % bound stays and the pump is not resized.
2026-11-01 pll analog: spec migration to chip-flow 29c43ce+: TSPC devices declared, mc on, pex bench corner-aware
    spec_lint, netlist_lint, sim_tt, sim_pvt, drc, lvs, pex_sim and mc pass.
    bench_strength fails: 23 survivors, 22 on the TSPC devices plus xMN_UPI. Not landed.
2026-11-02 pll: macro_lib passes on the extracted cell at tt, ss, ff
    bias_ref carries its pad's 5 pF through the new pad_caps_pf (chip-flow
    macro-timing-includes). A bare node bursts after pll_en, as tb/pll_analog_tr.sp
    already recorded. Warnings: none. tt and ff keep their 5.4 ns periods with
    period_margin 0.25.
2026-11-03 pll analog: bench_strength passes, 256 of 295 killed, 39 ruled below spread
    5 new rulings from the run's deltas, all under the 2% floor: the TSPC's xMN_DB
    size, xMP_DR size, xMP_DB bulk (the other 19 divider survivors now die at tt), and
    the ring's xMN_I4, xMP_I3 bulk, whose old kills were the 1 fC kick's start at 0.3 V.
    xMP_G2's two deltas rewritten for the 200 fC kick. Chip-flow at 3d9947c.
2026-11-03 pll cosim: REQ-LOOP-RELOCK gets a measure, relock 3.28 us at tt
    The gate's own run steps N 2 -> 3 after its window and records lock's drop and
    last rise. Corner runs don't step. Every other measure stays on the run before
    the step. Bound 50 us, from the digital spec. One point at tt, schematic cell.
2026-11-03 pll top: harden, drc, lvs, precheck pass with macro libs, split fixed
    vctrl and bias_ref reach ua[0] and ua[1] in the final netlist (chip-flow PR 186).
    Setup +2.23 ns, hold +0.53 ns. analog_spec.yaml's vco_out becomes vco_div2.
    Max slew: 16 at ss, not a gate today (chip-flow #177 open).
2026-11-03 pll digital: kept clkbuf_8 on pfd_up and pfd_dn
    At ss the macro pins read 0.84 and 0.78 ns against a 0.5 ns limit, driven by
    whatever repair inserted. u_pfd_up_obuf and u_pfd_dn_obuf sit past the reset
    loop, on the recovery override's output, and the lock detector stays on the
    unbuffered net. Reset loop connections are unchanged in the netlist.
    must_keep and RSZ_DONT_TOUCH_RX cover both cells. Every vde gate re-run and
    fresh on chip-flow 060955d. Log and build outputs stay out, as in 8507aba.
2026-11-03 pll: top gates pass on the kept clkbuf_8 pfd drivers
    split, top_harden, top_drc, top_lvs, precheck and cosim recorded on merged
    digital. pfd_up/pfd_dn reach the macro at 0.36-0.40 ns at ss (0.11-0.13 at ff),
    which transistor sim puts at a 0.48 ns linear edge, inside the 500 ps overlap
    bench.
2026-11-03 pll: tie the tt overlay to the generated wrapper and ship the powered netlist
    src/project.v and src/pll_analog.v now say the same code as top/harden and
    top/macros, so release's deliverable_untied check holds without changing it.
    Without power pins in project.v, gds.yaml's verilog_path points at gl/, the
    powered P&R netlist assemble.py copies. tb.v wires power only under GL_TEST;
    the RTL test sources test/pll_analog_model.v in place of the stub.
    check_tile.py lagged chip-flow's input kinds and failed on every one it didn't
    know. It now hashes those in the repo and leaves the PDK and generated tree to
    the statelib comparison under CHIP_FLOW_HOME.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
2026-11-03 pll: refresh tb/gl from the current digital harden, regenerate stages.md
    The cosim_gl record is stale until the GL corners re-run; paused before that.
2026-11-04 pll: corner cosim records with the relock step (RTL 2/4, GL 3/4 meet every bound)
    ff_pss cannot relock to 150 MHz in either: vctrl rails at VDD (3.6 V),
    the VCO ceiling there is below 150 MHz in the cosim. RTL ff_m40c_vm10
    settles at the new vctrl but its lock flag never drops, so relock_time_us
    is missing; GL at the same corner relocks in 3.12 us. RTL ff_m40c_vm10 and
    ff_pss also miss the 20 mV vctrl p-p bound, as on 10-31.
2026-11-04 pll: regenerate stages.md
2026-11-04 pll: record the msde release gate (pass)
    The staged tree under blocks/pll/release/tt is not committed: it is a copy
    of the shipped tt/ tree; manifest.json carries its hashes.
2026-11-04 pll: ff_pss VCO margin, so all six bounding corners relock to 150 MHz
    - analog: V2I/clamp resize (rv2i_l 43 um, clamp 50/1 um) lifts the ff_pss
    post-layout ceiling from 125.6 to 168.2 MHz. sim_tt, sim_pvt, drc, lvs,
    bench_strength (one new below_spread ruling from the warden, not ours)
    and release all pass.
    - cosim on the extracted cell, six bounding corners: RTL locks at all six
    and relocks N 2->3 within 4.1 us. GL with SDF passes all six. The one RTL
    miss is ff_pss's 23.1 mV p-p, from the RTL PFD's zero-width reset; at gate
    level the same corner reads 2.6 mV.
    - top: top.override.json excludes weak buffer/delay cells, so the resizer
    can no longer pick an undersized repeater on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
2026-11-04 pll: assemble the tile from the new harden; check_tile hashes the override inputs
    check_tile.py did not know top_override and digital_override, which
    top_harden now records (same path and norm as chip-flow's invalidation.yaml,
    so statelib's own hashes are compared against them when CHIP_FLOW_HOME is
    set). gds/, lef/ and gl/ are re-assembled from the passing harden.
    Regenerate stages.md.
2026-11-04 paper: update to final cell revision (Nov 4 records)
    Six bounding GL corners with N 2->3 relock, cosim_cov_150, 31-corner PEX
    table, digital gate results; previous-cell results (pad, jitter, MC samples,
    120 MHz step, N=4) marked as such. Figures and sim data regenerated.
2026-11-05 pll: final-cell runs (pad, jitter, MC, N=4/5, 120 MHz step, pump step) and paper
    Re-run on the final analog cell (e687a1c), gate level + SDF:
    - cosim_cov.json: N 1->3->2 at 5 MHz, 7/7 pass, relock at 120 MHz 4.5-6.7 us
    - cosim_cov_n4.json: N=4 (160 MHz), 7/7 lock 5.2-10.2 us
    - cosim_cov_n5.json: N=5 (200 MHz), 3/7; at ss_125c_vm10, ss_125c_vp10,
    ff_pss and ss_m40c_vm10 the VCO is at or past its ceiling
    - cosim_pump_step.json: skewed pump through an N step, 5/5 pass
    - 5 pF pad corners, jitter_pex, mismatch and global+mismatch Monte Carlo
    - cosim and release gates re-run: pass
    The paper takes all of these; the abstract now states the 200 MHz limit.
    log/cosim_cov is rebuilt from its record (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
2026-11-10 pll: PFD UP/DN on uo[3] and uo[4] in the tile (pad: true), pin test, review doc
    - interface.yaml: pfd_up and pfd_dn keep their uo pads (chip-flow pad: true)
    - info.yaml (root and tt): uo[3] PFD_UP, uo[4] PFD_DN
    - tt/test: test_pfd_pins counts UP and DN pulses on the pins when locked
    - docs/info.md: the pins, and the every-corner VCO range from pex_pvt.json
    (13 to 165 MHz; it still said 12 to 114)
    - docs/review: decision 6 done; decisions 8 (V2I/clamp resize) and 9 (PFD
    drivers, buffer exclusion) listed with their evidence; decision 4 numbers
    from the current record
2026-11-10 pll: re-harden the tile with PFD UP/DN on uo[3]/uo[4] on the current chip-flow
    - tb: the cosim bench instantiates tt_frame_ihsan_sa_pll (the gate's generated
    TT frame with the pad reset synchroniser), and the pad condition (a copy of
    tb/ under log/cosim_pad) reads the block's inputs from the workspace;
    pll_analog_ua wrapper carries vctrl/bias_ref for the pad model
    - macro_lib re-characterised on the regenerated extraction
    - top_harden, top_drc, top_lvs and precheck pass; gds/, lef/, gl/ re-assembled
    - tt/src/project.v regenerated by ttlib.generate_tt_project: pfd_up/pfd_dn on
    uo[3]/uo[4], and the reset synchroniser the tile was hardened with
    - tests/check_tile.py: precheck now record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
